rlwoodjr/Router-Files/DRO/DSC_0015.JPG

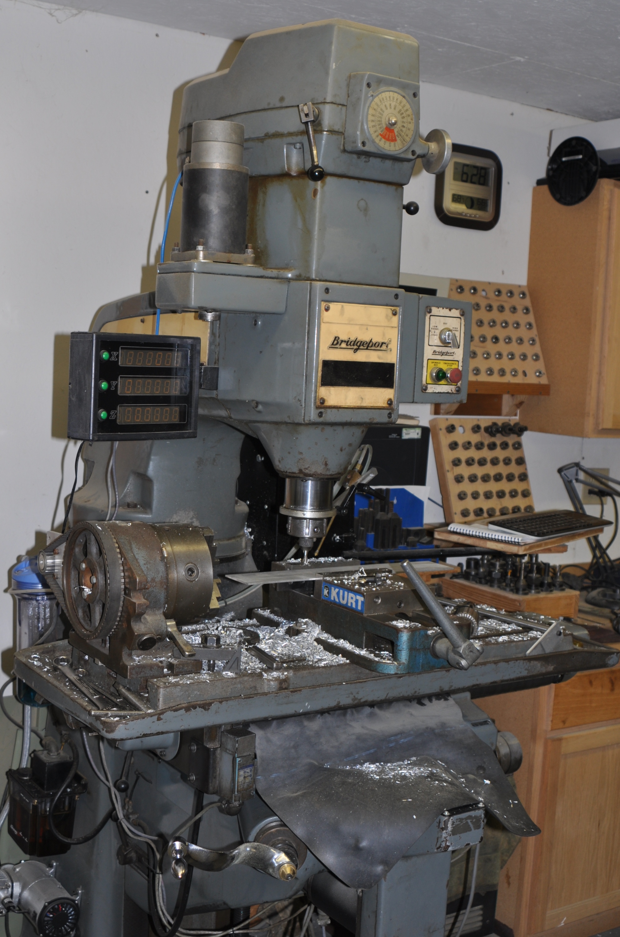
DRO/DSC_0015.JPG
