rlwoodjr/Router-Files/README.md

# Router-Files
Design files for CNC routers

SAFETY FIRST: Never leave a CNC router unattended!  

You will find all my design files free to use and modify for personal or commercial use.  You will need a good understanding to build a safe router. By downloading or using these files you accept full responsibility for your build. This content may be in error. You assume responsibility for any action you take using these designs. 

BobsCNC is trademarked and cannot be used.

If you have questions or missing data, please let me know. 

All parts I have in inventory will be on my eBay store
