rlwoodjr/Router-Files/DRO/DRO1.JPG

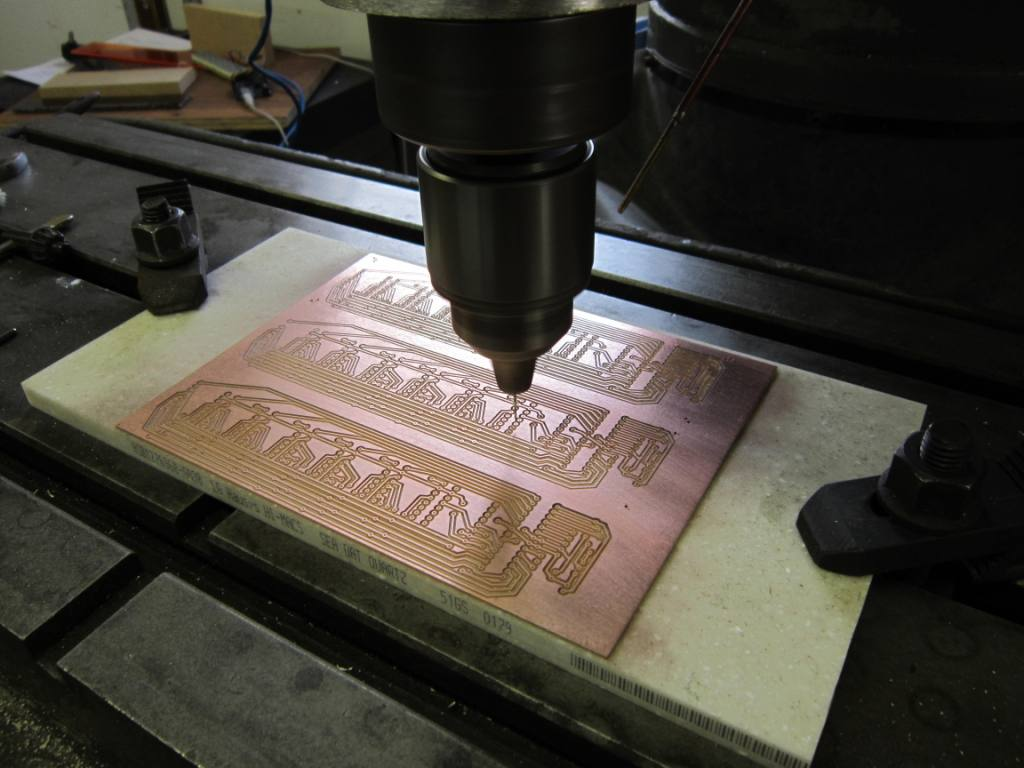
DRO/DRO1.JPG
