rlwoodjr/Router-Files/DRO/DRO2.JPG

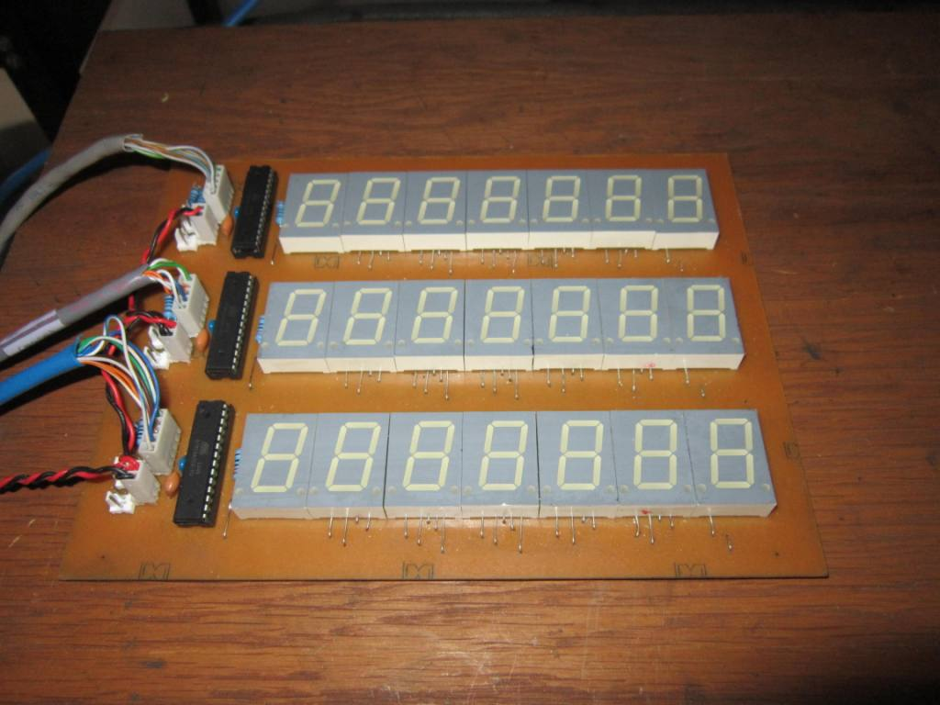
DRO/DRO2.JPG
