rlwoodjr/Router-Files/DRO/DRO3.JPG

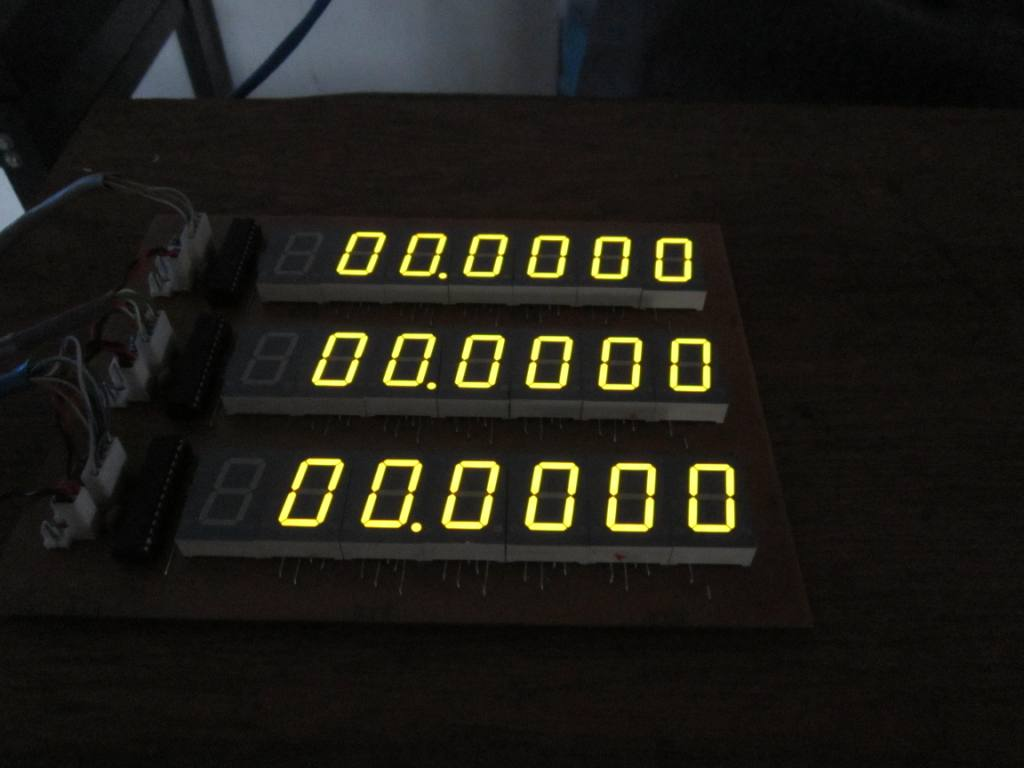
DRO/DRO3.JPG
