rlwoodjr/Router-Files/DRO/DSC_0011.JPG

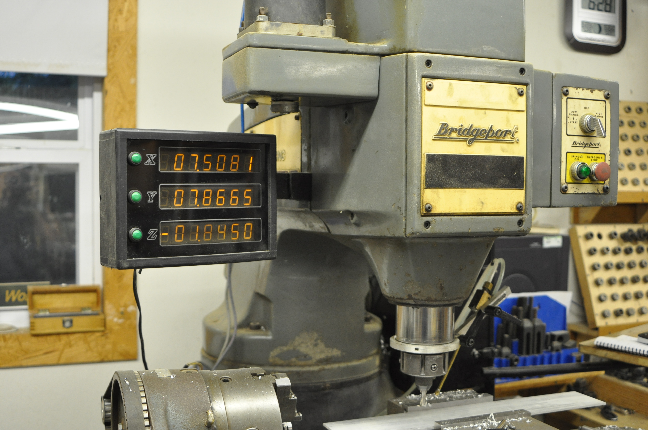
DRO/DSC_0011.JPG
