rlwoodjr/Router-Files/DRO/DSC_0014.JPG

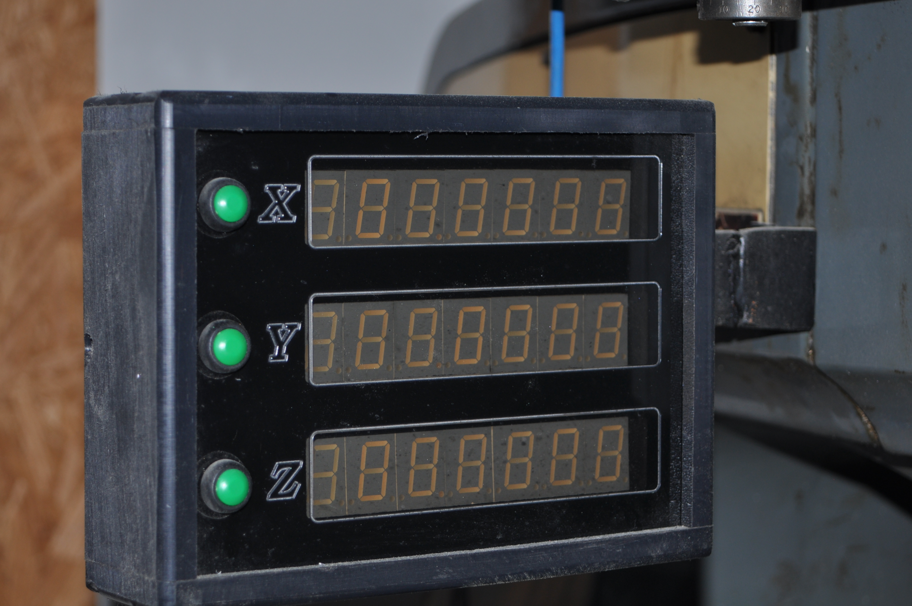
DRO/DSC_0014.JPG
