rlwoodjr/Router-Files/Evolution/Sourced Parts/Tr8 Metric ACME screw B.jpg

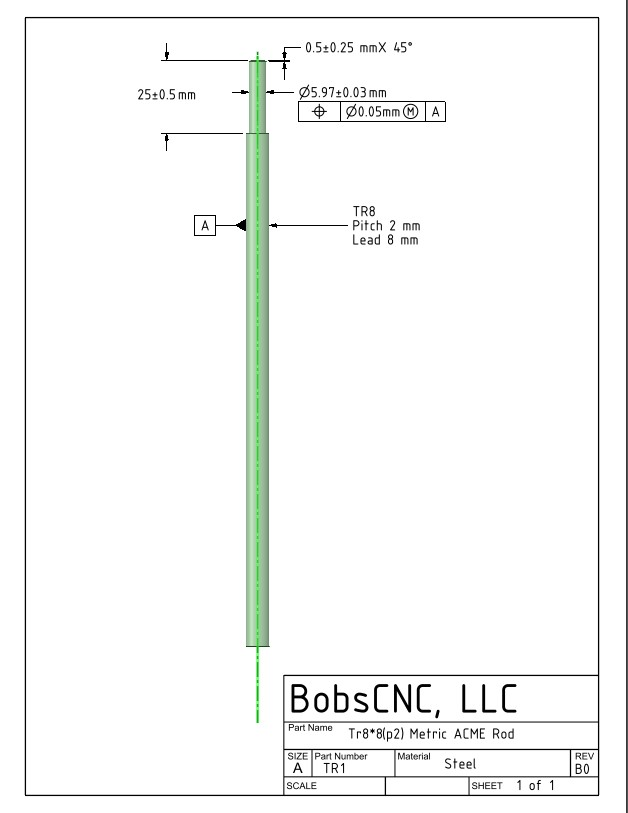
Evolution/Sourced Parts/Tr8 Metric ACME screw B.jpg
