rlwoodjr/Router-Files/Revolution/Sourced parts/TailStock rod.png

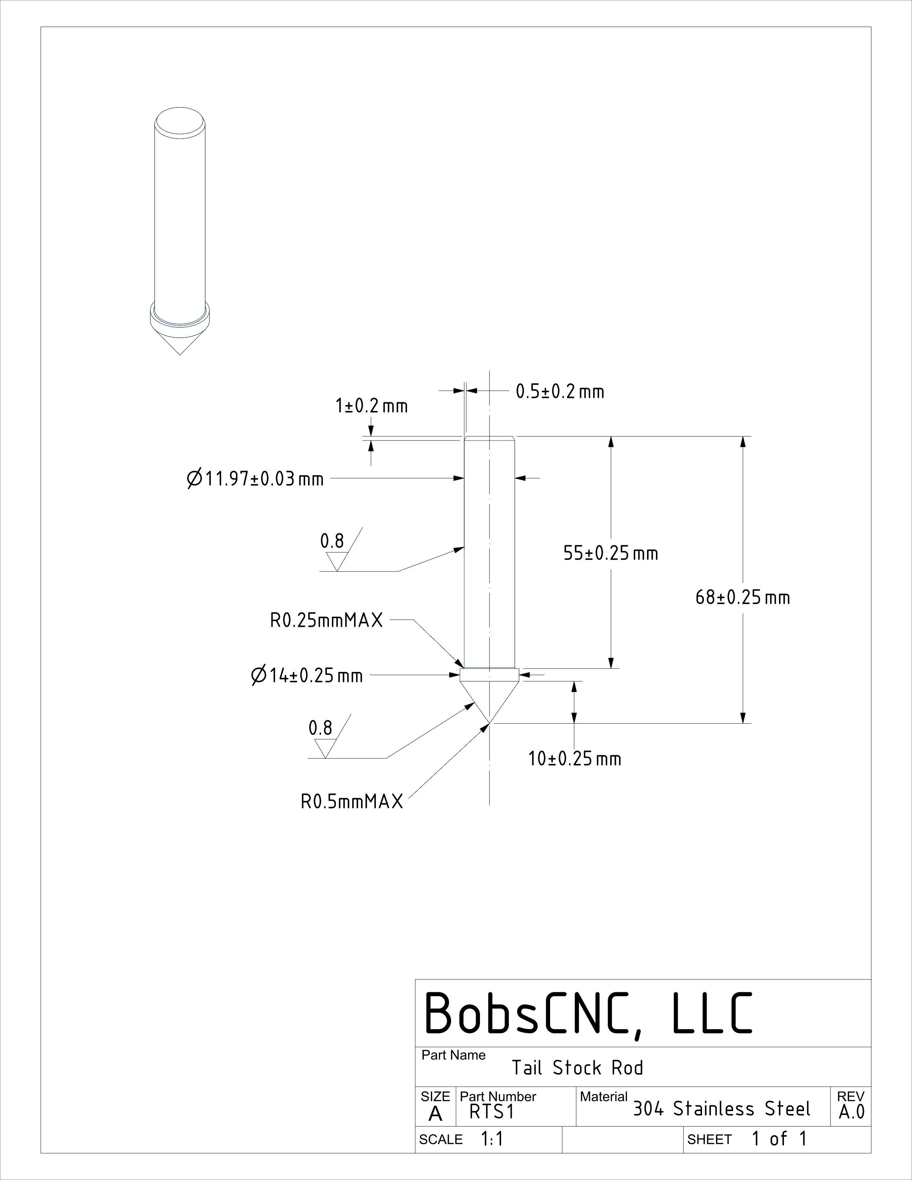
Revolution/Sourced parts/TailStock rod.png
