rlwoodjr/Router-Files/KL7/KL RF1101/RT1101F Z Assembly.dxf

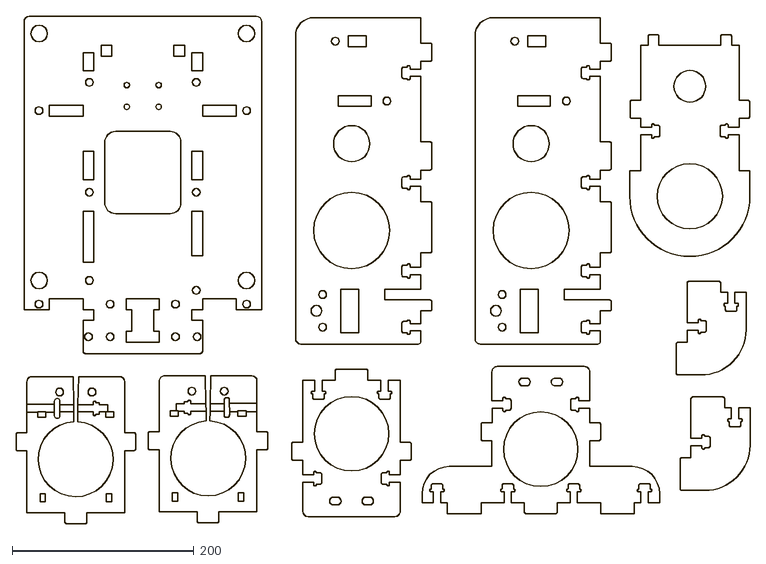
[picture p12: CAD file, 2025-02-18]
KL7/KL RF1101/RT1101F Z Assembly.dxf
808.4 x 558.9
