rlwoodjr/Router-Files/E Series/52mm layout Evolution.dxf

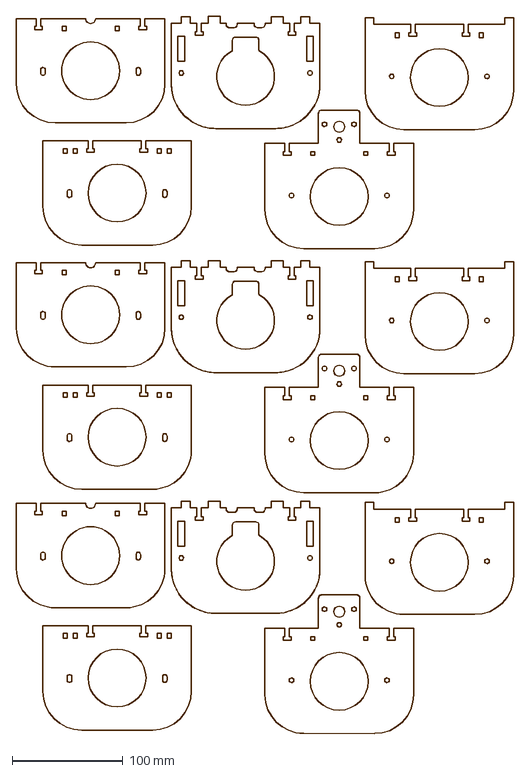
[picture p13: CAD file, 2025-02-18]
E Series/52mm layout Evolution.dxf
448.4 x 646.4 mm
