rlwoodjr/Router-Files/Evolution/E4D2.dxf

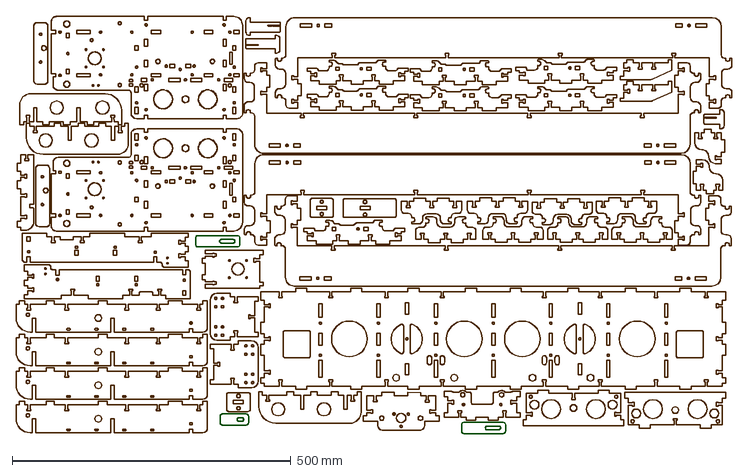
[picture p14: CAD file, 2025-02-18]
Evolution/E4D2.dxf
1282.8 x 747.5 mm
