rlwoodjr/Router-Files/Evolution/Evolution 4 to 5/Extension Layout.stp

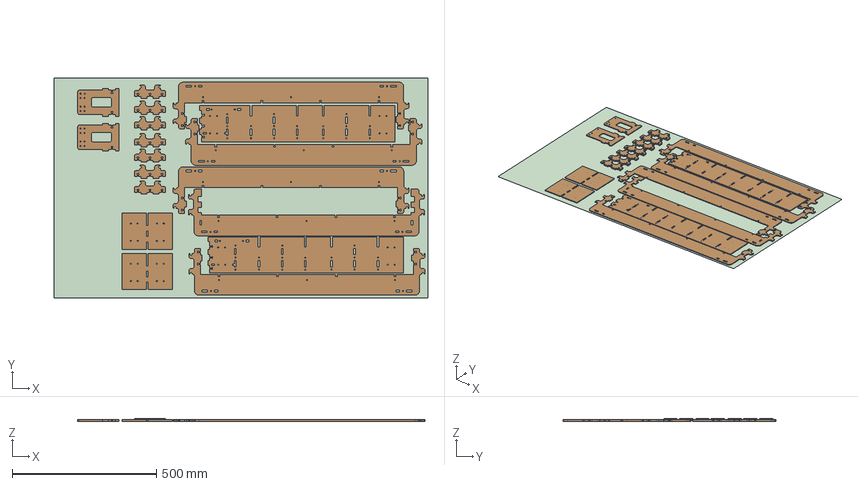
[picture p15: CAD file, 2025-02-19]
Evolution/Evolution 4 to 5/Extension Layout.stp
1295.4 x 762.0 x 9.00 mm
Extension Layout
RailSide2 x 2
ExtBrace x 2
BedBrace2
Rail Support x 7
X harness mount.2 x 2
BedBrace x 4
