rlwoodjr/Router-Files/Evolution/Sourced Parts/EccentricNut.stp

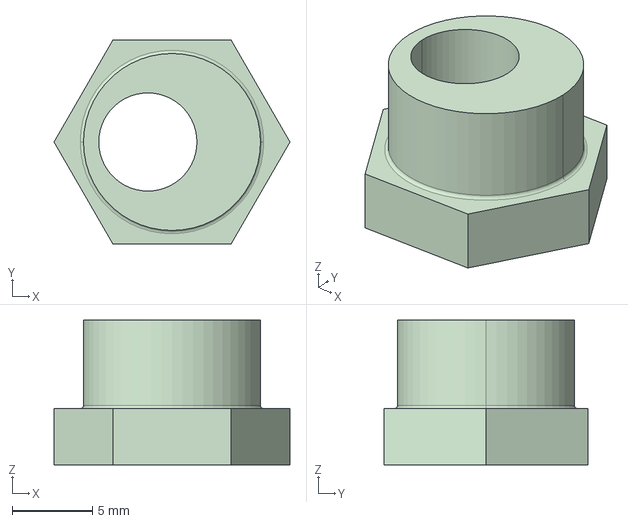
[picture p16: CAD file, 2025-02-18]
Evolution/Sourced Parts/EccentricNut.stp
14.7 x 12.7 x 9.00 mm
