rlwoodjr/Router-Files/KL7/80mm KL7/#Spindlemount 80mm.dxf

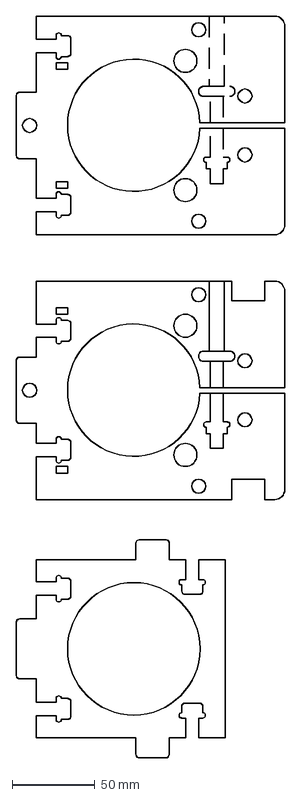
[picture p17: CAD file, 2025-02-15]
KL7/80mm KL7/#Spindlemount 80mm.dxf
162.2 x 448.0 mm
