rlwoodjr/Router-Files/KL7/Control box/PIBoxLayout.stp

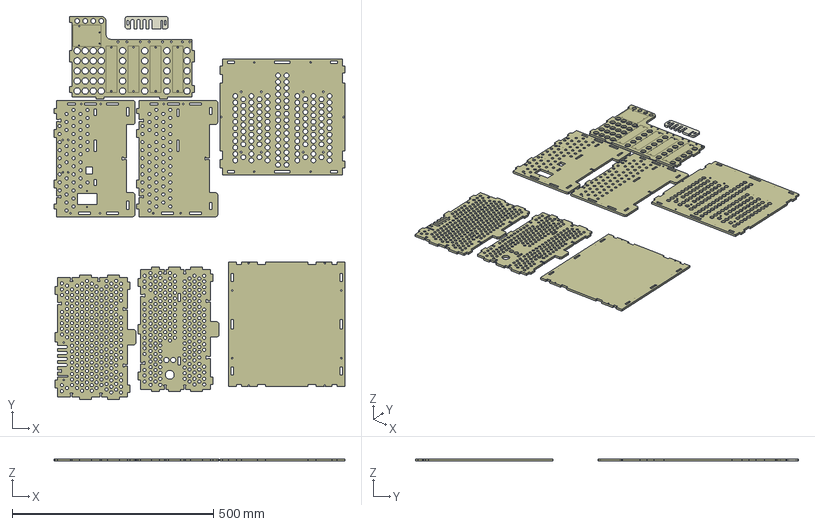
[picture p18: CAD file, 2025-02-15]
KL7/Control box/PIBoxLayout.stp
723.1 x 952.3 x 6.00 mm
Wood Back
Wood Back2
Wood Bottom
Wood shelf
Wood side
Wood side2
Wood top
WireLock
