rlwoodjr/Router-Files/KL7/KL733/KL733 Layout 2.dxf

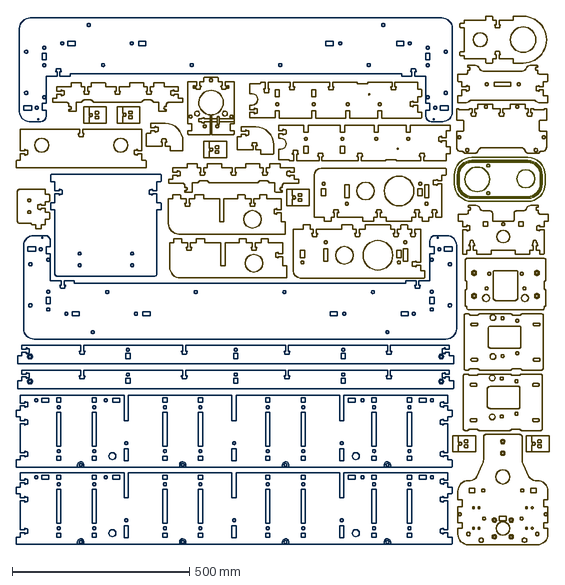
[picture p19: CAD file, 2025-02-15]
KL7/KL733/KL733 Layout 2.dxf
1504.3 x 1491.7 mm
