rlwoodjr/Router-Files/KL7/KL744/#kl744 EXT KIT table.dxf

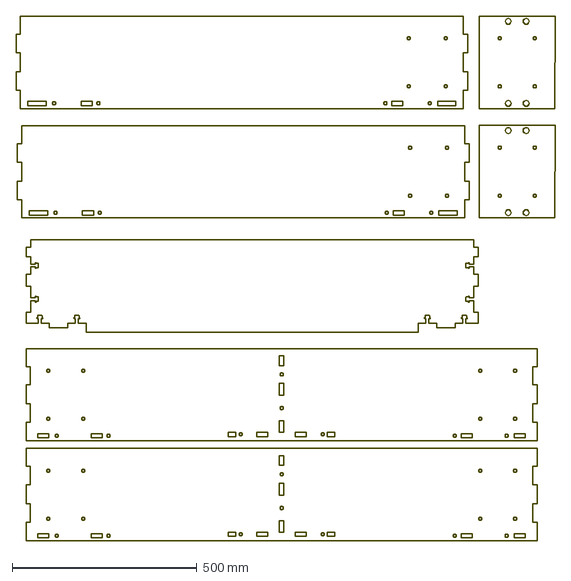
[picture p20: CAD file, 2025-02-15]
KL7/KL744/#kl744 EXT KIT table.dxf
1458.0 x 1419.6 mm
