rlwoodjr/Router-Files/KL8/KL8 Layout5.dxf

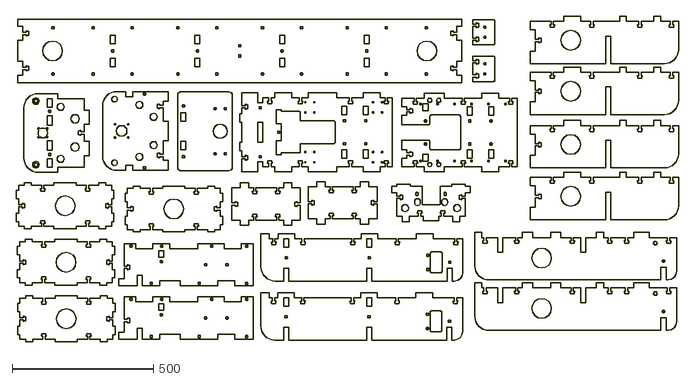
[picture p21: CAD file, 2025-02-15]
KL8/KL8 Layout5.dxf
2345.2 x 1152.7
