rlwoodjr/Router-Files/Other stuff/TramTool.stl

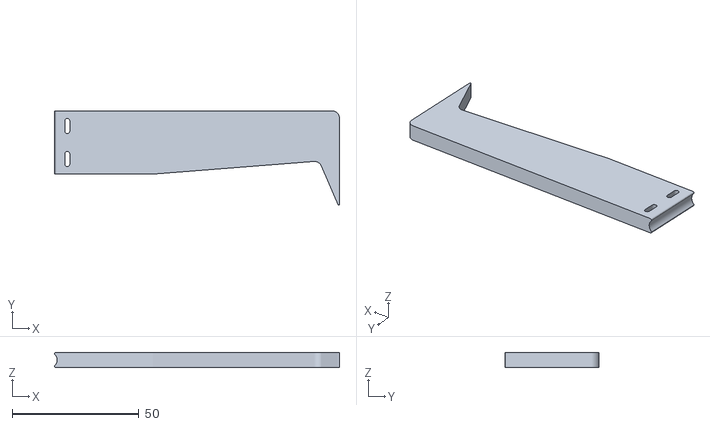
[picture p22: CAD file, 2025-02-18]
Other stuff/TramTool.stl
112.6 x 37.3 x 6.00
