rlwoodjr/Router-Files/Quantum/Q5 Ext.stp

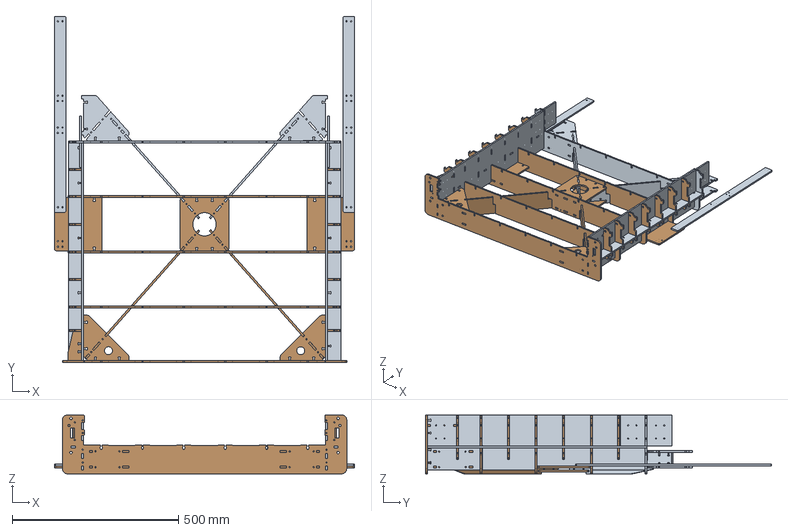
[picture p23: CAD file, 2025-02-18]
Quantum/Q5 Ext.stp
902.4 x 1041.9 x 177.1 mm
RailSide2 x 2
Rail Support x 8
BedBrace2
ExtBrace x 2
X harness mount.2 x 2
EndCap
BedBrace x 2
BedBrace22
X corner brace.2 x 4
Base Support x 2
Base Brace x 2
Base Support2 x 2
X corner brace.E x 4
XE Support x 2
belt brace
Harness extension x 2
