rlwoodjr/Router-Files/Revolution/Guage block.dxf

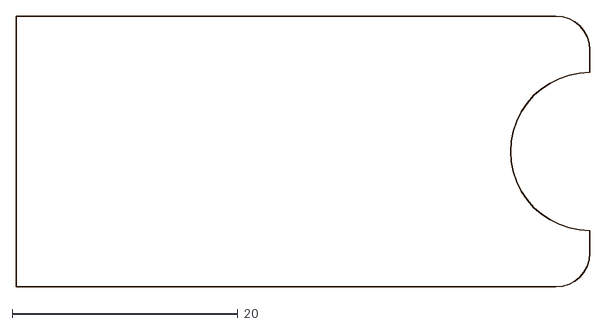
[picture p24: CAD file, 2025-05-22]
Revolution/Guage block.dxf
50.8 x 24.0
