rlwoodjr/Router-Files/Evolution/E4M1.dxf

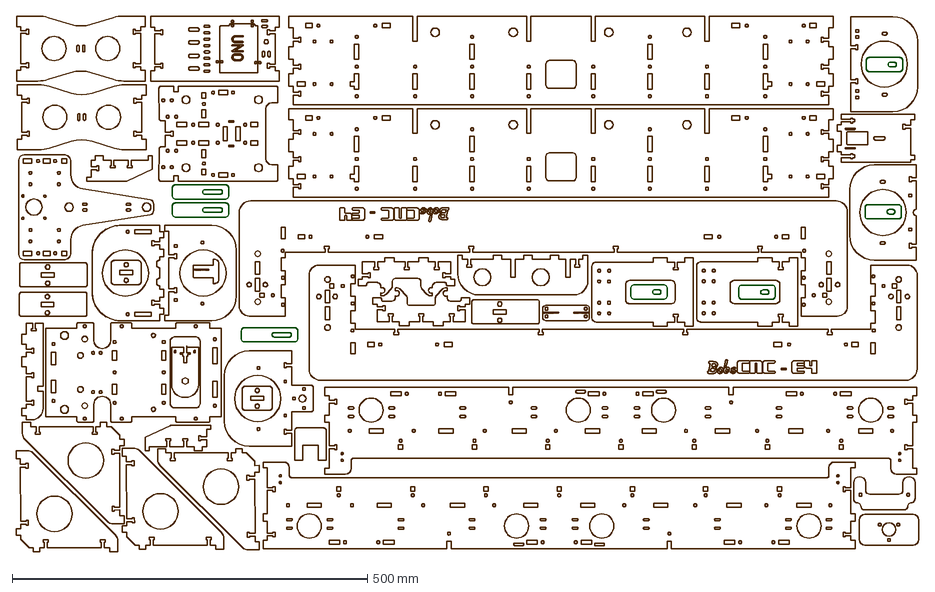
[picture p26: CAD file, 2025-02-18]
Evolution/E4M1.dxf
1269.7 x 754.0 mm
