rlwoodjr/Router-Files/KL7/KL733/KL733 Layout 1.dxf

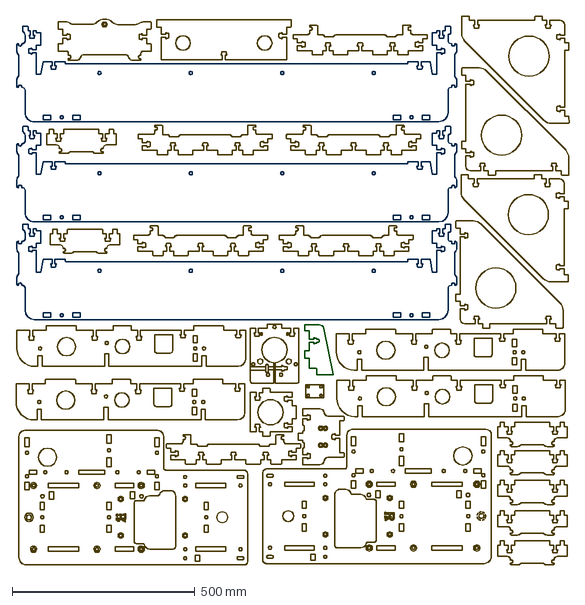
[picture p27: CAD file, 2025-02-15]
KL7/KL733/KL733 Layout 1.dxf
1511.4 x 1499.9 mm
