rlwoodjr/Router-Files/KL7/KL744/KL744 Layout2.dxf

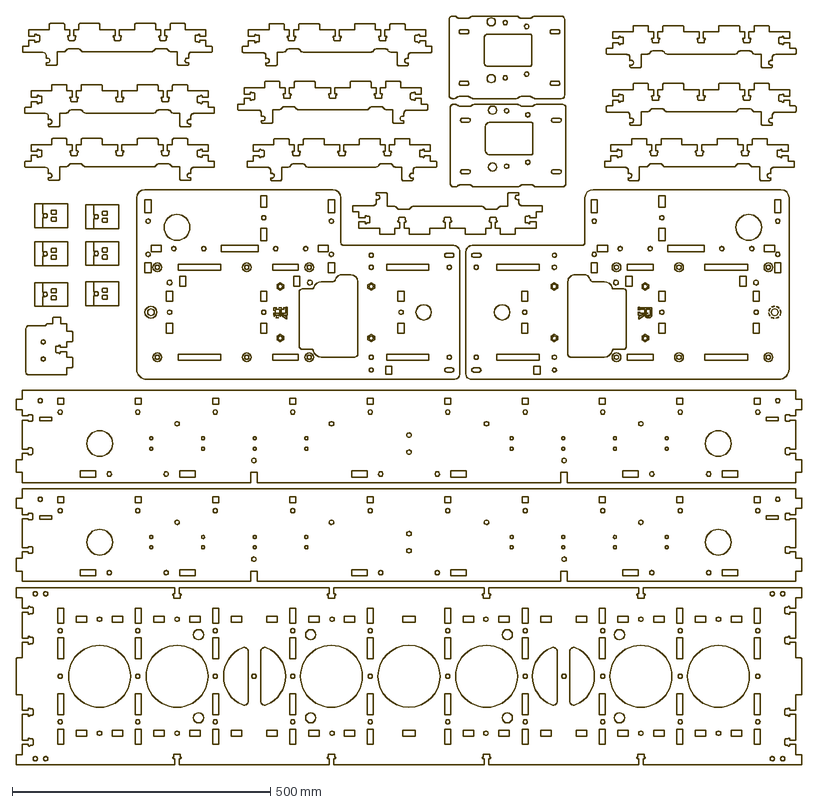
[picture p28: CAD file, 2025-02-15]
KL7/KL744/KL744 Layout2.dxf
1521.0 x 1449.0 mm
