rlwoodjr/Router-Files/KL8/KL8 Layout4.dxf

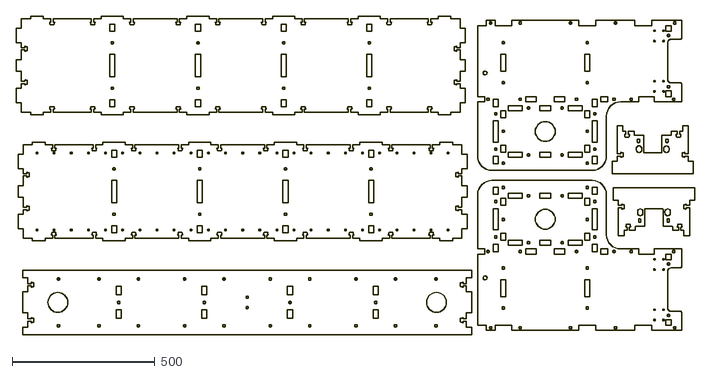
[picture p29: CAD file, 2025-02-15]
KL8/KL8 Layout4.dxf
2375.3 x 1114.9
