rlwoodjr/Router-Files/Quantum/Quantum3 Layout.dxf

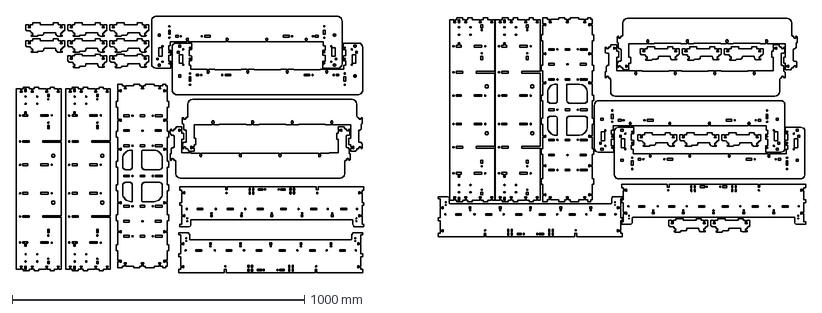
[picture p30: CAD file, 2025-02-18]
Quantum/Quantum3 Layout.dxf
2702.1 x 877.4 mm
