rlwoodjr/Router-Files/Revolution/LW Chuck layout.dxf

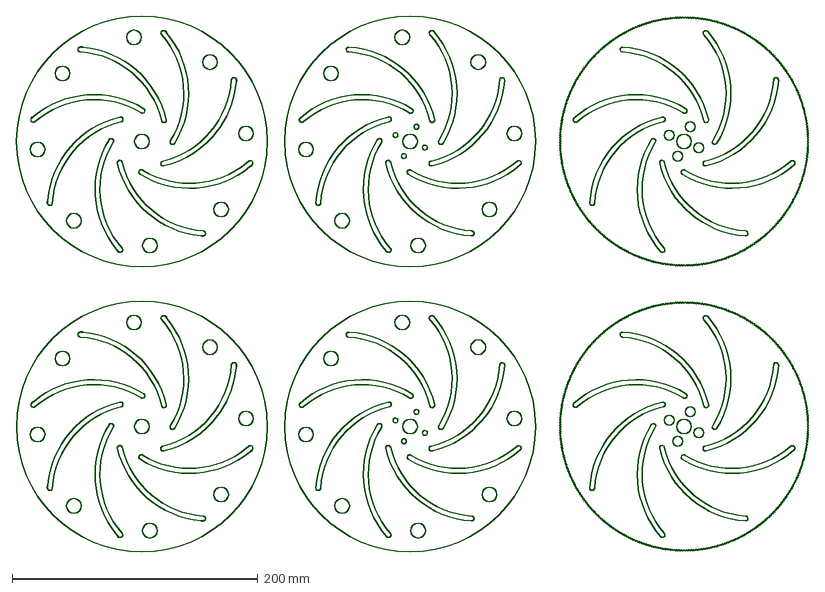
[picture p31: CAD file, 2025-02-15]
Revolution/LW Chuck layout.dxf
644.4 x 436.0 mm
