rlwoodjr/Router-Files/Evolution/Evo4V3Layout.dxf

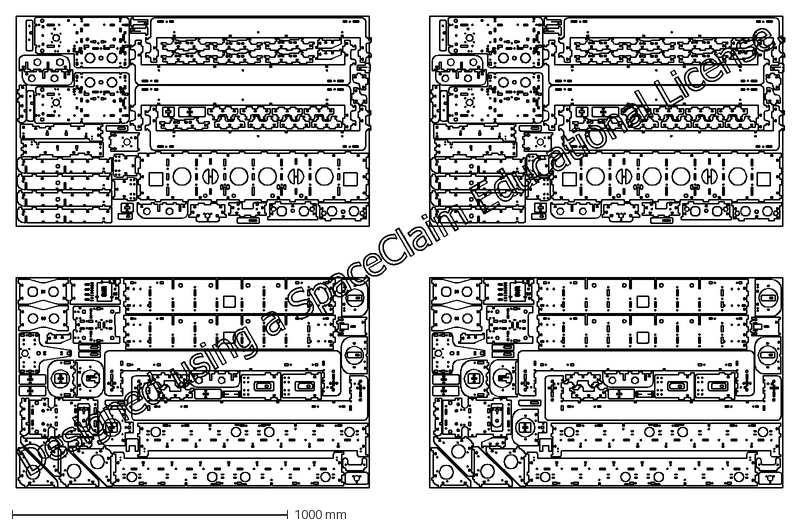
[picture p33: CAD file, 2025-02-18]
Evolution/Evo4V3Layout.dxf
2785.2 x 1710.9 mm
