rlwoodjr/Router-Files/KL7/KL733/Belt Pulley gage.dxf

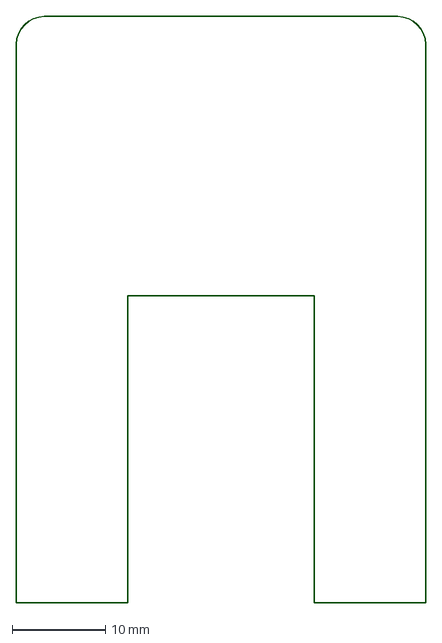
[picture p34: CAD file, 2025-02-15]
KL7/KL733/Belt Pulley gage.dxf
44.0 x 63.0 mm
