rlwoodjr/Router-Files/KL7/KL744/44TB.dxf

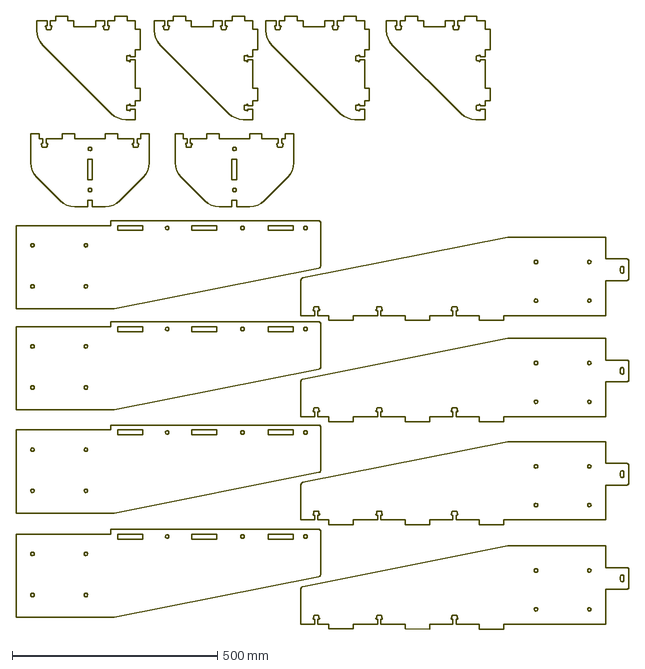
[picture p35: CAD file, 2025-02-15]
KL7/KL744/44TB.dxf
1491.8 x 1491.8 mm
