rlwoodjr/Router-Files/KL8/KL8 Layout2.dxf

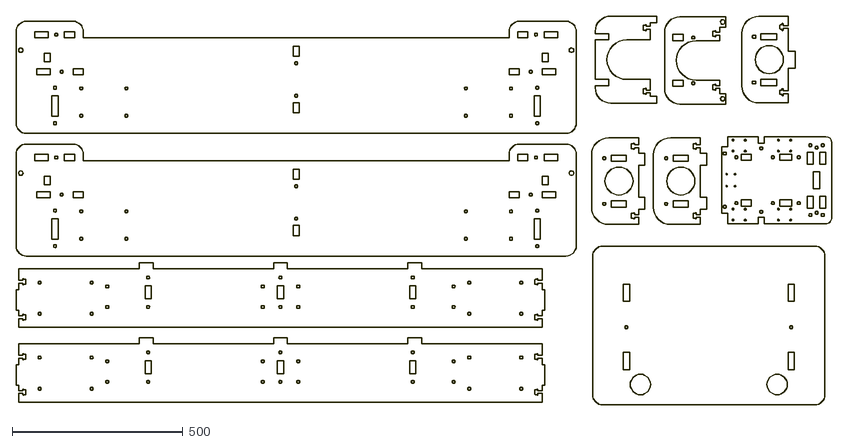
[picture p36: CAD file, 2025-02-15]
KL8/KL8 Layout2.dxf
2388.6 x 1138.8
