rlwoodjr/Router-Files/Quantum/Quantum 4 Layout.dxf

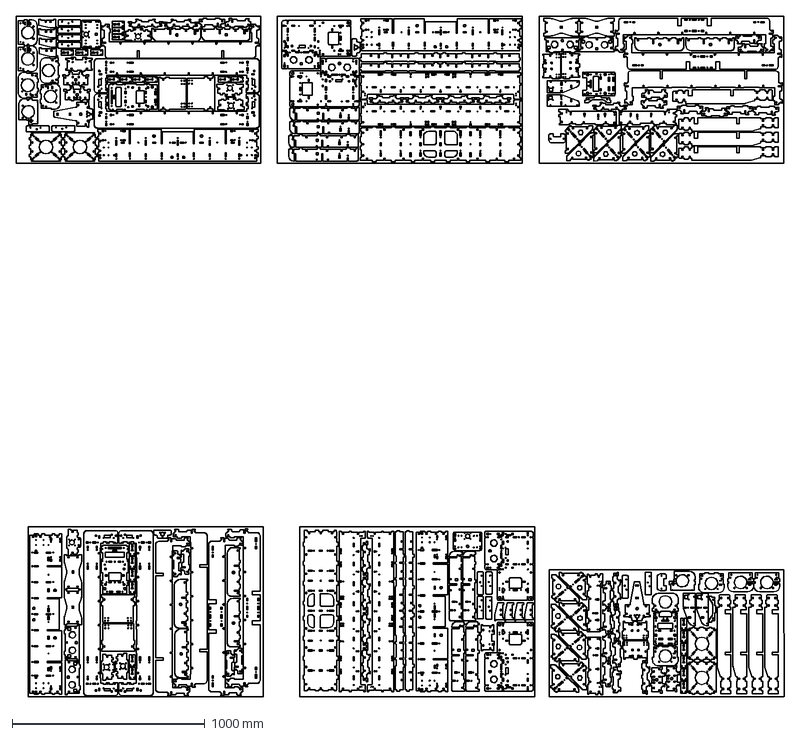
[picture p37: CAD file, 2025-02-18]
Quantum/Quantum 4 Layout.dxf
3985.1 x 3531.4 mm
