rlwoodjr/Router-Files/Revolution/RM Layout 1.dxf

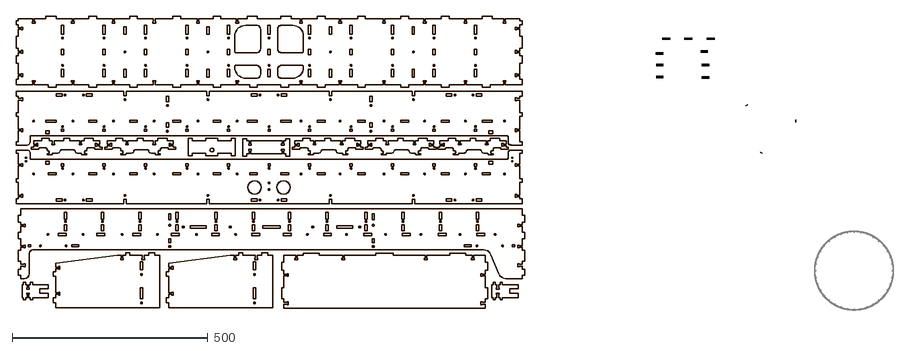
[picture p38: CAD file, 2025-02-15]
Revolution/RM Layout 1.dxf
2243.0 x 751.4
