rlwoodjr/Router-Files/E Series/E4V3L2.dxf

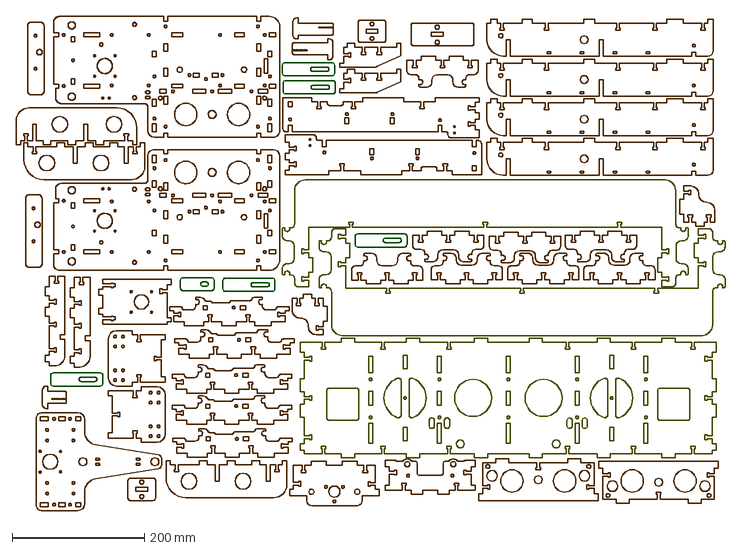
[picture p39: CAD file, 2025-02-18]
E Series/E4V3L2.dxf
1074.1 x 748.4 mm
