rlwoodjr/Router-Files/KL7/KL733/SideBrace.dxf

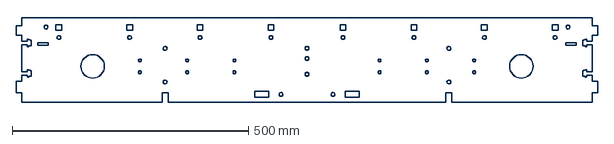
[picture p41: CAD file, 2025-02-15]
KL7/KL733/SideBrace.dxf
1231.0 x 178.9 mm
