rlwoodjr/Router-Files/KL7/KL744/kl744 EXT KIT.dxf

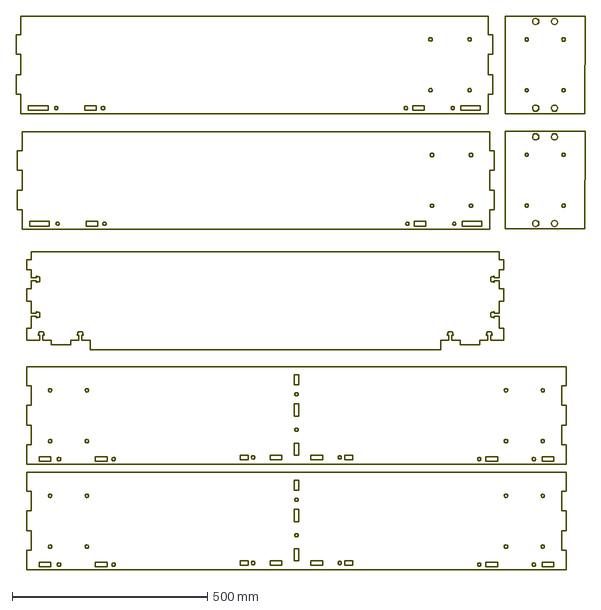
[picture p42: CAD file, 2025-02-15]
KL7/KL744/kl744 EXT KIT.dxf
1458.0 x 1419.6 mm
