rlwoodjr/Router-Files/KL8/KL8 Layout3.dxf

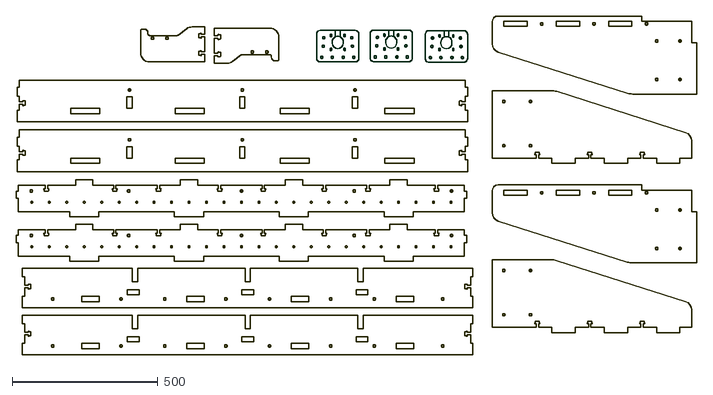
[picture p43: CAD file, 2025-02-15]
KL8/KL8 Layout3.dxf
2338.6 x 1164.6
