rlwoodjr/Router-Files/Quantum/Quantum5 Layout.dxf

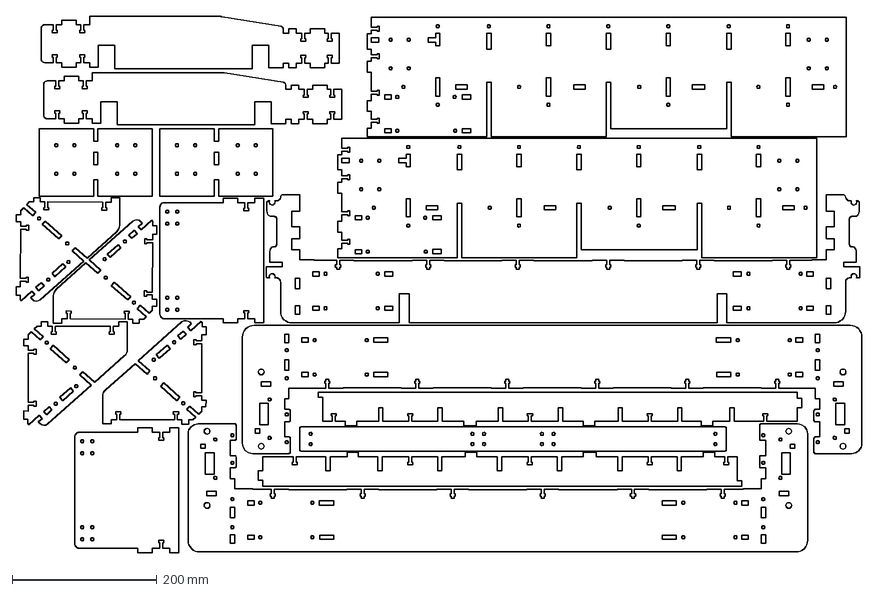
[picture p44: CAD file, 2025-02-18]
Quantum/Quantum5 Layout.dxf
1168.3 x 740.5 mm
