rlwoodjr/Router-Files/Revolution/RM Layout 4.dxf

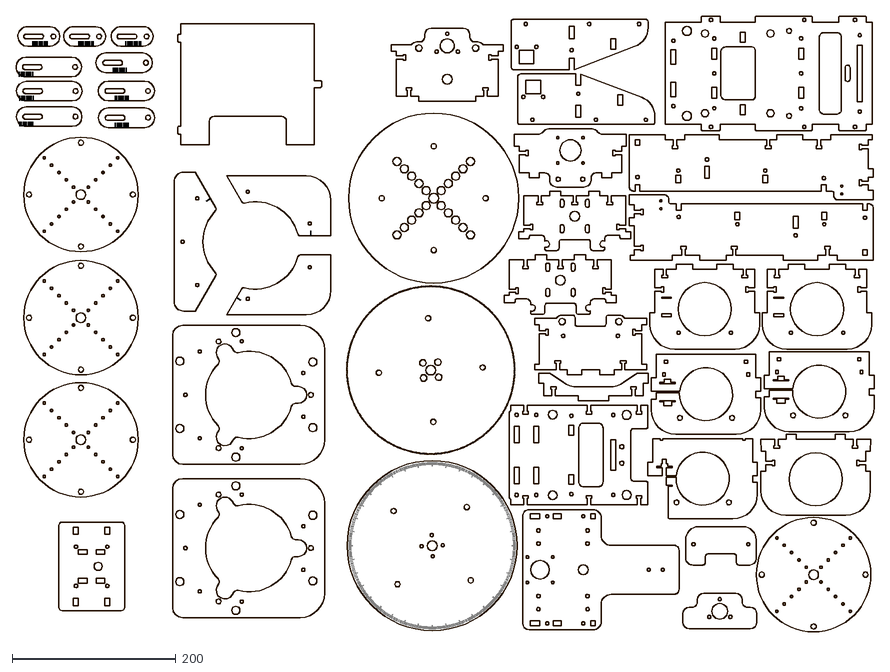
[picture p45: CAD file, 2025-02-15]
Revolution/RM Layout 4.dxf
1049.4 x 753.0
