rlwoodjr/Router-Files/E Series/Layout2.dxf

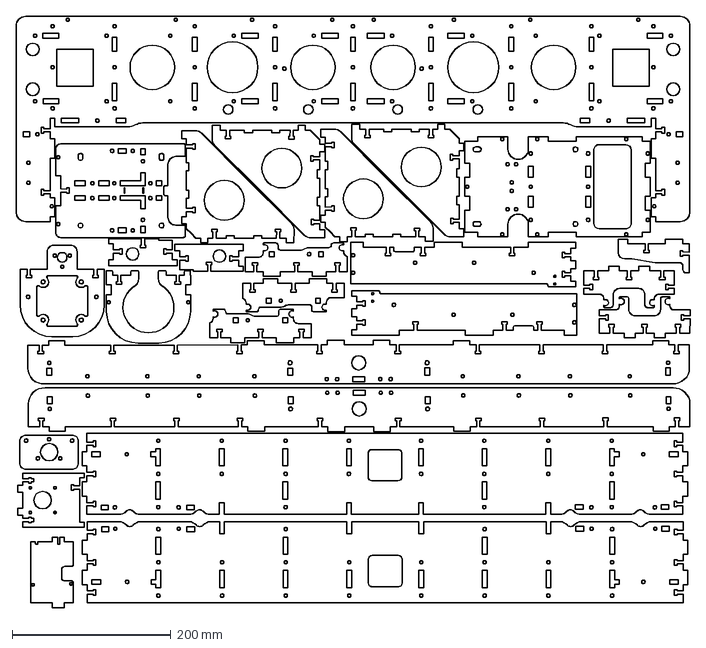
[picture p46: CAD file, 2025-02-18]
E Series/Layout2.dxf
848.0 x 743.6 mm
