rlwoodjr/Router-Files/Evolution/E4M2.dxf

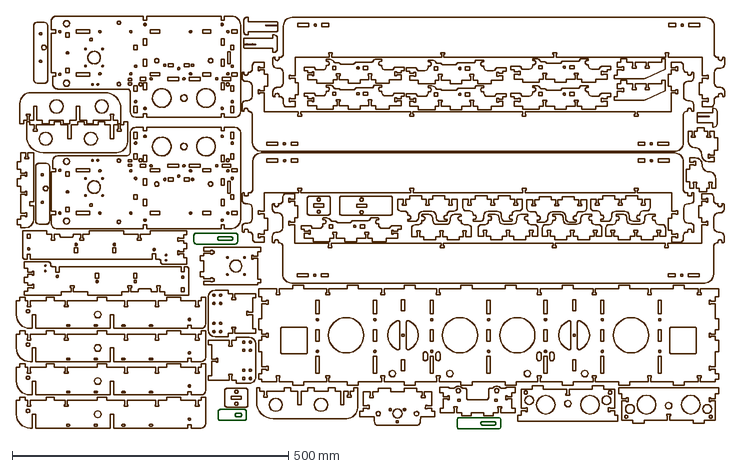
[picture p47: CAD file, 2025-02-18]
Evolution/E4M2.dxf
1282.8 x 747.5 mm
