rlwoodjr/Router-Files/KL7/KL733/Xhome switch mount.dxf

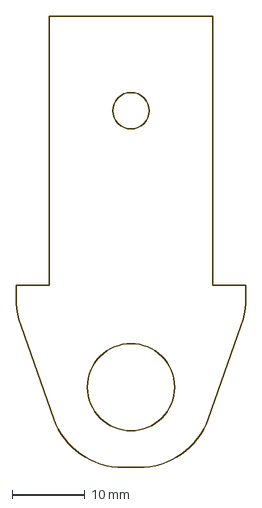
[picture p48: CAD file, 2025-02-15]
KL7/KL733/Xhome switch mount.dxf
31.6 x 62.1 mm
