rlwoodjr/Router-Files/KL7/KL744/KL744 Layout3.dxf

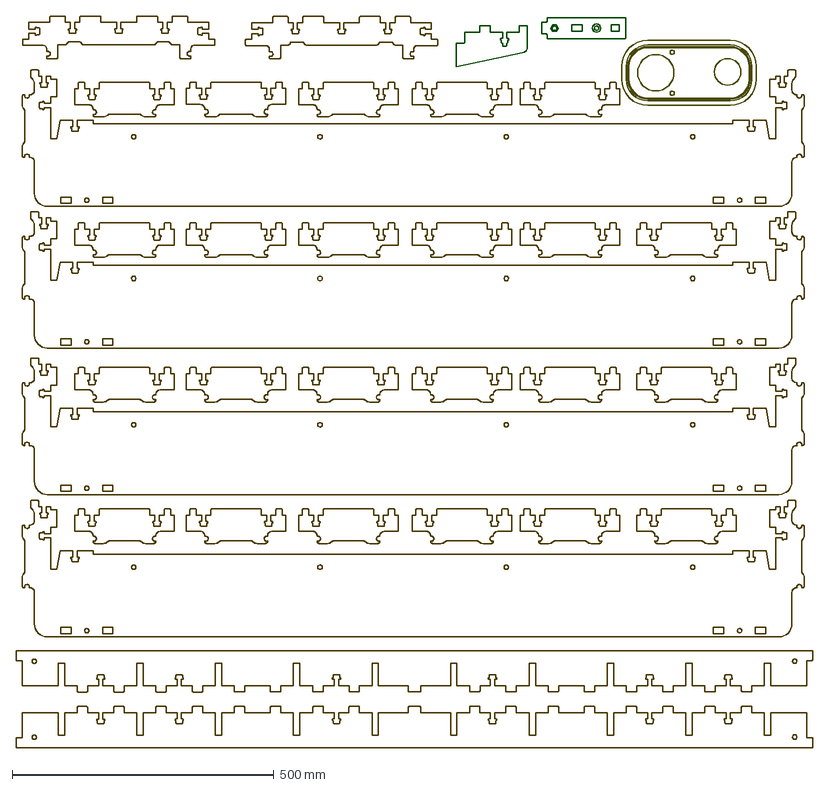
[picture p49: CAD file, 2025-02-15]
KL7/KL744/KL744 Layout3.dxf
1521.0 x 1396.2 mm
