rlwoodjr/Router-Files/KL8/KL8 Layout1.dxf

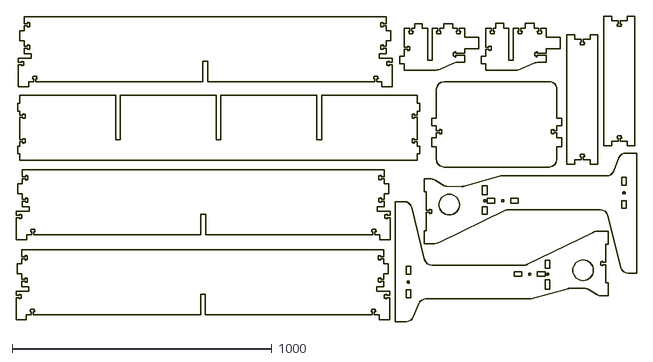
[picture p50: CAD file, 2025-02-15]
KL8/KL8 Layout1.dxf
2392.4 x 1177.3
