rlwoodjr/Router-Files/Revolution/RM Layout 2.dxf

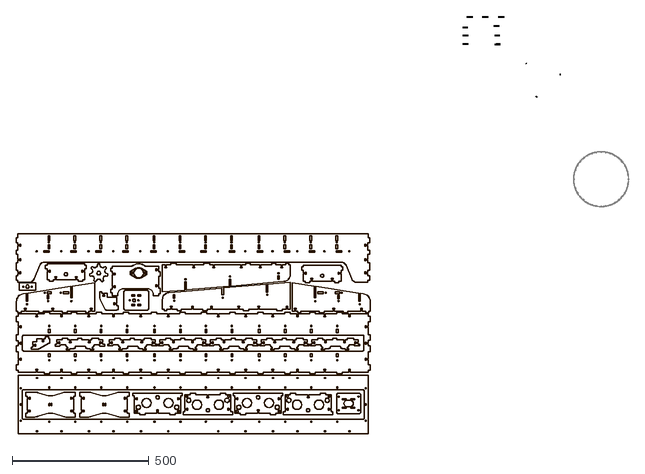
[picture p51: CAD file, 2025-02-15]
Revolution/RM Layout 2.dxf
2241.4 x 1526.0
