rlwoodjr/Router-Files/E Series/Layout.dxf

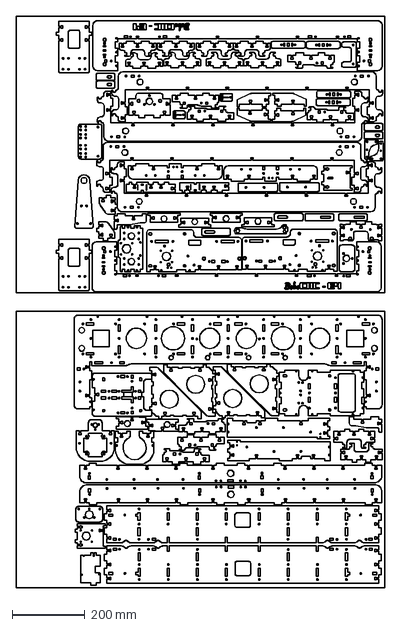
[picture p52: CAD file, 2025-02-18]
E Series/Layout.dxf
1016.0 x 1574.8 mm
