rlwoodjr/Router-Files/KL7/KL733/KL733 Layout 3.dxf

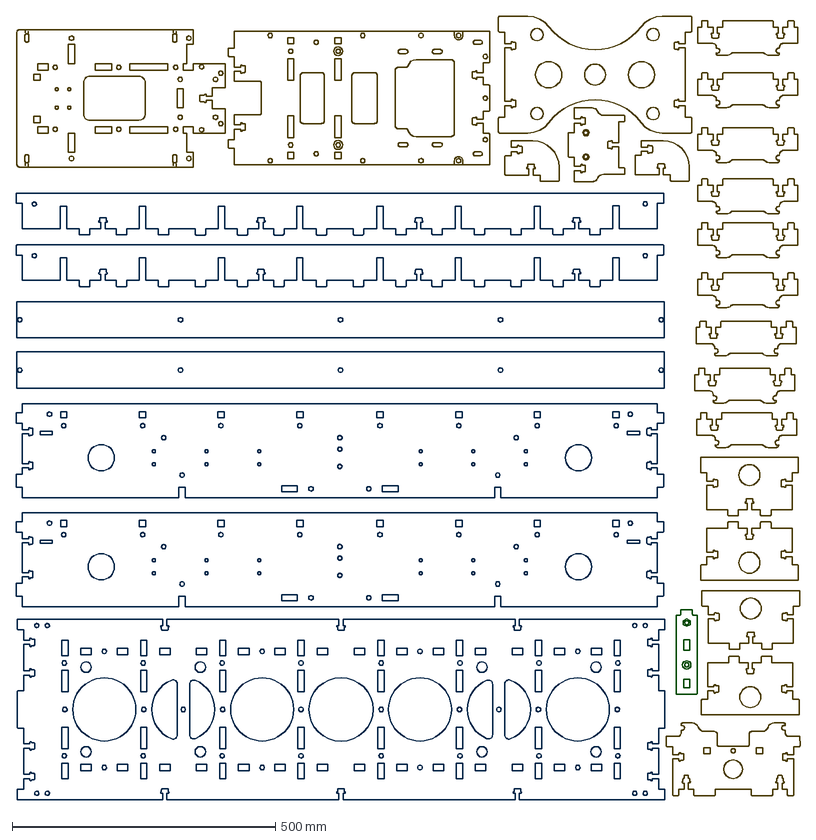
[picture p53: CAD file, 2025-02-15]
KL7/KL733/KL733 Layout 3.dxf
1490.0 x 1488.9 mm
