rlwoodjr/Router-Files/KL7/KL744/vacuum.dxf

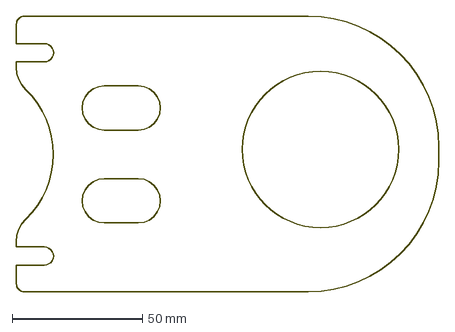
[picture p54: CAD file, 2025-02-15]
KL7/KL744/vacuum.dxf
162.0 x 105.7 mm
