rlwoodjr/Router-Files/Revolution/RM Layout 3.dxf

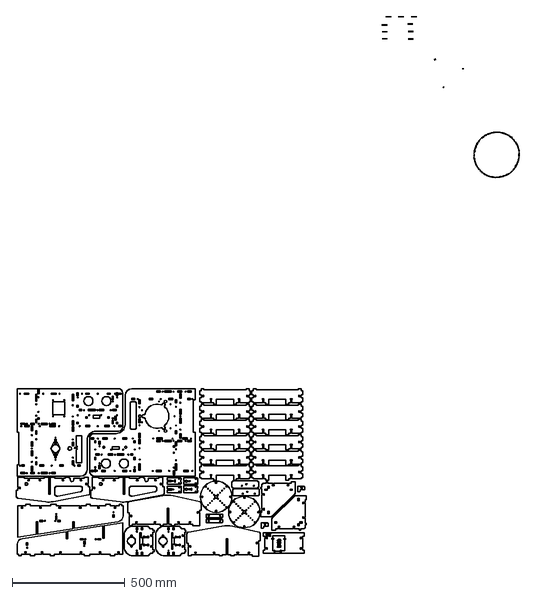
[picture p55: CAD file, 2025-02-15]
Revolution/RM Layout 3.dxf
2235.4 x 2399.5 mm
