rlwoodjr/Router-Files/E Series/E4sp1.dxf

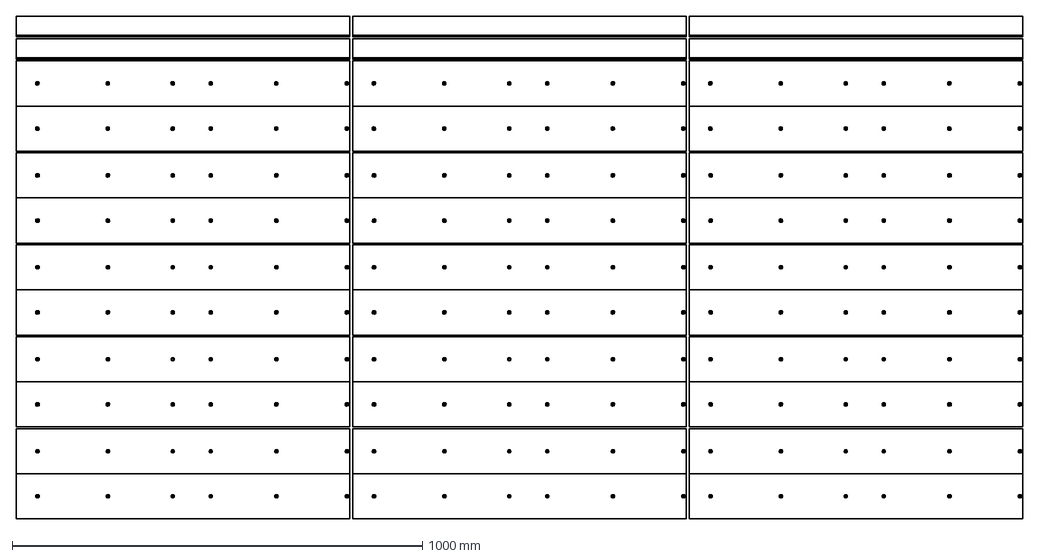
[picture p56: CAD file, 2025-02-18]
E Series/E4sp1.dxf
2453.2 x 1225.0 mm
