rlwoodjr/Router-Files/KL7/KL733/KL7 test.dxf

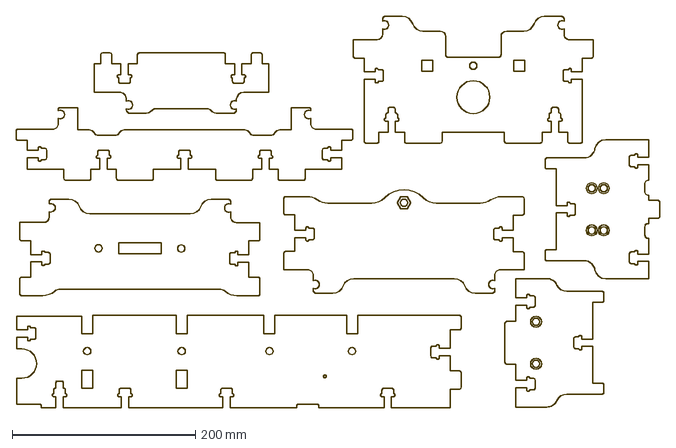
[picture p57: CAD file, 2025-02-15]
KL7/KL733/KL7 test.dxf
701.9 x 426.7 mm
