rlwoodjr/Router-Files/KL7/KL744/KL744 Layout1.dxf

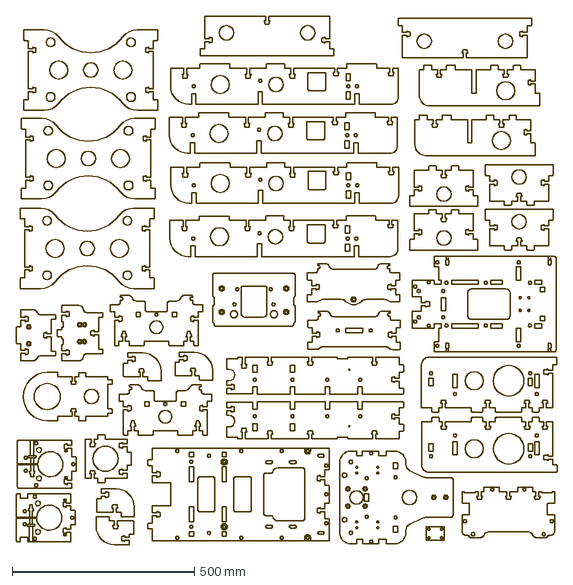
[picture p58: CAD file, 2025-02-15]
KL7/KL744/KL744 Layout1.dxf
1484.7 x 1449.6 mm
