rlwoodjr/Router-Files/E Series/E4sp2.dxf

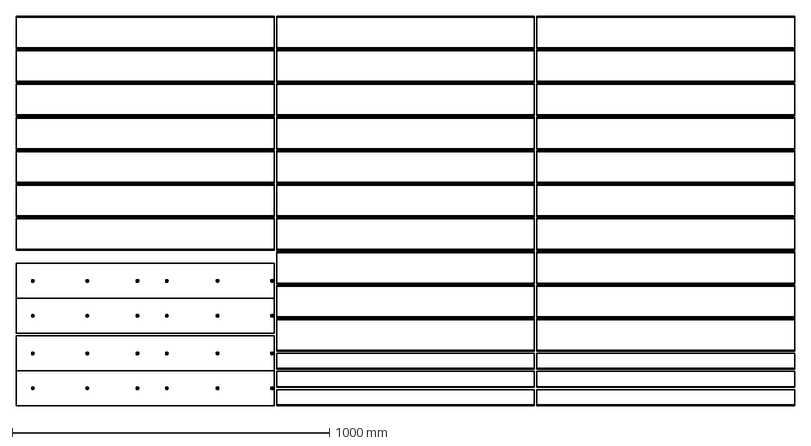
[picture p59: CAD file, 2025-02-18]
E Series/E4sp2.dxf
2452.9 x 1227.2 mm
