rlwoodjr/Router-Files/KL7/KL744/44TA.dxf

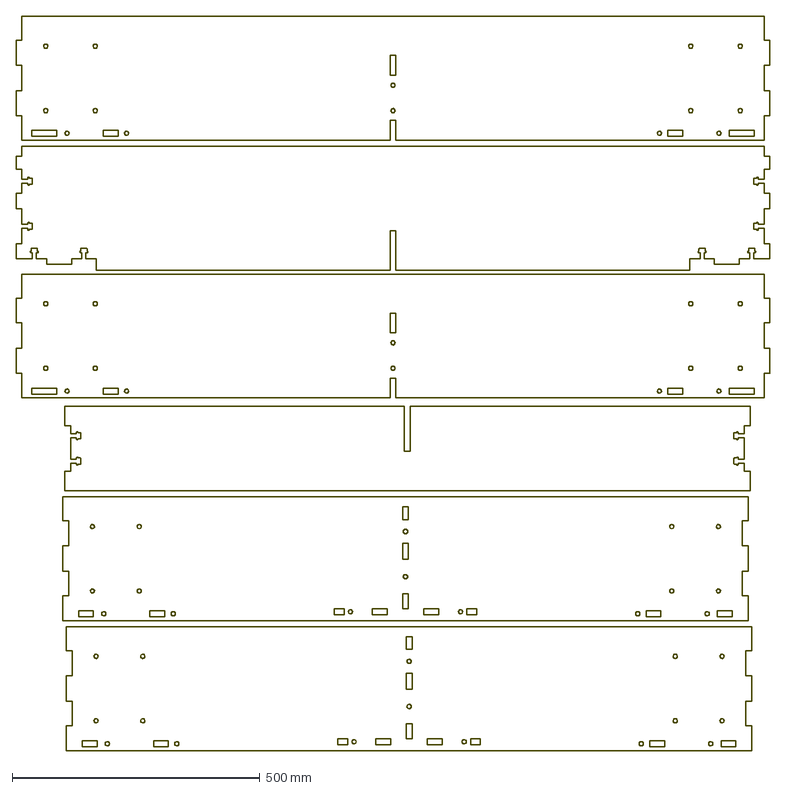
[picture p60: CAD file, 2025-02-15]
KL7/KL744/44TA.dxf
1521.0 x 1481.2 mm
