rlwoodjr/Router-Files/E Series/Layout1.dxf

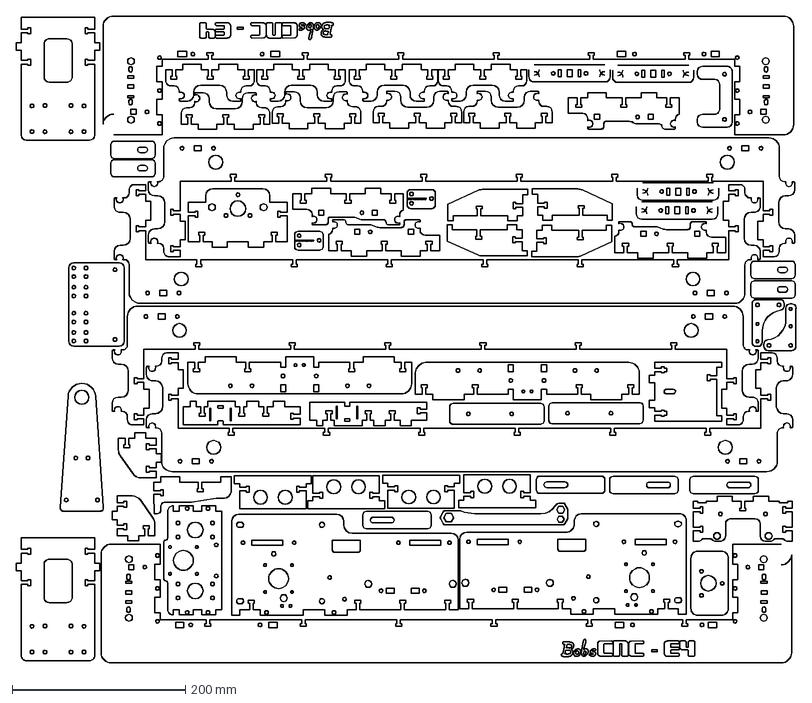
[picture p61: CAD file, 2025-02-18]
E Series/Layout1.dxf
899.8 x 746.3 mm
