rlwoodjr/Router-Files/KL7/KL744/#KL744E2.dxf

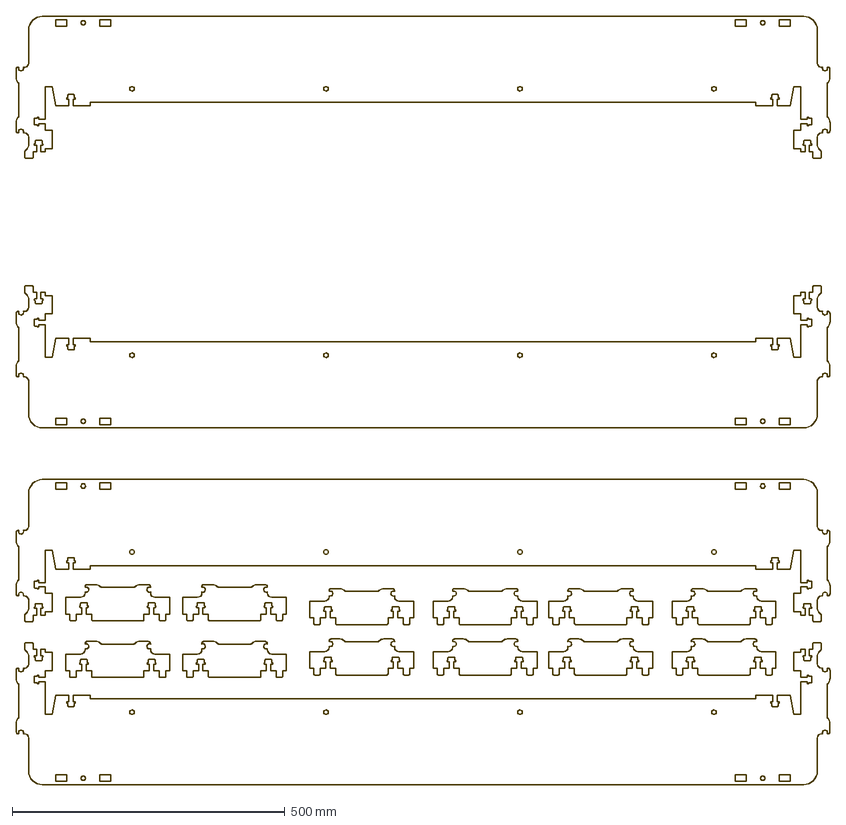
[picture p62: CAD file, 2025-02-15]
KL7/KL744/#KL744E2.dxf
1492.4 x 1408.8 mm
