rlwoodjr/Router-Files/E Series/E3M1.dxf

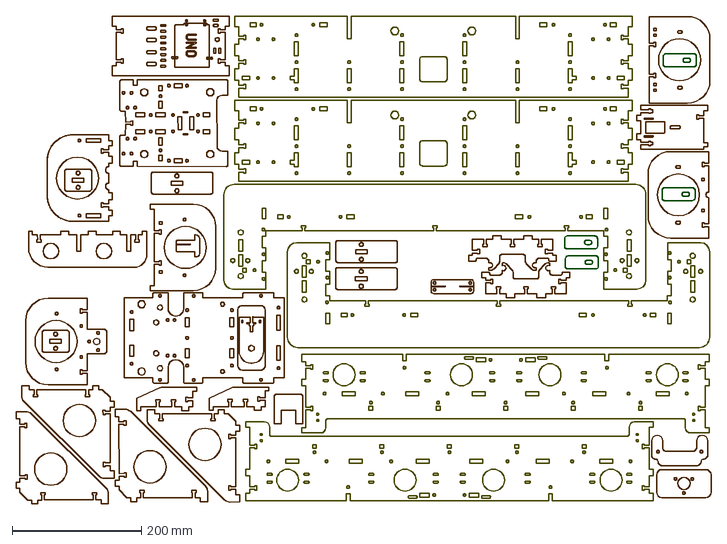
[picture p63: CAD file, 2025-02-18]
E Series/E3M1.dxf
1074.3 x 753.8 mm
