rlwoodjr/Router-Files/KL7/KL744/Xhome switch mount.dxf

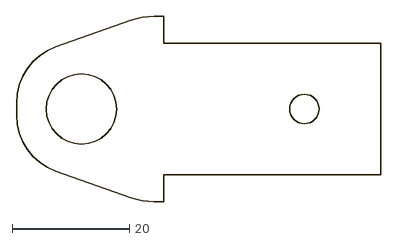
[picture p64: CAD file, 2025-02-15]
KL7/KL744/Xhome switch mount.dxf
62.1 x 31.6
