rlwoodjr/Router-Files/E Series/E3D2.dxf

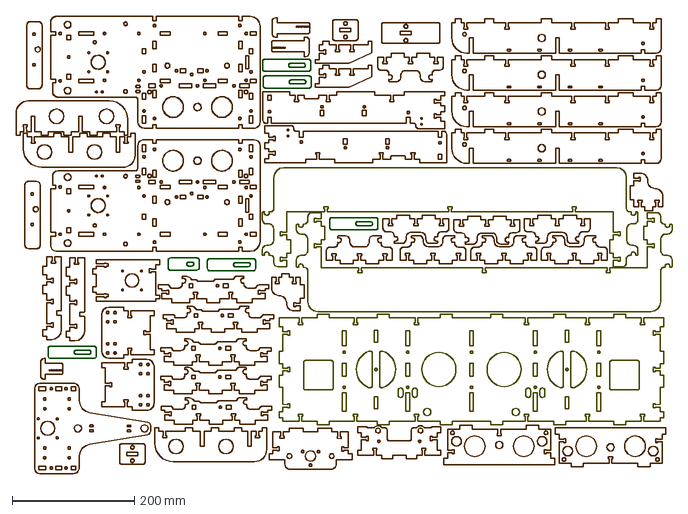
[picture p65: CAD file, 2025-02-18]
E Series/E3D2.dxf
1074.1 x 748.4 mm
