rlwoodjr/Router-Files/KL7/KL744/#KL744E1.dxf

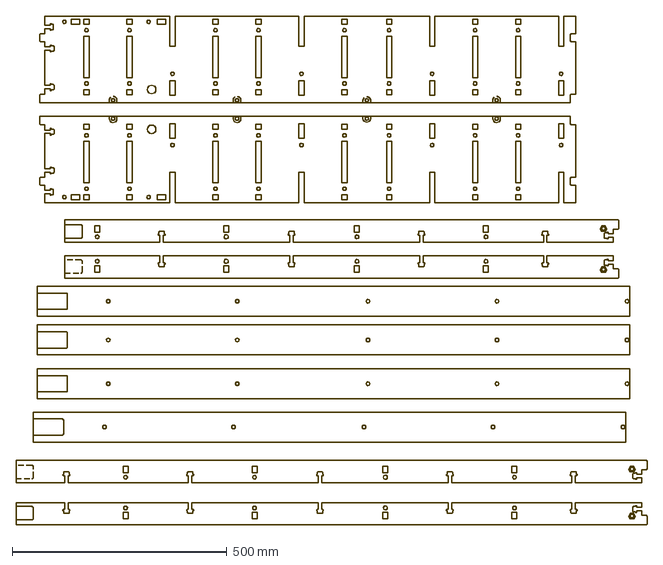
[picture p66: CAD file, 2025-02-15]
KL7/KL744/#KL744E1.dxf
1467.6 x 1183.8 mm
