rlwoodjr/Router-Files/E Series/E3D1.dxf

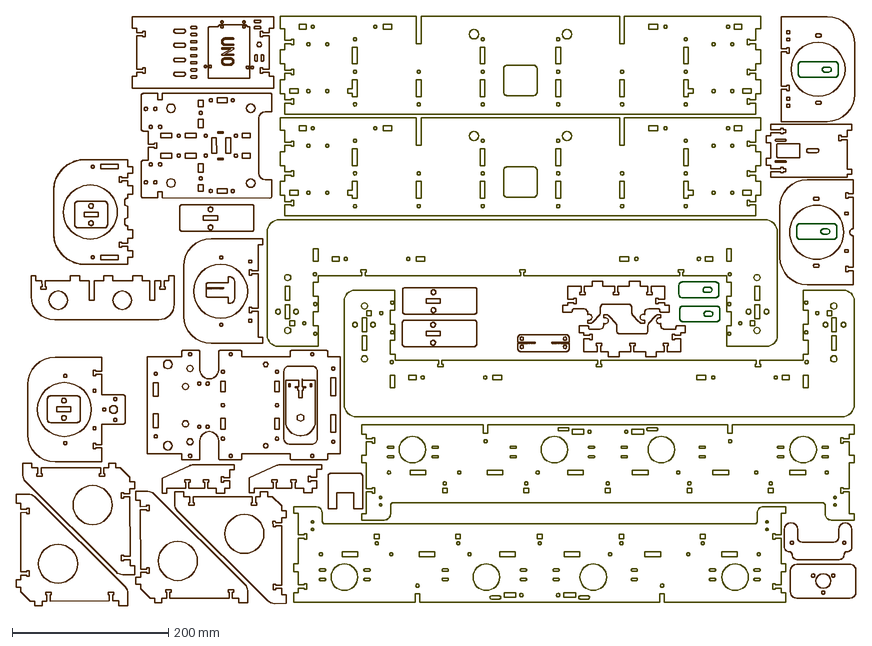
[picture p67: CAD file, 2025-02-18]
E Series/E3D1.dxf
1074.3 x 753.8 mm
