rlwoodjr/Router-Files/KL7/KL744/DeWalt Spindle Mount.dxf

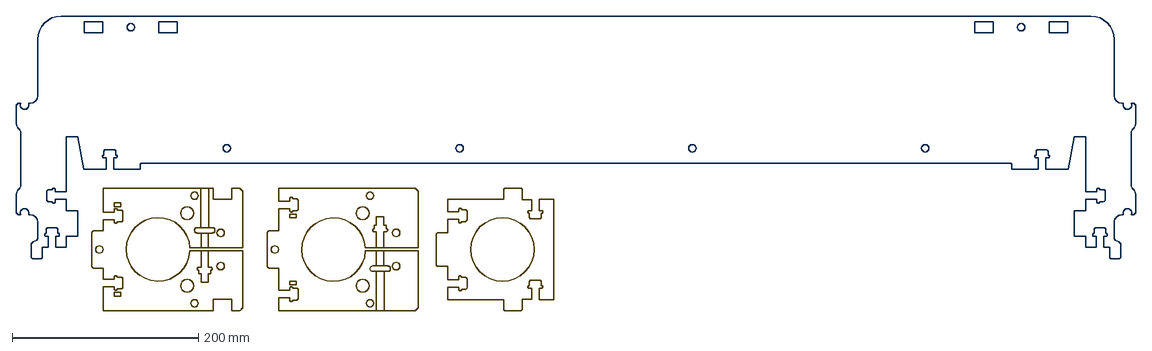
[picture p68: CAD file, 2025-02-15]
KL7/KL744/DeWalt Spindle Mount.dxf
1202.4 x 316.7 mm
