rlwoodjr/Router-Files/KL7/KL744/M Spindle Mount.dxf

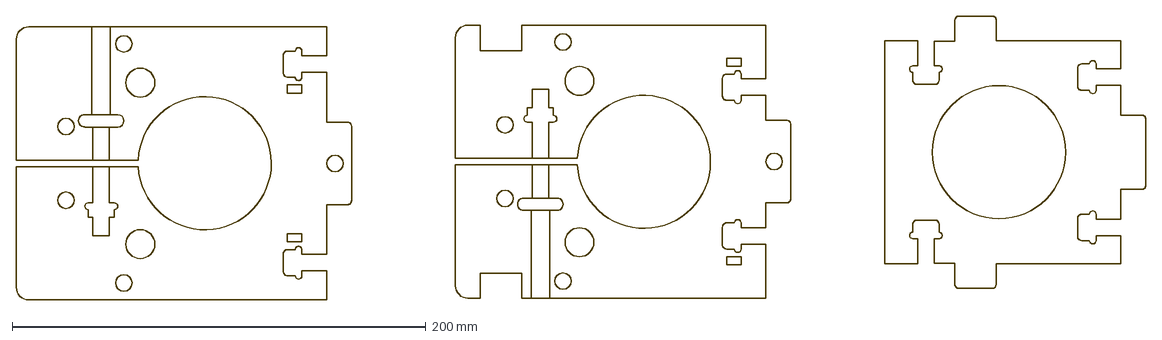
[picture p69: CAD file, 2025-02-15]
KL7/KL744/M Spindle Mount.dxf
546.2 x 137.2 mm
