rlwoodjr/Router-Files/(list of files, cad)

Other CAD files:
Evolution/Evolution 4 to 5/Extension Layout.dxf
KL7/80mm KL7/Spindlemount 80mm.dxf
KL7/Control box/PIBoxLayout.dxf
KL7/KL744/kl744 EXT KIT table.dxf
