rlwoodjr/Router-Files/KL7/Manuals/KL7 Series Table Assembly 1.4.pdf

# KL s e ri e s

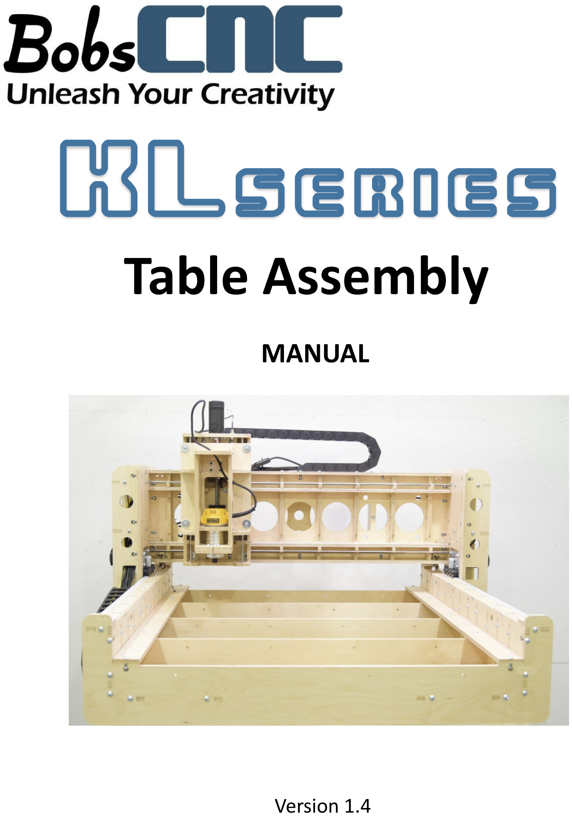
[picture p70: page 1]

# Table Assembly

### Version 1.4

# MANUAL

Table of Contents
Shop Safety: Precautions and Warnings····················································· 3
Frame Assembly | 6-10

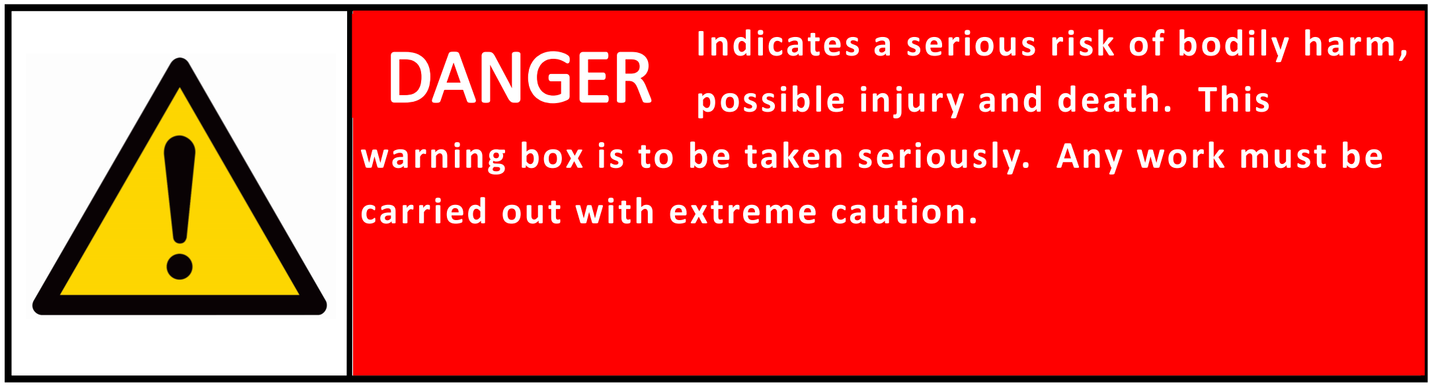
[picture p71: figure]
possible injury and death. This; carried out with extreme caution.
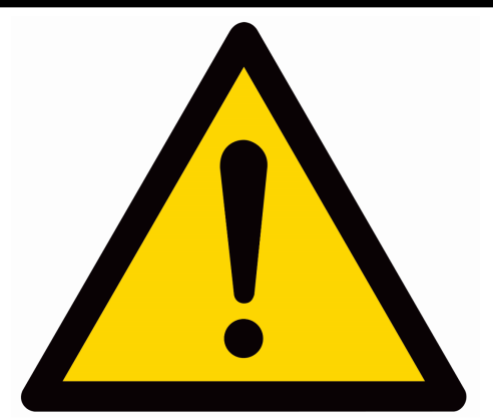
[picture p72: figure]

Indicates the possible damage to the machine, its components, or the work piece that can result from the failure to follow this warning.

# WARNING

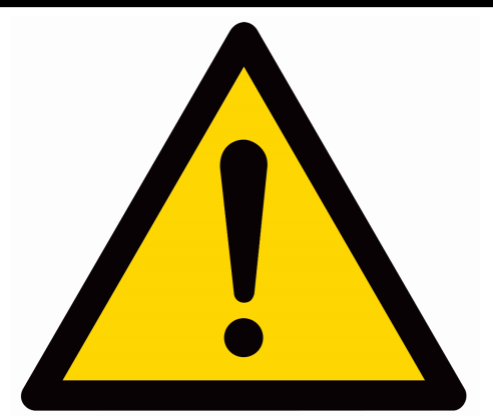
[picture p73: figure]

Indicates a possible risk of injury that can result from failure to follow this warning.

# CAUTION

Indicates a serious risk of bodily harm,

warning box is to be taken seriously. Any work must be

## Please review each assembly manual before beginning to

assemble the KL7 series CNC Router.

Look Safety Information and Hints.

Hints will provide needed information, shortcuts, and insights that will make assembly and machine operation easier and safer.

Hint

# Table Wood Components

Part # | Description | Qty | Photo

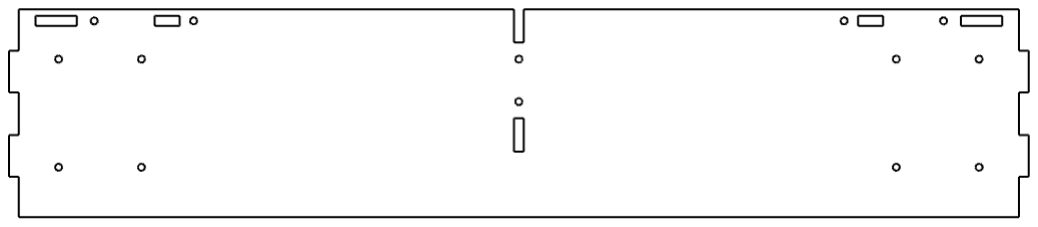
[picture p74: figure]

T1 | Side Panel | 2

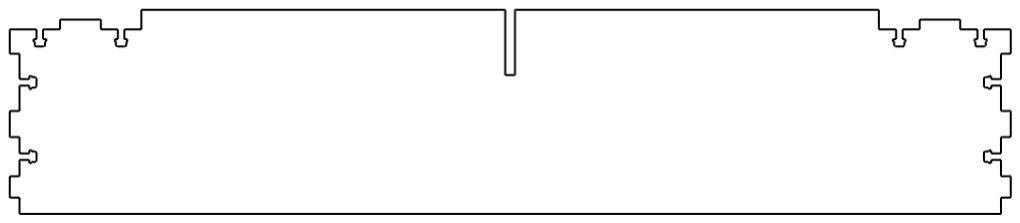
[picture p75: figure]

T2 | Lower Cross Support | 1
T3 | Upper Cross Support | 1

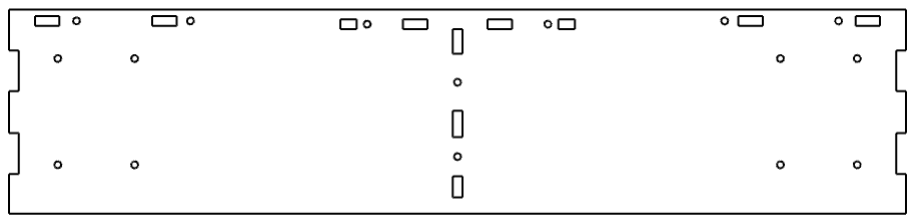
[picture p76: figure]

T4 | End Panel | 2

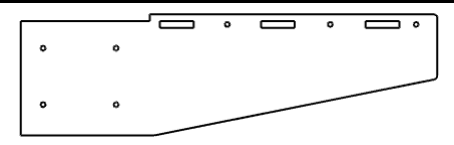
[picture p77: figure]

T5 | Side Leg Panel | 4

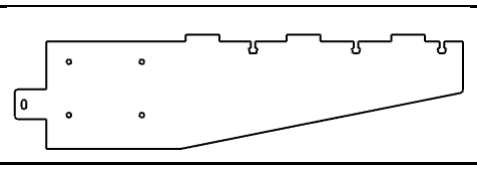
[picture p78: figure]

T6 | End Leg Panel | 4
T7 | Mid Brace | 2
T8 | Corner Brace | 4
H3 | 5/16 x 1 1/4 Machine Screws | 80
H5 | 5/16 Nut | 48
H6 | 5/16 Lock Nut | 32

# Step 1

# Leg Assembly

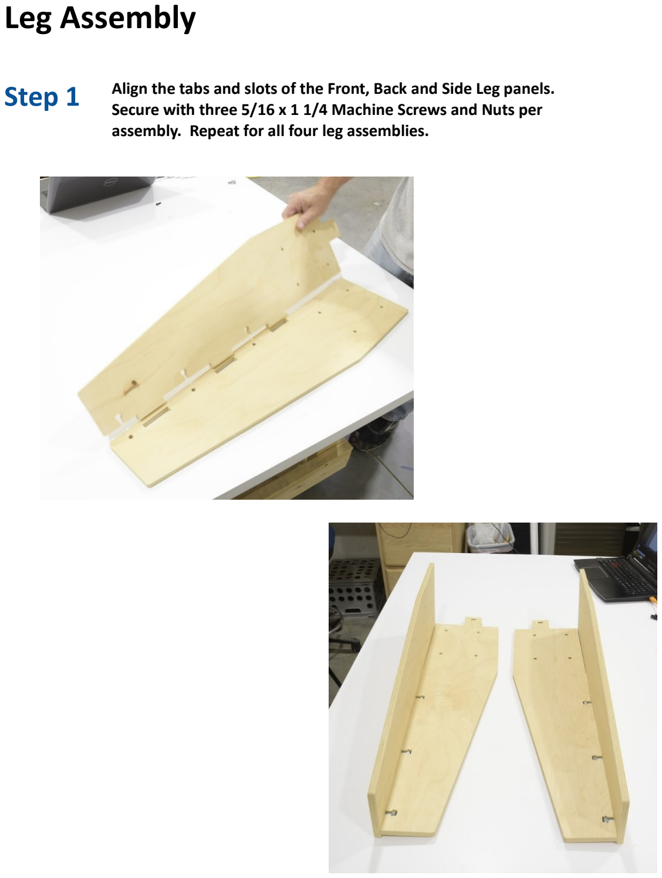
[picture p79: page 5]

Align the tabs and slots of the Front, Back and Side Leg panels. Secure with three 5/16 x 1 1/4 Machine Screws and Nuts per assembly. Repeat for all four leg assemblies.

# Frame Assembly

Step 1 Align the slots in the Upper and Lower Cross Supports as shown.

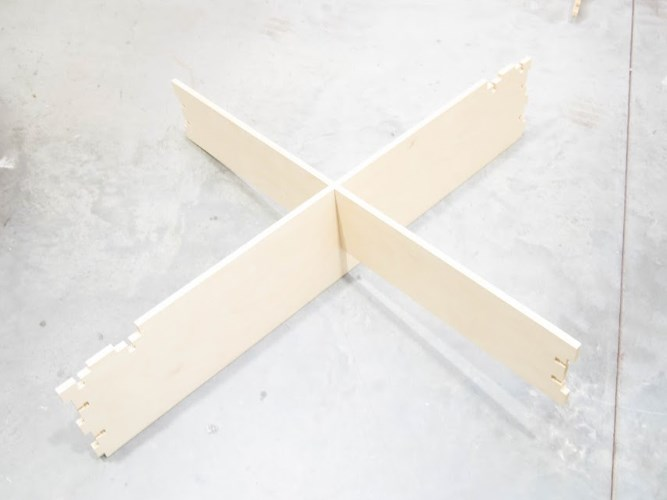
[picture p80: figure]
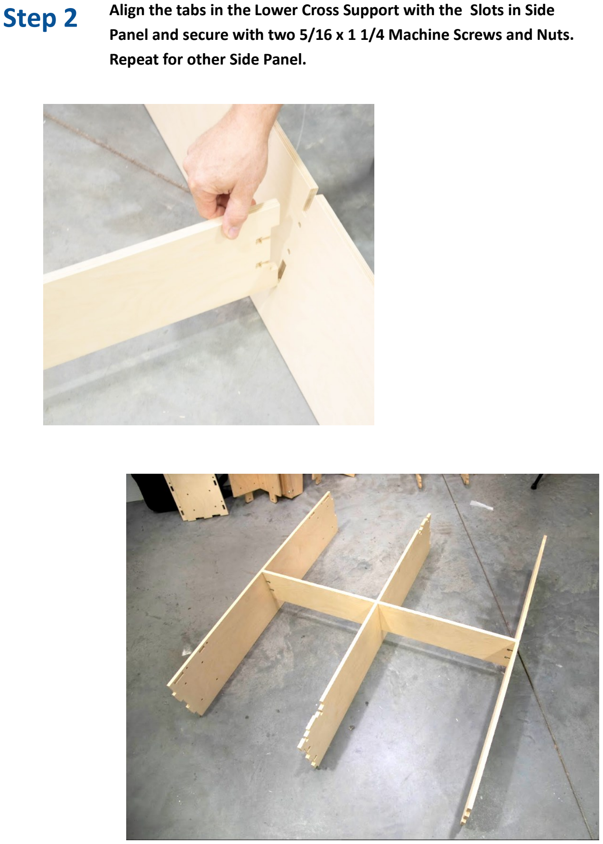
[picture p81: page 7]

Step 2 Align the tabs in the Lower Cross Support with the Slots in Side Panel and secure with two 5/16 x 1 1/4 Machine Screws and Nuts. Repeat for other Side Panel.

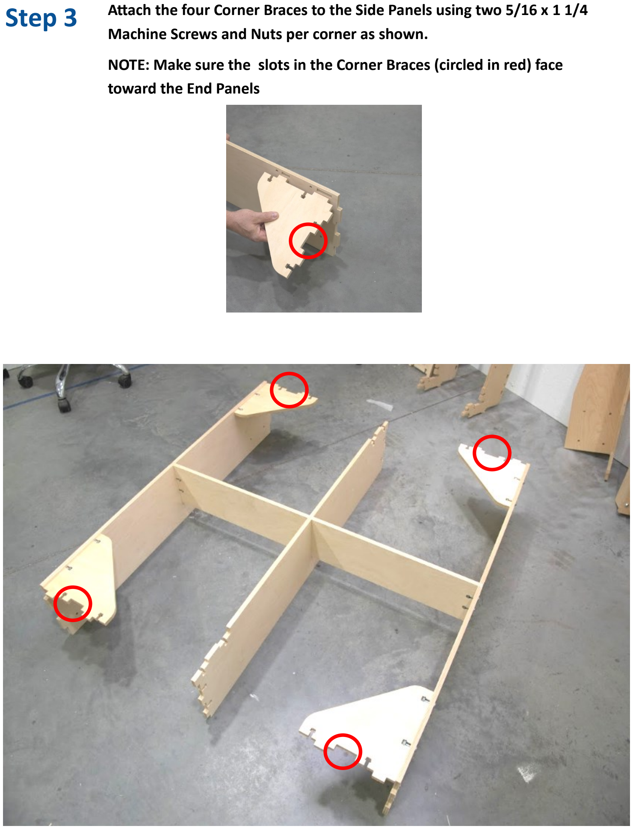
[picture p82: page 8]

Step 3 Attach the four Corner Braces to the Side Panels using two 5/16 x 1 1/4 Machine Screws and Nuts per corner as shown.

NOTE: Make sure the slots in the Corner Braces (circled in red) face toward the End Panels

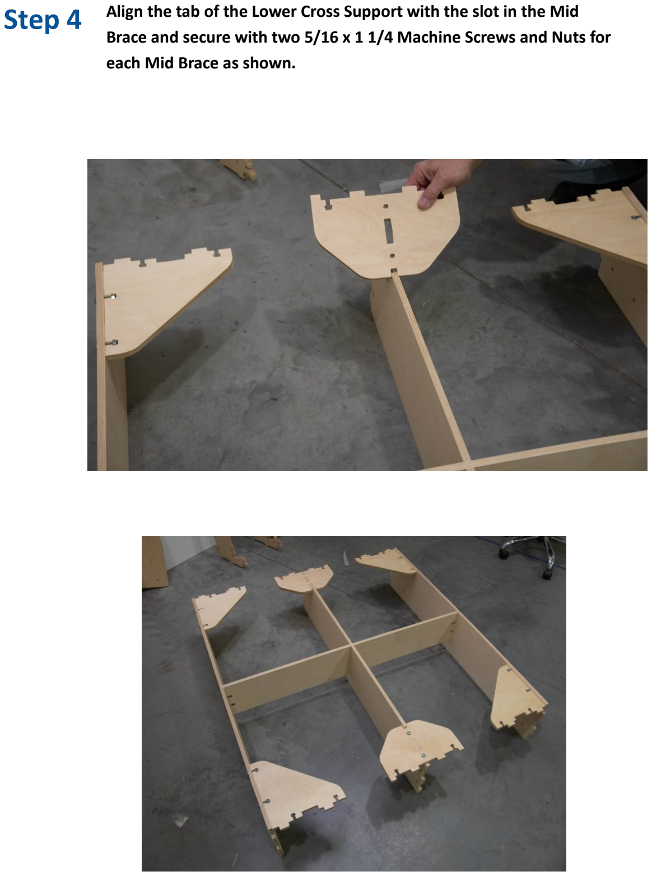
[picture p83: page 9]

Step 4 Align the tab of the Lower Cross Support with the slot in the Mid Brace and secure with two 5/16 x 1 1/4 Machine Screws and Nuts for each Mid Brace as shown.

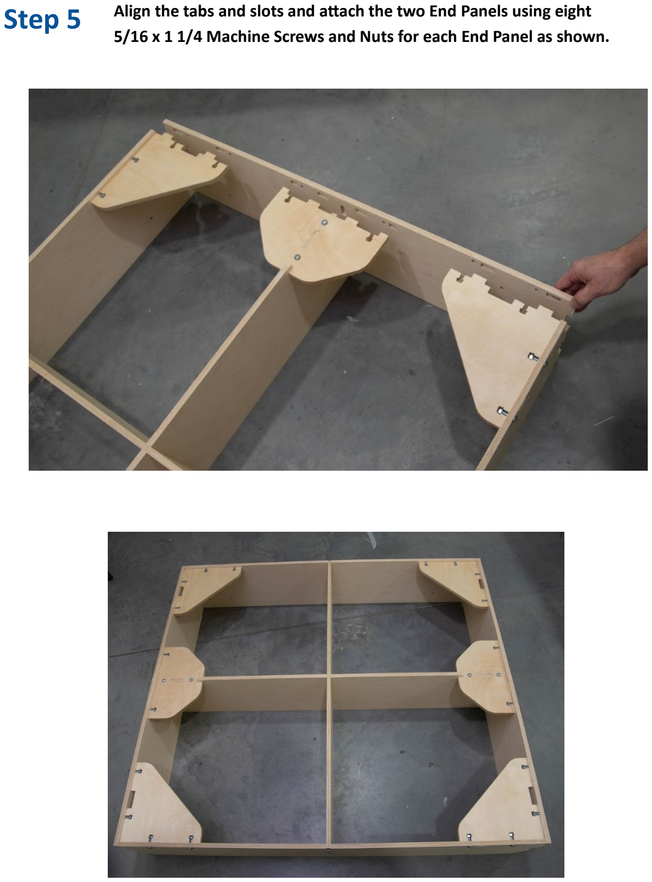
[picture p84: page 10]

Step 5 Align the tabs and slots and attach the two End Panels using eight 5/16 x 1 1/4 Machine Screws and Nuts for each End Panel as shown.

# Attaching the Legs

Step 1 NOTE: The Mounting Tab on the End Leg Panel fits through the slot in the Corner Brace as shown.

Slide the Mounting tab though the slot in the Corner Brace and attach the Leg Assembly to the End and Side Panel with eight 5/16 x 1 1/4 Machine Screws and Lock Nuts for each leg assembly.

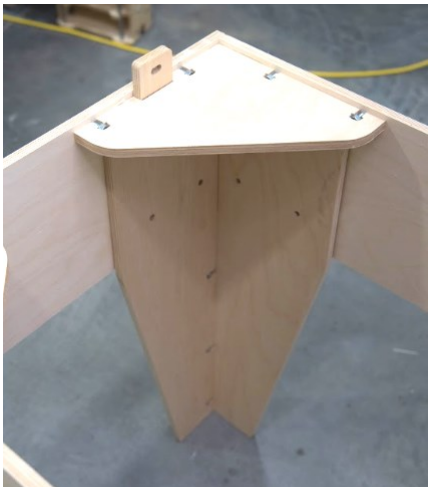
[picture p85: figure]

NOTE: The Mounting Tab on the End Leg Panels will fasten to the front and rear End Panels of the KL7 Series Router with four 5/16 x 1 1/4 Machine Screws and Nuts .

## Finished KL series Table

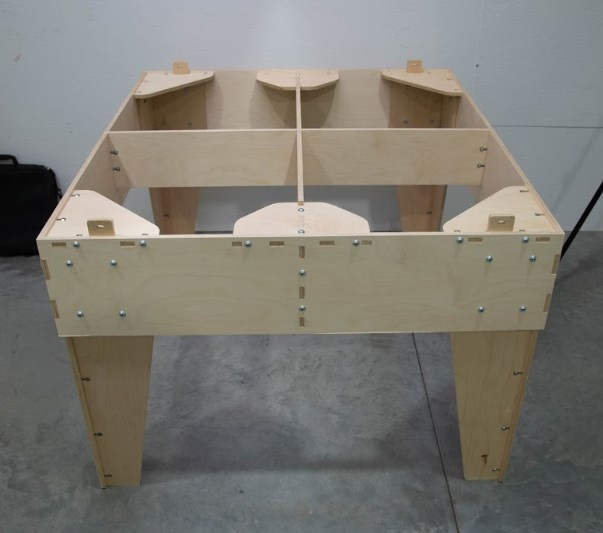
[picture p86: figure]
