rlwoodjr/Router-Files/KL7/Manuals/Manual 2 YZ 744 2.3.pdf

KL744

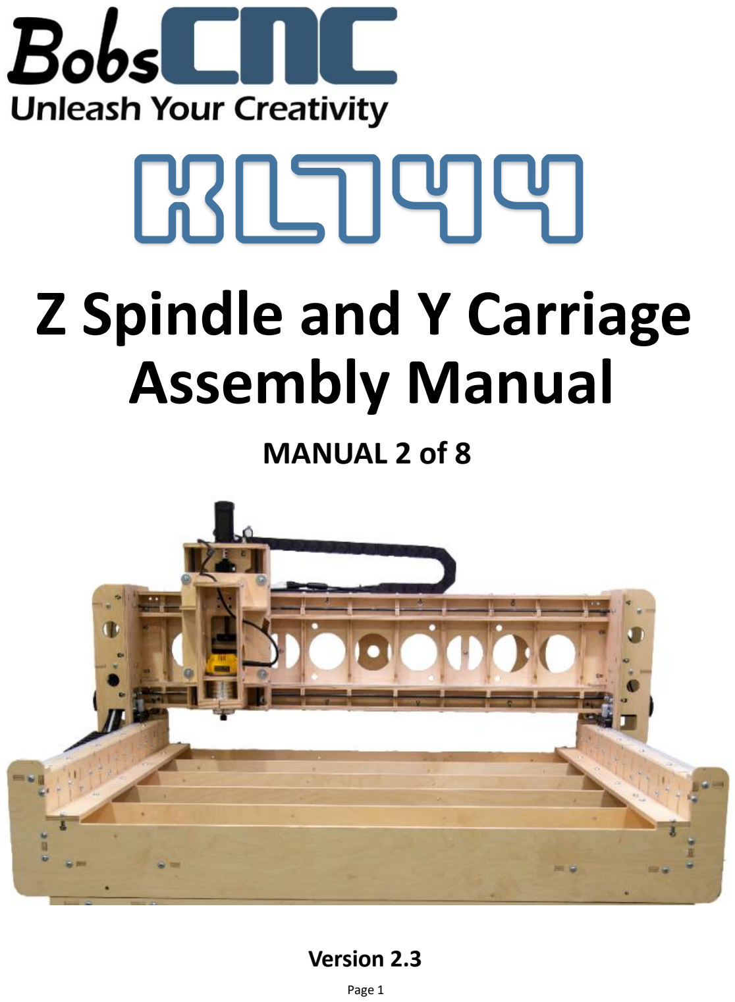
[picture p140: page 1]

# Z Spindle and Y Carriage Assembly Manual

### Version 2.3

# MANUAL 2 of 8

Table of Contents
Shop Safety: Precautions and Warnings························································3 Z Spindle Wood & Hardware Parts Guide ······················································4-5
Getting Started: Good Ideas | 6

Z Spindle Mount Assembly Instructions
Illustrated Steps··········································································7-13 Installing the Bearings
Illustrated Steps | 14-16
Y Carriage Assembly Wood & Hardware Parts Guide | 17-19

Y Carriage Assembly Instructions
Illustrated Steps | 20-25
Installing the Bearings
Illustrated Steps | 26-27
Y Carriage Assembly Instructions (cont’d) | 28-35
Ball Screw Assembly and Installation
Illustrated Steps | 36-39

possible injury and death. This; carried out with extreme caution.

Indicates the possible damage to the machine, it’s components, or the work piece that can result from the failure to follow this warning.

# WARNING

Indicates a serious risk of bodily harm,

warning box is to be taken seriously. Any work must be


## Please review each assembly manual before beginning to

assemble the KL7 series CNC Router.

Look Safety Information and Hints.

Hints will provide needed information, shortcuts, and insights that will make assembly and machine operation easier and safer.

Hint

Indicates a possible risk of injury that can result from failure to follow this instruction.

# CAUTION

## Z Spindle Mount Assembly Instructions

Z Spindle Mount Wood Components

Part # | Description | Qty | Photo


Z1 | Frame Back Plate | 1


Z2 | Frame Side Support | 2
Z3 | Ball Screw Spacer | 1
Z4 | Spindle Top Mount | 1
Z5 | Frame Top Support | 1
Z6 | Bottom Spindle Mount Upper | 1
Z7 | Bottom Spindle Mount Lower | 1
Z8 | Frame Support | 4

## Z Spindle Mount Assembly Instructions

Z Spindle Mount Hardware Components

Part # | Description | Qty | Photo
H24 | SG25U bearings | 4
H8 | 5/16 Fender Washers | 8
H3 | 5/16 x 1 1/4 Machine Screw | 70
H2 | 5/16 x 1 3/4 Machine Screw | 4
H1 | 5/16 x 1 3/4 Hex Head Bolt | 8
H23 | 8-32 Set Screw | 6
H5 | 5/16 Nuts | 68
H6 | 5/16 Lock Nuts | 14

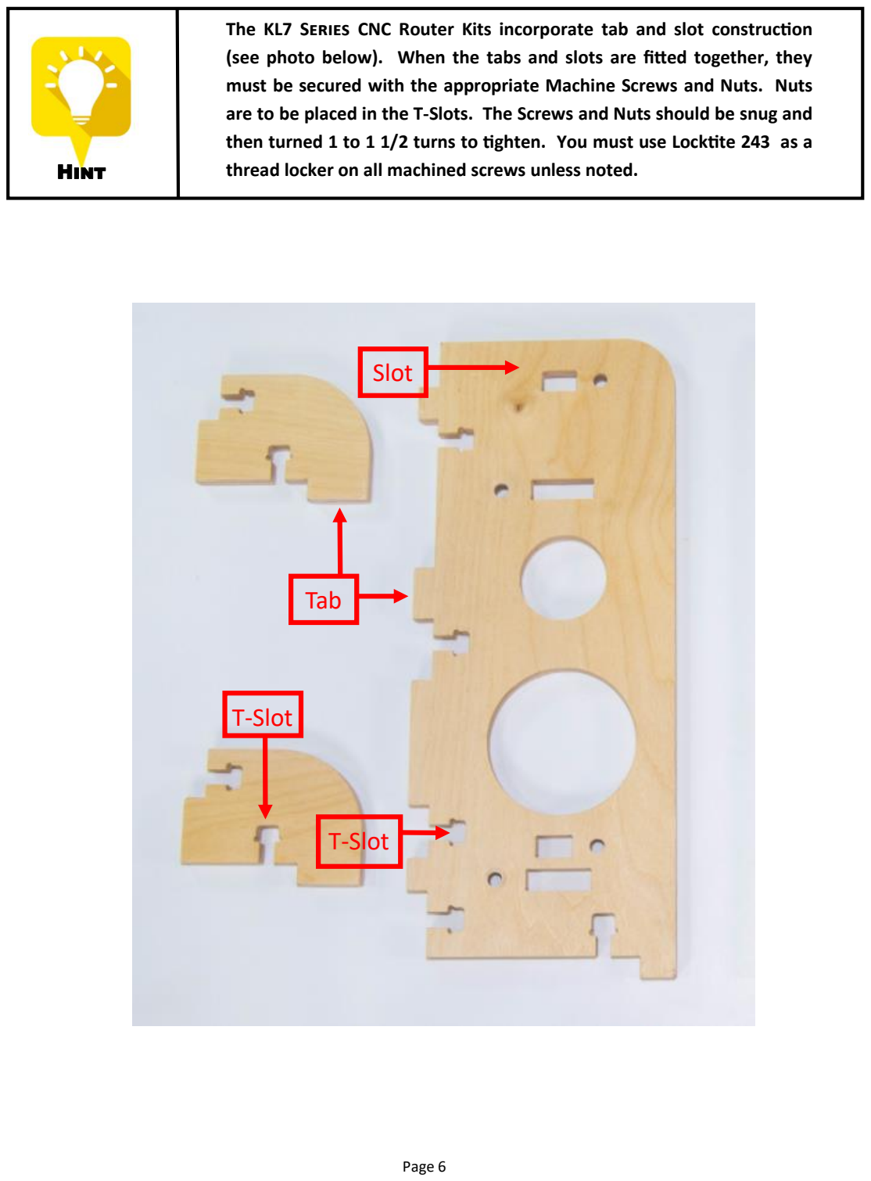
[picture p141: page 6]

The KL7 Series CNC Router Kits incorporate tab and slot construction (see photo below). When the tabs and slots are fitted together, they must be secured with the appropriate Machine Screws and Nuts. Nuts are to be placed in the T-Slots. The Screws and Nuts should be snug and then turned 1 to 1 1/2 turns to tighten. You must use Locktite 243 as a
Hint | thread locker on all machined screws unless noted.

T-Slot

Slot

Tab

T-Slot

# Z Spindle Mount Assembly

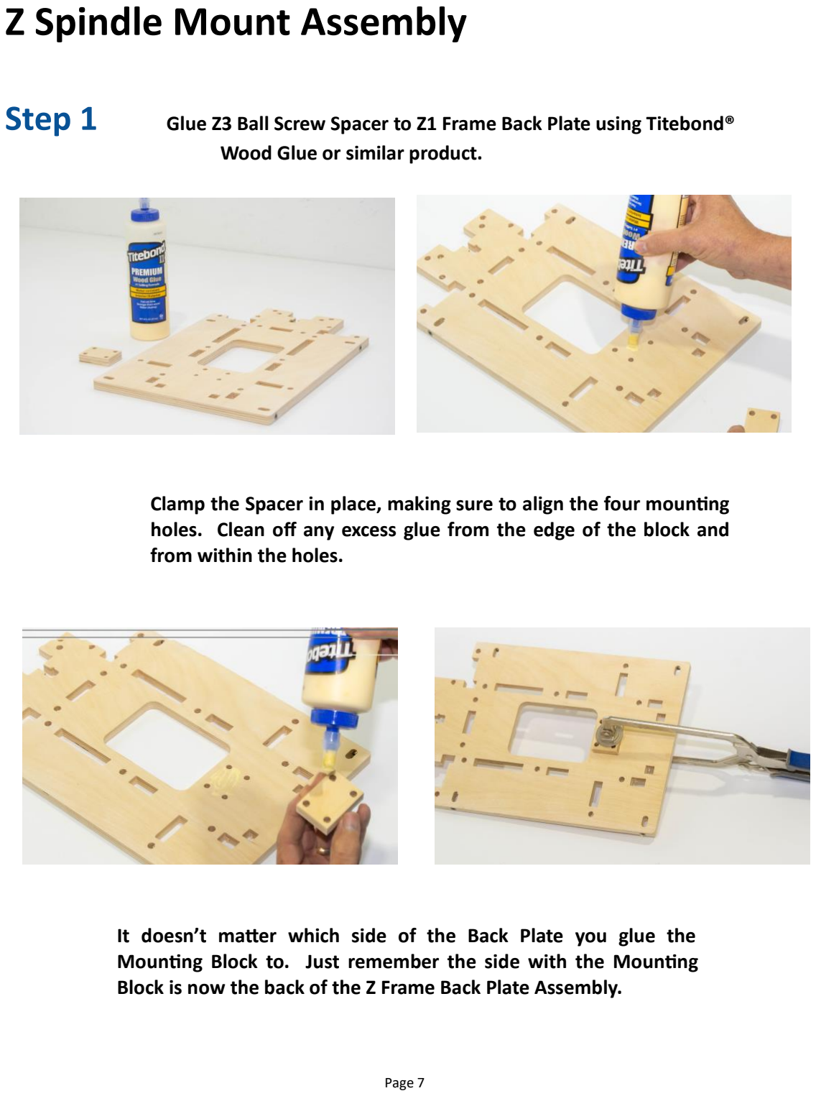
[picture p142: page 7]

Step 1 Glue Z3 Ball Screw Spacer to Z1 Frame Back Plate using Titebond®

Wood Glue or similar product.

It doesn’t matter which side of the Back Plate you glue the Mounting Block to. Just remember the side with the Mounting Block is now the back of the Z Frame Back Plate Assembly.

Clamp the Spacer in place, making sure to align the four mounting holes. Clean off any excess glue from the edge of the block and from within the holes.

Step 2 Insert the tabs of the Z8 Frame Supports into the slots in the Z2 Frame

Side Supports and secure with four 5/16 x 1 1/4 Machine Screws and Nuts.


NOTE: The parts are mirrored.

The KL7 Series CNC assembly process requires Locktite 232 as a thread locker on all Machine Screws unless noted.

We recommend threading the Machine Screw in one thread, then applying the Locktite, then tightening the screws. The Screws and Nuts should be snug and then turned 1 to 1 1/2 turns to tighten.

Hint


Step 3 Attach the Z5 Frame Top Support and Z4 Spindle Top Mount to the Frame

Side Support Assemblies and secure with four 5/16 x 1 1/4 Machine Screws and Nuts.

Step 4 Sandwich a 5/16 x 1 3/4 Machine Screw and Nut between the Z7 Bottom

Spindle Clamp and the Z6 Top Spindle Clamp top as shown.


When inserting the Machine Screw and Nut, make sure the Phillips Screw Head is visible and accessible to loosen and tighten the Spindle Mount around the body of the Router.

Hint

Secure the Top and Bottom Clamps together with two 5/16 x 1 1/4 Machine Screws and Lock Nuts as shown below.

Phillips Screw Head on this side

Lock nuts

# Step 5


Step 6 Attach the Assembly to the to the Frame Back Plate Assembly and

secure with fourteen 5/16 x 1 1/4 Machine Screws and Nuts.

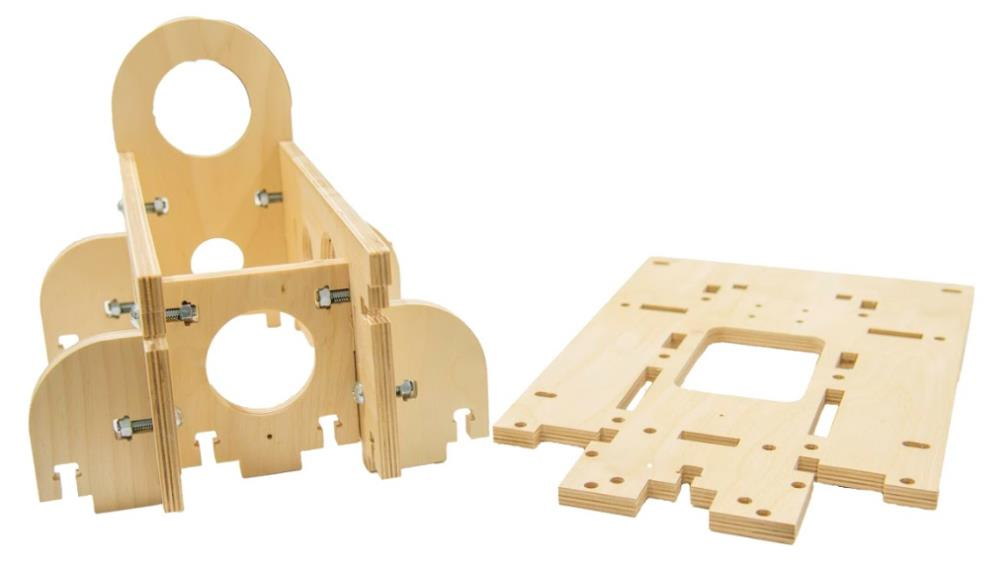
[picture p143: figure]

NOTE: The Ball Screw Mounting Block is on the reverse side of the Back Plate above.

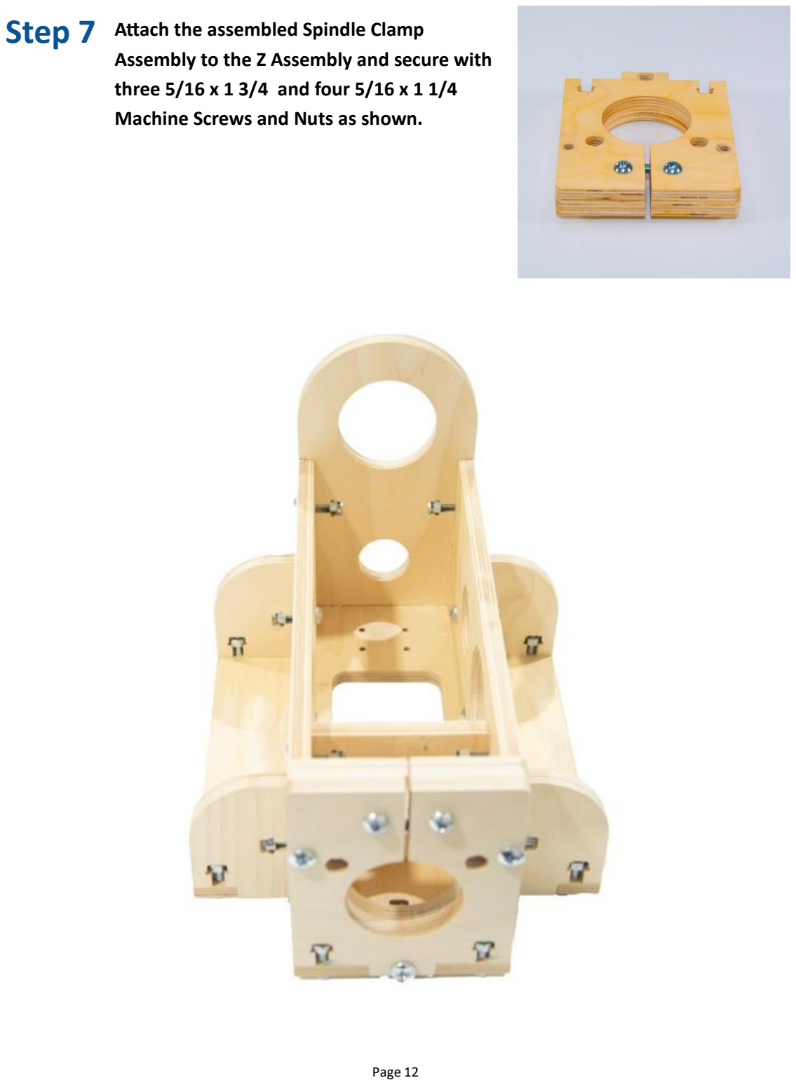
[picture p144: page 12]

Step 7 Attach the assembled Spindle Clamp Assembly to the Z Assembly and secure with three 5/16 x 1 3/4 and four 5/16 x 1 1/4 Machine Screws and Nuts as shown.

Step 8 Insert four 8-32 set screws into the four factory installed inserts with a 5/64 Allen Wrench on the edge of the plywood in line with the slotted holes as shown.


# Step 1


Hub


Make sure the hub of the bearing faces the washer. IMPORTANT: the hex head must be oriented so that the nut is visible when looking at the back of the carriage (see photo below).

# CAUTION:

## Bearing sequence:

Hex-head / Bearing/ Fender Washer / Plywood / Fender Washer / Locknut.

Hint

Install four SG25U Bearings with four 5/16 x 1 3/4 Hex Head Bolts, eight Fender Washers, and four 5/16 Lock Nuts to the Y Carriage Frame Assembly.

# Installing the Bearings


Step 2 Install bearings as shown below.

All 4 of the Bearings are mounted in the elongated holes and need to be snug but able to slide in the slots. These will be tightened in a later step and are also used to Tram the Spindle.

Hint


Front view

Back view

## Y Carriage Assembly Instructions

Y Carriage Wood Components

Part # | Description | Qty | Photo


Y1 | Carriage Top Mount | 1
Y2 | Belt Drive Mount | 1
Y3 | Carriage Side | 2
Y4 | Upper Rail Support | 2
Y5 | Carriage Bottom | 1
Y6 | Y Carriage Mid Rail Support | 1
Y7 | Lower Ball Screw Mount | 1
Y8 | Upper Ball Screw Mount | 1

Y Carriage Wood Components

Part # | Description | Qty | Photo


Y9 | Frame Back Plate | 1
Y10 | Rail Support | 1
Part # | Description | Qty | Photo
H24 | SG25U Bearing | 4
H8 | 5/16 Fender Washer | 12
H1 | 5/16 X 1 3/4 Hex Head Bolt | 4
H3 | 5/16 x 1 1/4 Machine Screws | 41
H23 | 8-32 Set Screws | 2
H6 | 5/16 Lock Nuts | 8
H5 | 5/16 Nuts | 37
H22 | 10-24 Insert | 12
RZ | 3/8” X 19” Z Rail | 2

Y Carriage Hardware

Ball Screw Hardware

Part # | Description | Qt y | Photo
B1 | Upper Ball Screw Locking Nut | 1
B2 | Upper Ball Screw Mount | 1


B3 | Ball Screw with Nut | 1
B4 | Ball Screw Nut Housing | 1
B5 | Lower Ball Screw Mount | 1
H13 | M4 x 16 Socket Head Machine Screws | 6
B6 | Retainer Clip | 1
H11 | 10 – 24 x 1 ½ Socket Head Screws | 6
B7 | Z Spider Coupler | 1

Step 1 NOTE: The back side of the Y9 Frame Back Plate has pocket holes and is an important reference for orientation.

Pocket Holes
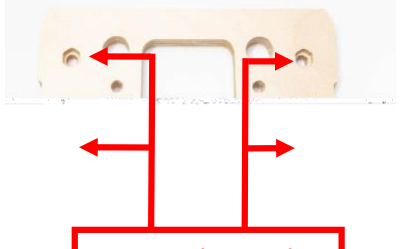
[picture p145: figure]

Set four 5/16” lock nuts in the hex pocket holes as
shown. If needed, use a
mallet to tap them in place.

Orient the Y2 Belt Drive
Mount with the hex pocket
holes facing up as shown.

# Y Carriage Assembly

Hex Pocket Holes


# Step 2

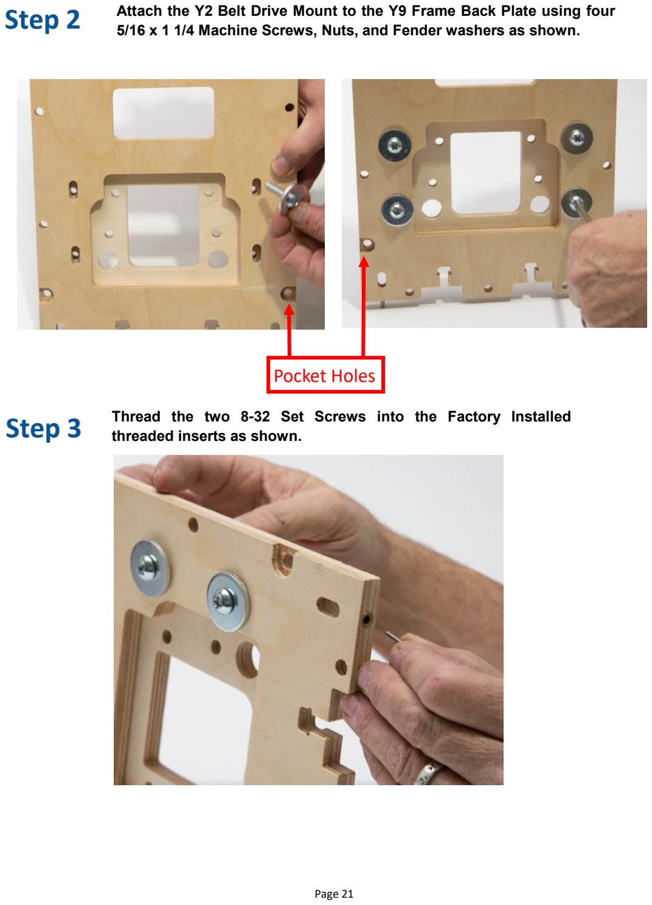
[picture p146: page 21]

Attach the Y2 Belt Drive Mount to the Y9 Frame Back Plate using four 5/16 x 1 1/4 Machine Screws, Nuts, and Fender washers as shown.

Thread the two 8-32 Set Screws into the Factory Installed threaded inserts as shown.

Pocket Holes

# Step 3

# Step 4

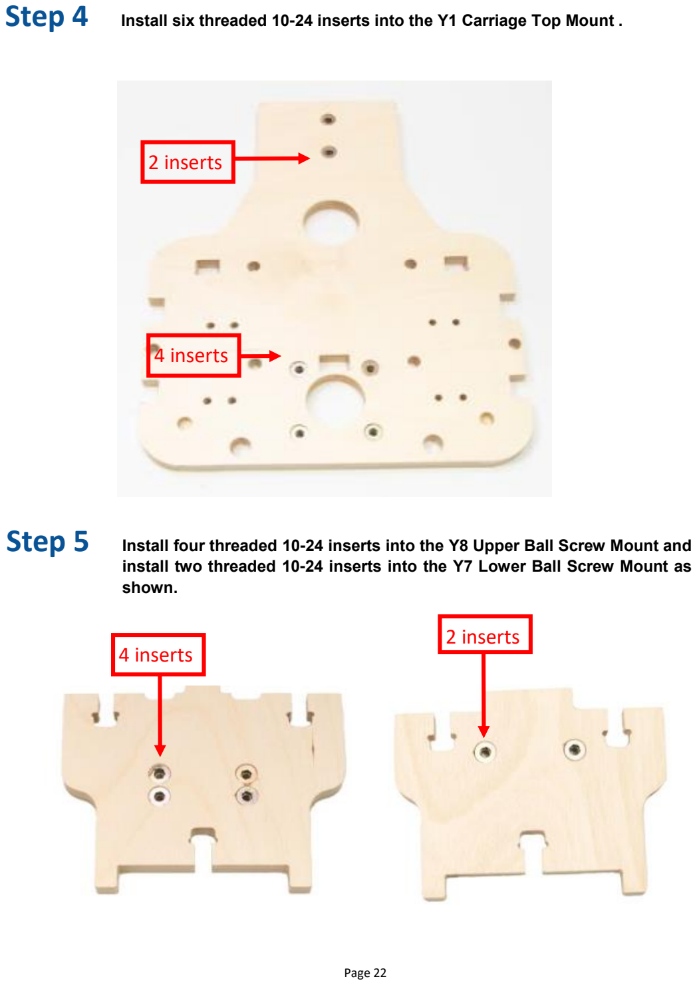
[picture p147: page 22]

Install six threaded 10-24 inserts into the Y1 Carriage Top Mount .

2 inserts

4 inserts

Install four threaded 10-24 inserts into the Y8 Upper Ball Screw Mount and install two threaded 10-24 inserts into the Y7 Lower Ball Screw Mount as shown.

# Step 5

4 inserts

2 inserts

Attach the Y7 Lower Ball Screw Mount to the Y4 Upper Rail Support. Ensure the Inserts are facing as shown. Secure with one 5/16 x 1 1/4 Machine Screw and Nut.

Inserts on this side

Attach the Y6 Mid Rail Carriage Support to the Upper Support Assembly and secure with two 5/16 x 1 1/4 Machine Screw and Nuts.

# Step 6

# Step 7

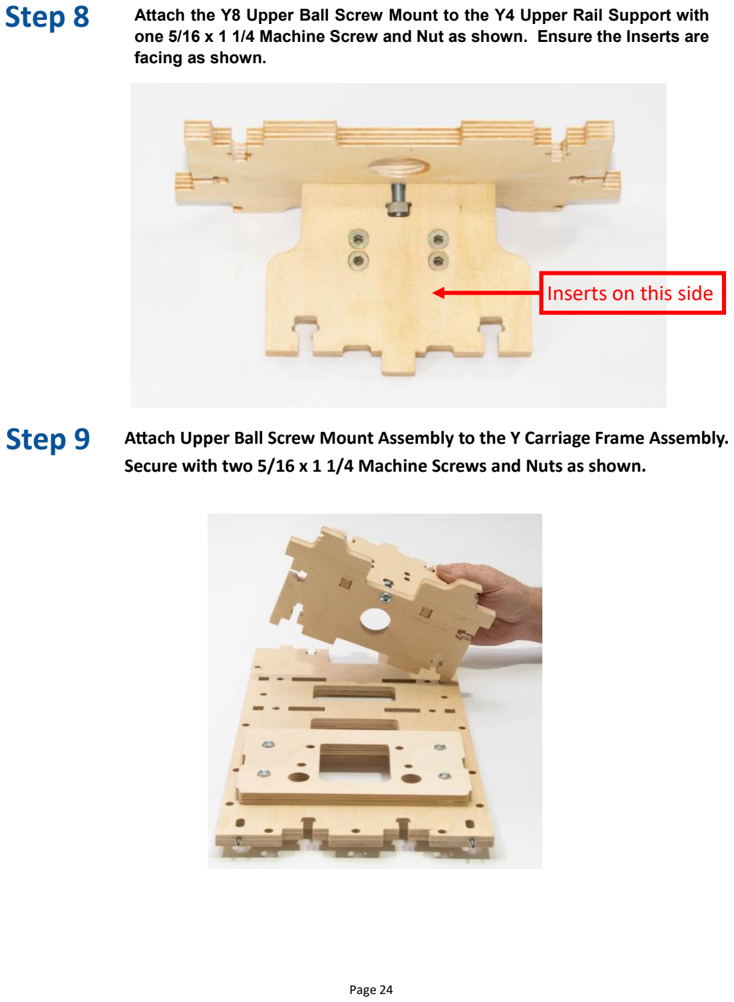
[picture p148: page 24]

Step 8 Attach the Y8 Upper Ball Screw Mount to the Y4 Upper Rail Support with

one 5/16 x 1 1/4 Machine Screw and Nut as shown. Ensure the Inserts are facing as shown.

Step 9 Attach Upper Ball Screw Mount Assembly to the Y Carriage Frame Assembly. Secure with two 5/16 x 1 1/4 Machine Screws and Nuts as shown.

Inserts on this side

Step 10 Attach the Lower Ball Screw Mount Assembly to the Y Carriage Frame Assembly. Secure with two 5/16 x 1 1/4 Machine Screws and Nuts as shown.


# Step 1

Make sure the hub of the bearing faces the washer. IMPORTANT: the hex head must be oriented so that the nut is visible when looking at the back of the carriage (see photo below).

# CAUTION:

## Bearing sequence:

Hex-head / Bearing/ Fender Washer / Plywood / Fender Washer / Locknut.

Hint

Install four SG25U Bearings with four 5/16 x 1 3/4 Hex Head Bolts, eight Fender Washers, and four 5/16 Lock Nuts to the Y Carriage Frame Assembly.

# Installing the Bearings

Hub

Tighten the Nuts for the two Bearings mounted in the round holes.

The Bearings mounted in the elongated holes need to be snug but able to slide in the slots. These Bearings will be tightened in a later step when mounting the Assembly.
Hint


Step 1 Position one of the Y3 Carriage Sides to Back Frame Assembly. Secure with seven 5/16 x 1 1/4 Machine Screws & Nuts.

# Y Carriage Assembly—continued


Step 2 Install the Y10 Rail Support as show. The hex pocket cut on the centerline of Y10 should be facing up (not visible in the picture).

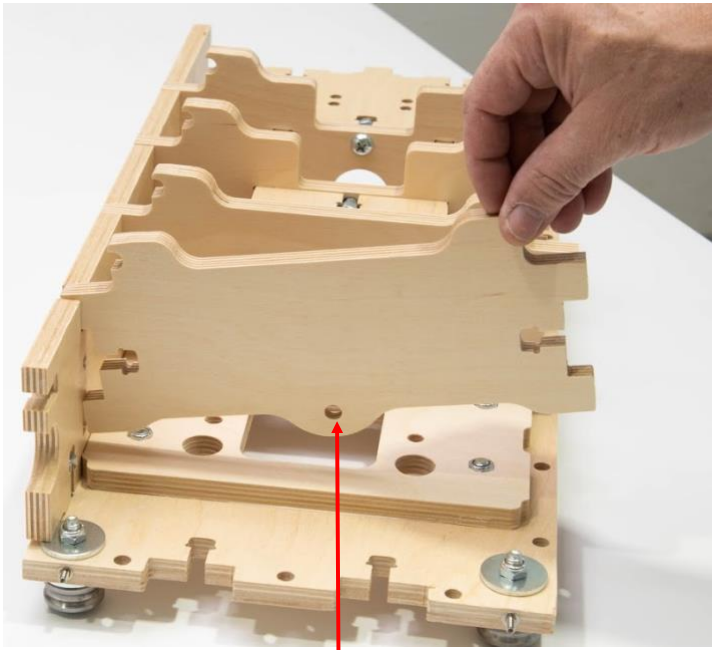
[picture p149: figure]

Hex pocket facing other side

Step 3 Position the second Y3 Carriage Side to the Y Carriage Frame Assembly. Secure with nine 5/16 x 1 1/4 Machine Screws and Nuts.

Slide the notches of the Carriage Sides around the tabs of the Rail supports. Carefully squeeze the Side Support flush against the Back Frame, and secure with Machine Screws and Nuts.

Hint


Bottom view

Left Side | Right Side

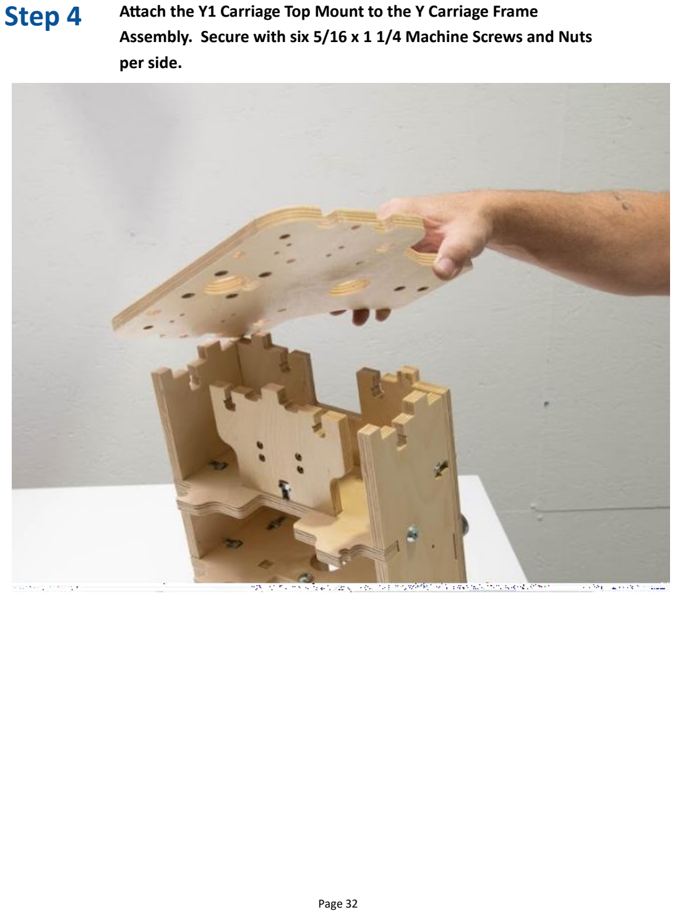
[picture p150: page 32]

Step 4 Attach the Y1 Carriage Top Mount to the Y Carriage Frame Assembly. Secure with six 5/16 x 1 1/4 Machine Screws and Nuts per side.


Step 5 Carefully insert each of the two 3/8 inch Z Rails into the Rail Supports.

Step 6 Install Y5 Carriage Bottom, making sure the rails fit securely, in the rail pockets

and fasten with seven 5/16 x 1 1/4 Machine Screws and Nuts.


Front View

Back View

Step 1 Insert the Ball Nut Housing onto the Ball Nut as shown.


Step 2 Secure the Ball Screw Housing onto the Ball Nut with six M4 x 16 Socket Head Machine Screws.

# Ball Screw Assembly and Installation


# Step 3

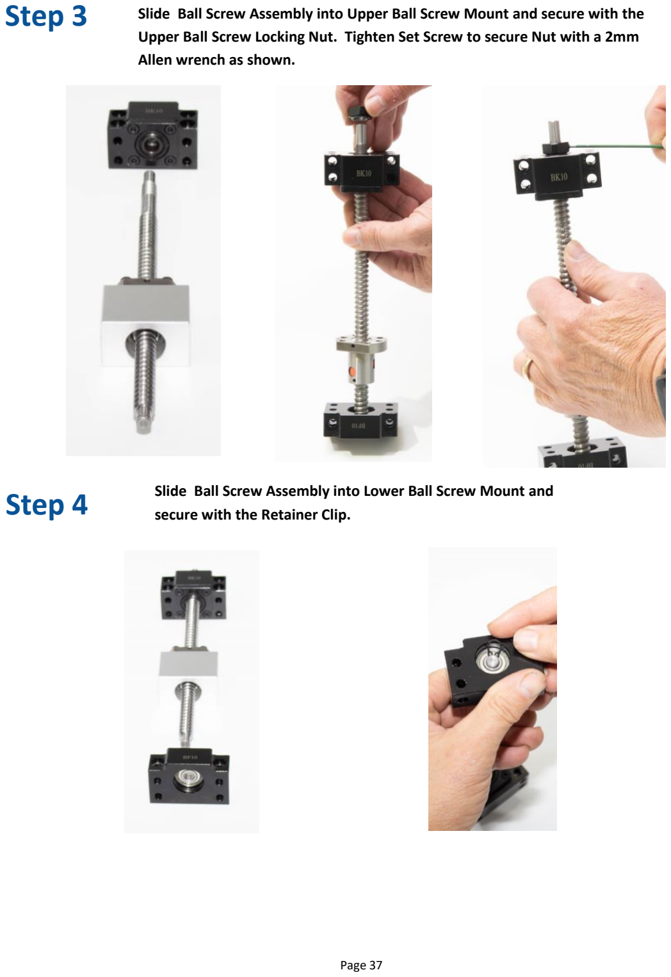
[picture p151: page 37]

# Step 4

Slide Ball Screw Assembly into Upper Ball Screw Mount and secure with the Upper Ball Screw Locking Nut. Tighten Set Screw to secure Nut with a 2mm Allen wrench as shown.

Slide Ball Screw Assembly into Lower Ball Screw Mount and secure with the Retainer Clip.

Step 5 Slide the Z Spider Coupler onto the Upper Ball Screw and secure

by tightening the Coupler Set Screw.

## Step 6


Be sure that the mounting holes on the front of the Ball Screw Nut Assembly are visible before securing the assembly in place.

Set the Z Screw Assembly into the Y Carriage Assembly as shown in the photo below and secure in place with six 10-24 x 1 1/2 Socket Head Screws.

Y Carriage Assembly with Ball Screw Assembly
