rlwoodjr/Router-Files/KL7/Manuals/Manual 4 733 X Frame Assembly2.1.pdf

KL733

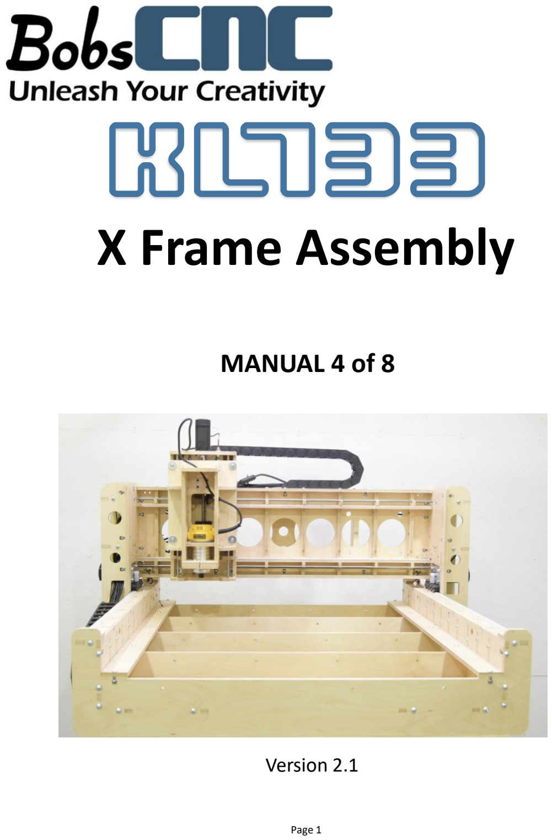
[picture p202: page 1]

# X Frame Assembly

# MANUAL 4 of 8

### Version 2.1

Table of Contents
Safety First | 3
X Frame Assembly Parts Guide | 4-5
X Frame Assembly Instructions······································································6-20

possible injury and death. This; carried out with extreme caution.

Indicates the possible damage to the machine, it’s components, or the work piece that can result from the failure to follow this warning.

# WARNING

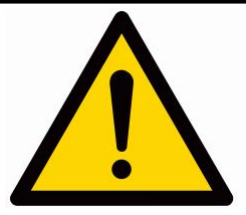
[picture p203: figure]

Indicates a possible risk of injury that can result from failure to follow this warning.

# CAUTION

Indicates a serious risk of bodily harm,

warning box is to be taken seriously. Any work must be

## Please review each assembly manual before beginning to

assemble the KL7 series CNC Router.

Look Safety Information and Hints.

Hints will provide needed information, shortcuts, and insights that will make assembly and machine operation easier and safer.

Hint

X Frame Wood Components

Part # | Description | Qty | Photo
X1 | Frame Side | 2
X2 | Mid Rail Supports | 3
X3 | Rail Support | 16
X4 | Drag Chain Mount | 1
X5 | End Panels | 2
X6 | Side Brace | 2
X7 | Belt Rest | 2
X8 | Corner Brace | 4

Part # | Description | Qty | Photo
H3 | 5/16 x 1 1/4 Machine Screw | 96
H5 | 5/16 Nut | 96
H22 | 10-24 Insert | 2
RX | 3/8” x 48” X Rail | 4

X Hardware Components

# Step 1

# X Frame Assembly

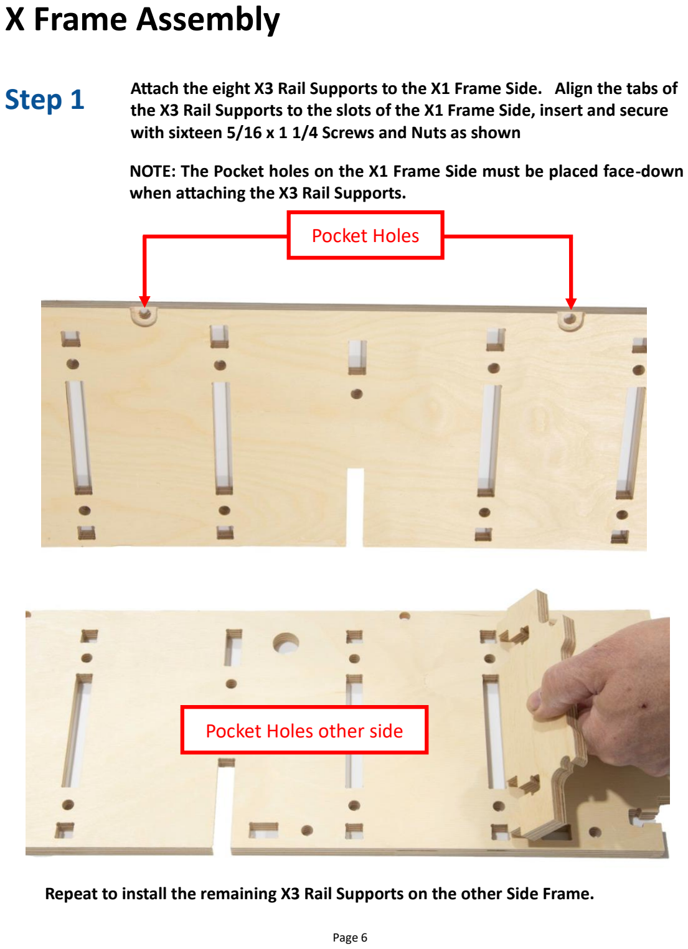
[picture p204: page 6]

NOTE: The Pocket holes on the X1 Frame Side must be placed face-down when attaching the X3 Rail Supports.

Attach the eight X3 Rail Supports to the X1 Frame Side. Align the tabs of the X3 Rail Supports to the slots of the X1 Frame Side, insert and secure with sixteen 5/16 x 1 1/4 Screws and Nuts as shown

Pocket Holes

Repeat to install the remaining X3 Rail Supports on the other Side Frame.

Pocket Holes other side

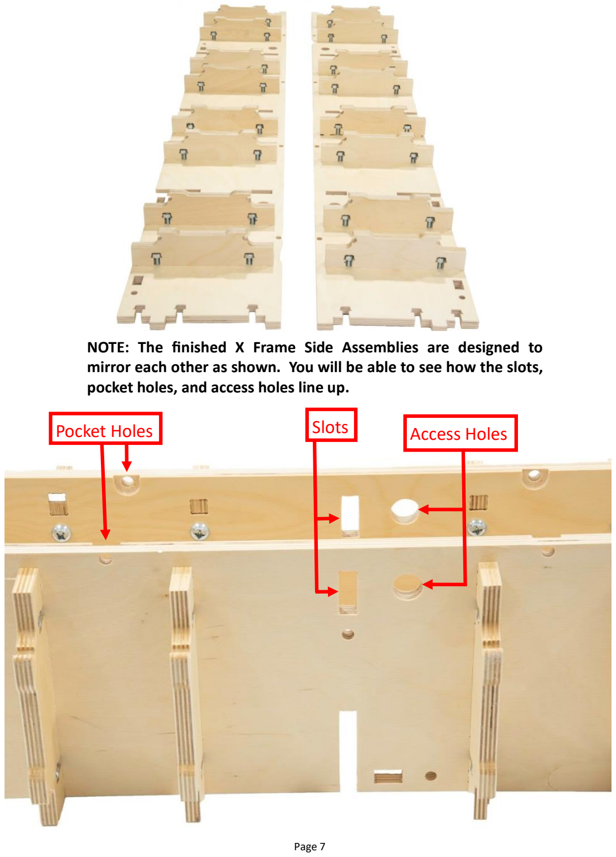
[picture p205: page 7]

NOTE: The finished X Frame Side Assemblies are designed to mirror each other as shown. You will be able to see how the slots, pocket holes, and access holes line up.

Pocket Holes | Slots | Access Holes

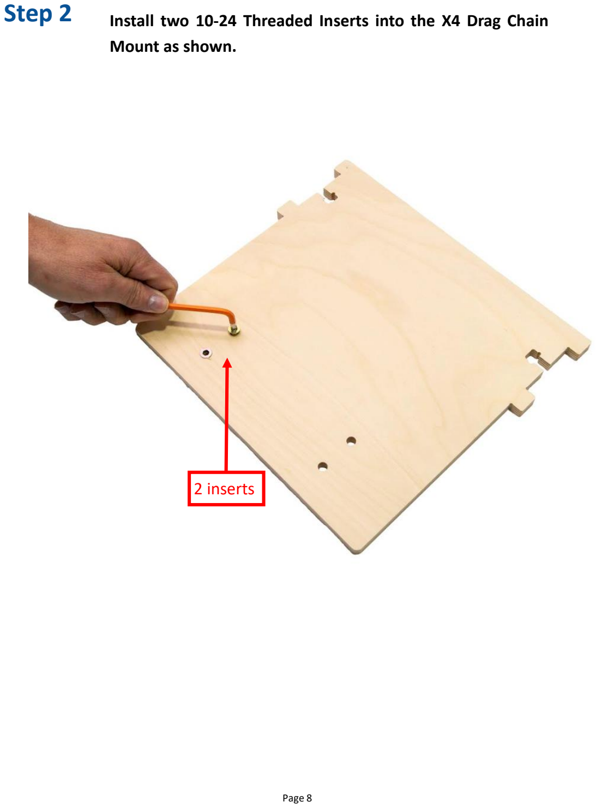
[picture p206: page 8]

Step 2 Install two 10-24 Threaded Inserts into the X4 Drag Chain

Mount as shown.

2 inserts

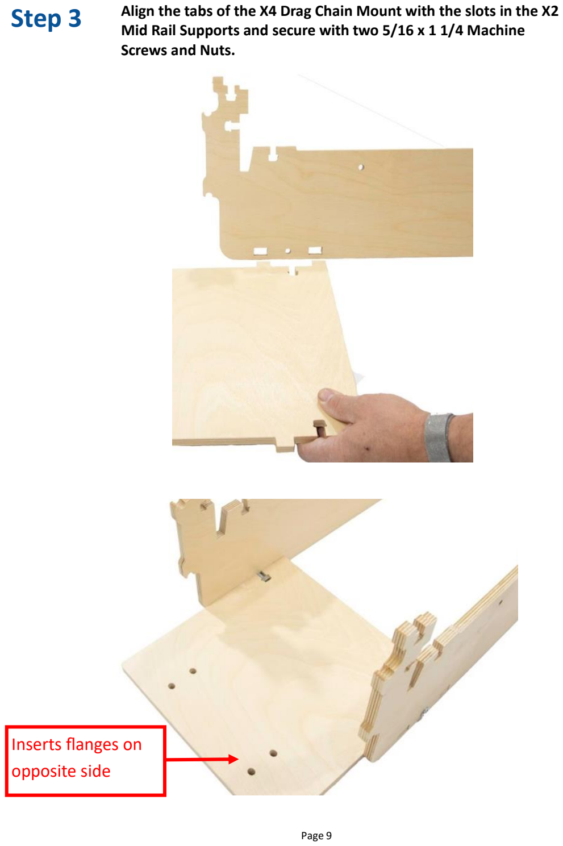
[picture p207: page 9]

Step 3 Align the tabs of the X4 Drag Chain Mount with the slots in the X2 Mid Rail Supports and secure with two 5/16 x 1 1/4 Machine Screws and Nuts.

Inserts flanges on
opposite side

Step 4 With the X2 Mid Rail assembly on a large flat work surface set the third X2 Mid Rail beside it as shown.

NOTE: In the photo below the assembly is setting on the KL733 Optional Table.

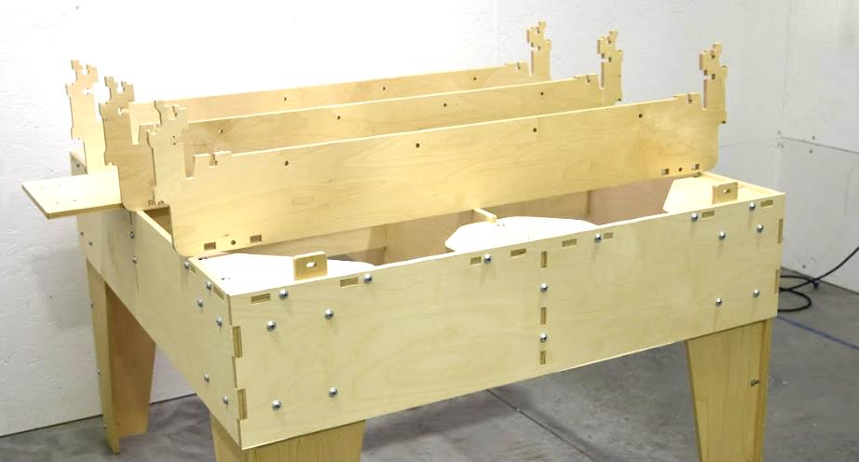
[picture p208: figure]

Align slots of the X Frame Side Assembly with the X2 Mid Rail Supports as shown. Carefully slide the slots down until the bottom of the slot rests on the base of X Frame Side Assembly. The tabs on the X2 Mid Rail Supports will fit in slots of the X Frame Side Assembly. Secure with three 5/16 x 1 1/4 Machine Screws and Nuts.

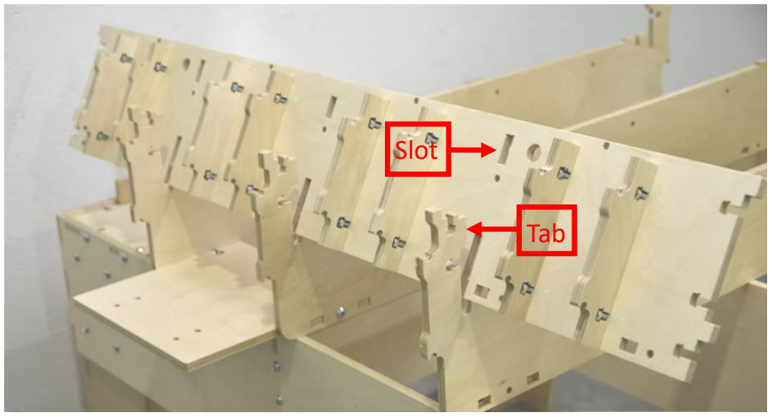
[picture p209: figure]
Slot; Tab

Repeat to install the remaining X Frame Side Assembly on the opposite side.

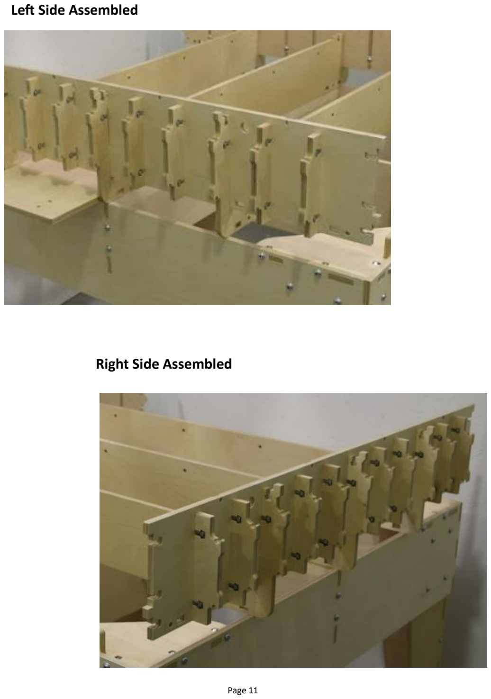
[picture p210: page 11]

Left Side Assembled

Right Side Assembled

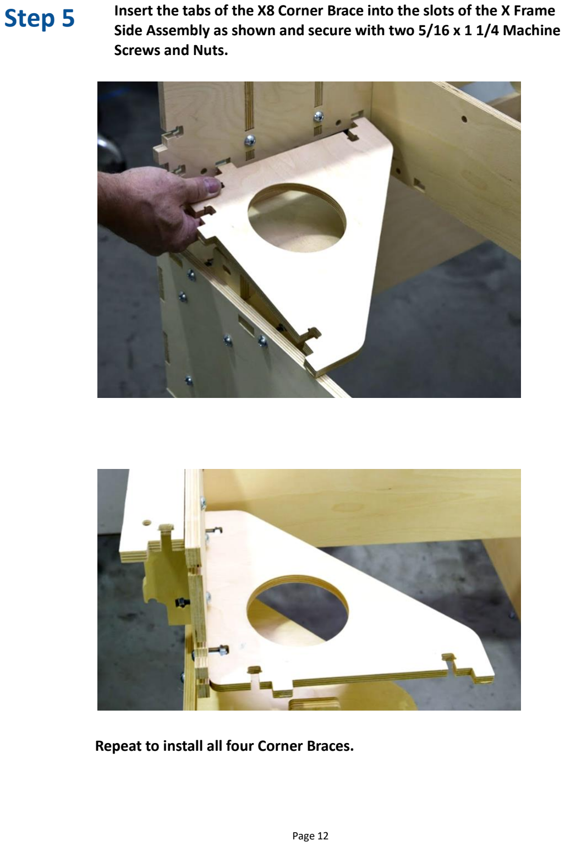
[picture p211: page 12]

Step 5 Insert the tabs of the X8 Corner Brace into the slots of the X Frame Side Assembly as shown and secure with two 5/16 x 1 1/4 Machine Screws and Nuts.

Repeat to install all four Corner Braces.

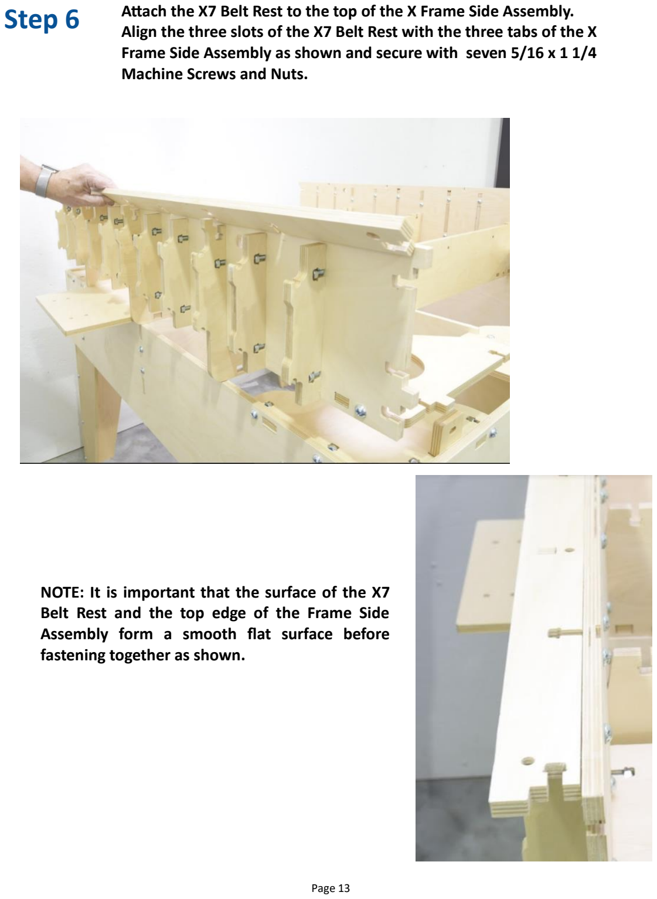
[picture p212: page 13]

Step 6 Attach the X7 Belt Rest to the top of the X Frame Side Assembly. Align the three slots of the X7 Belt Rest with the three tabs of the X Frame Side Assembly as shown and secure with seven 5/16 x 1 1/4 Machine Screws and Nuts.

NOTE: It is important that the surface of the X7 Belt Rest and the top edge of the Frame Side Assembly form a smooth flat surface before fastening together as shown.

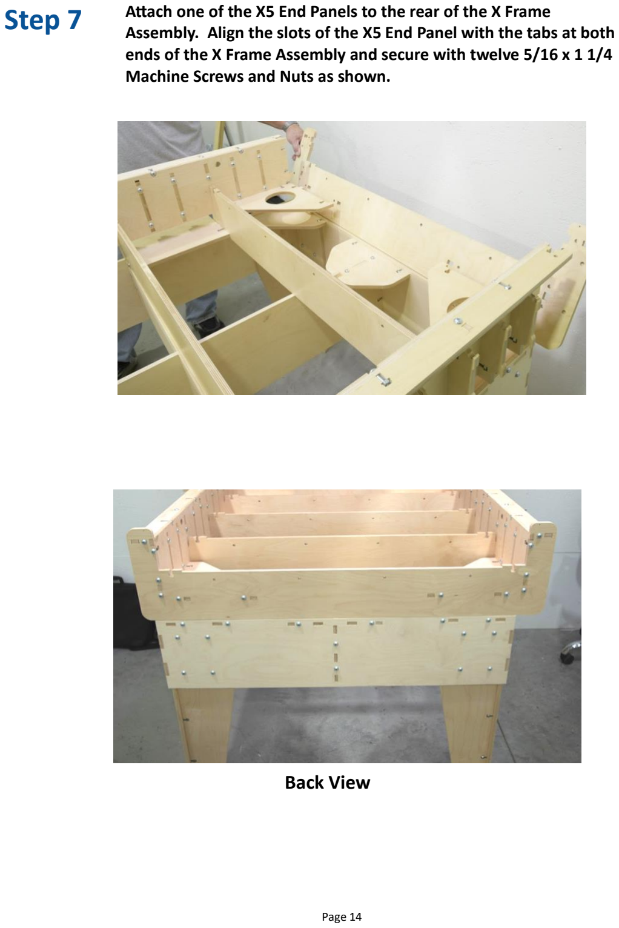
[picture p213: page 14]

Step 7 Attach one of the X5 End Panels to the rear of the X Frame Assembly. Align the slots of the X5 End Panel with the tabs at both ends of the X Frame Assembly and secure with twelve 5/16 x 1 1/4 Machine Screws and Nuts as shown.

Back View

Step 8 Carefully slide an X Rail through the X3 Rail Supports until it is fits into the pocket hold in the X5 End Panel as shown.

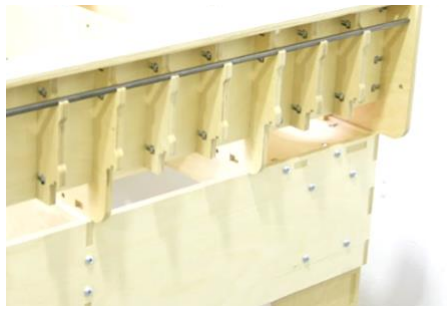
[picture p214: figure]
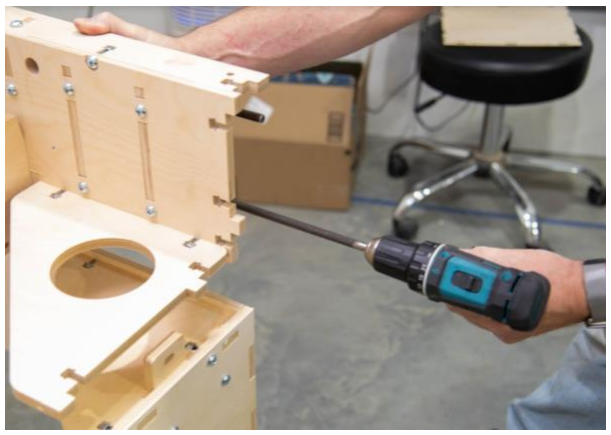
[picture p215: figure]

NOTE: To make installing the rods easier you can slowly rotate the rail through the Rail Supports by using a 3/8 variable speed drill as shown.

NOTE: Do not snap the rod into place.

Apply Teflon dry lube to the rail prior to installation.

Hint

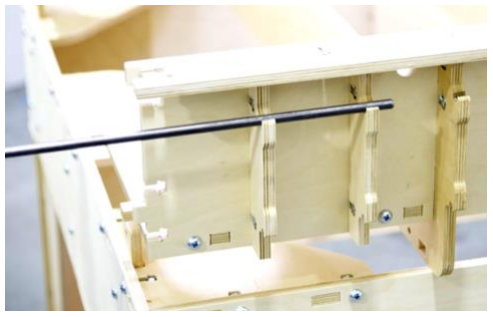
[picture p216: figure]
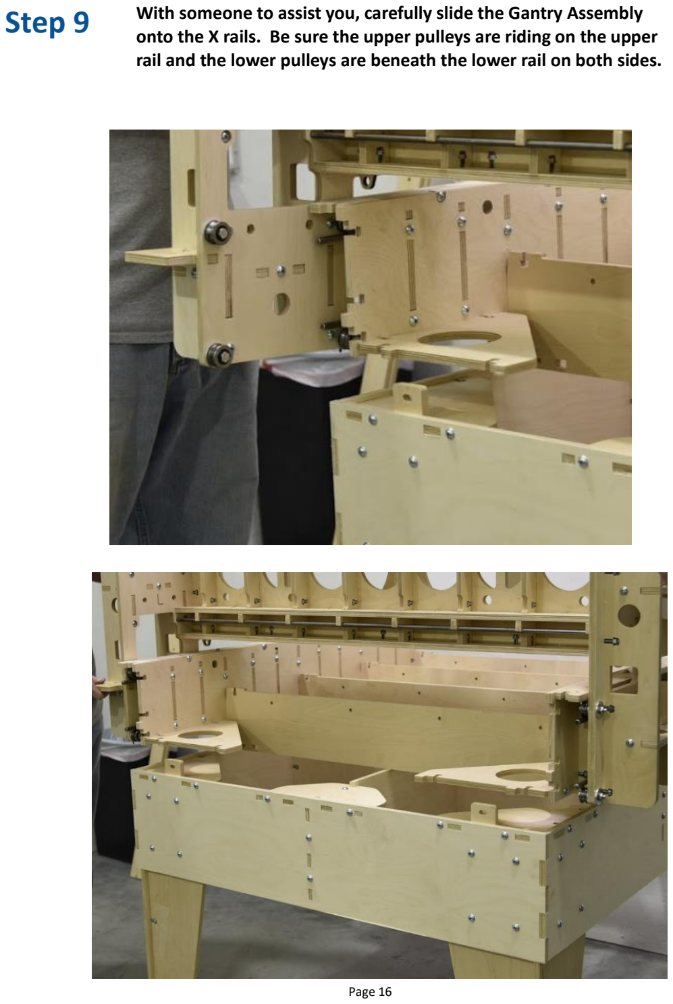
[picture p217: page 16]

Step 9 With someone to assist you, carefully slide the Gantry Assembly onto the X rails. Be sure the upper pulleys are riding on the upper rail and the lower pulleys are beneath the lower rail on both sides.

Step 10 Attach the remaining X5 End Panel to the front of the X Frame Assembly. Align the slots of the X5 End Panel with the tabs at both ends of the X Frame Assembly and secure with twelve 5/16 x 1 1/4 Machine Screws and Nuts as shown.

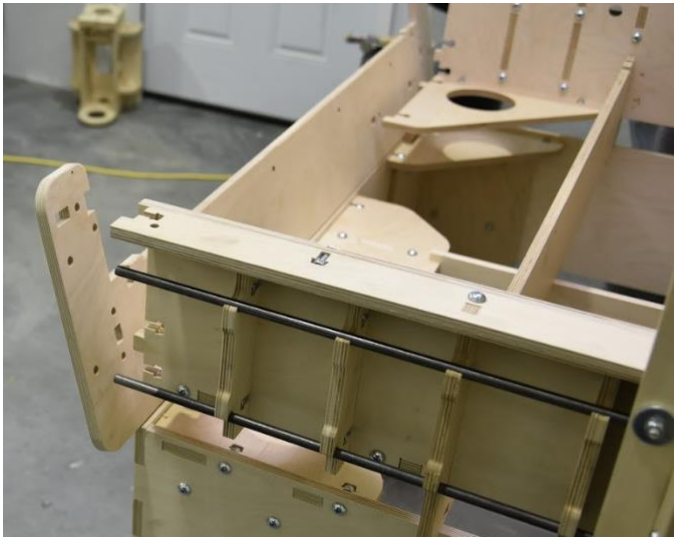
[picture p218: figure]

Step 11 On the Gantry Sides, using a 5/64 Allen Wrench, adjust the 8-32 Set Screws to snug the lower pulley against the lower rail. Repeat for all four lower Set Screws. The pulley should be full engaged with the rail and only roll when the Gantry moves.

NOTE: Remember to apply Locktite 243 to the threads of the Set Screws.

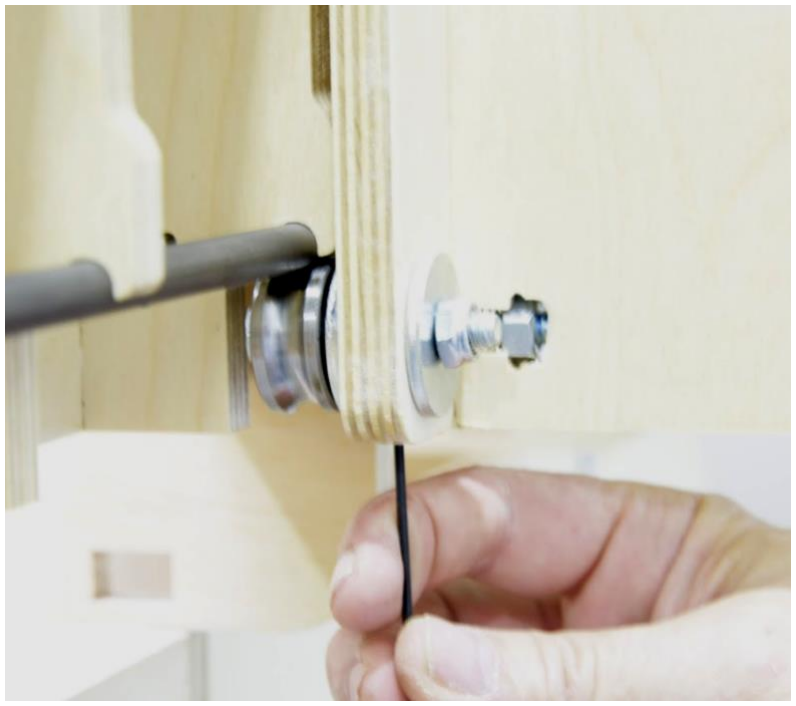
[picture p219: figure]
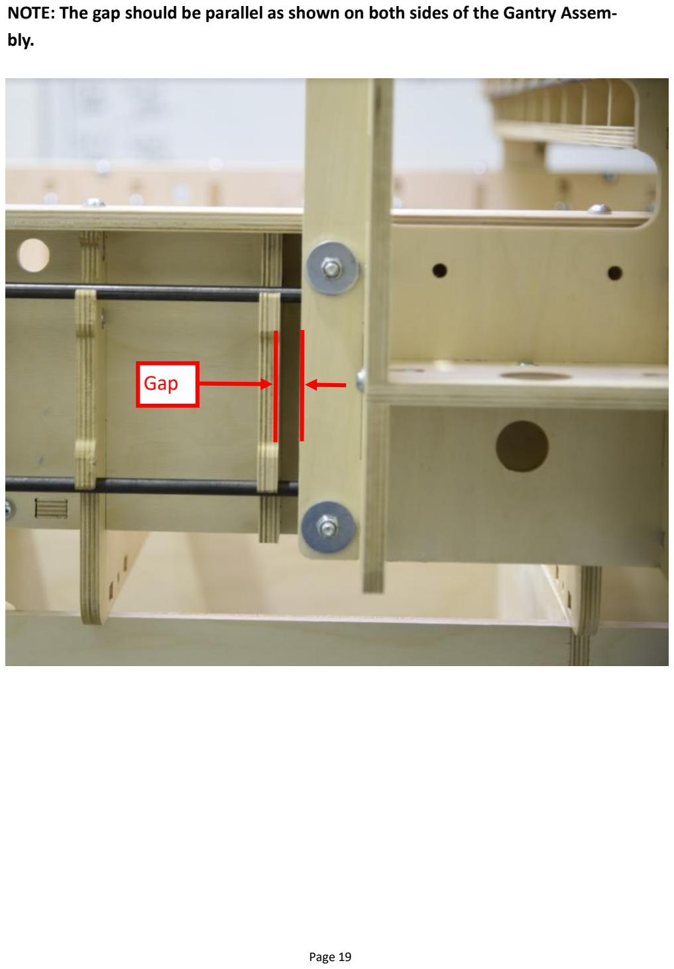
[picture p220: page 19]

NOTE: The gap should be parallel as shown on both sides of the Gantry Assembly.

Gap

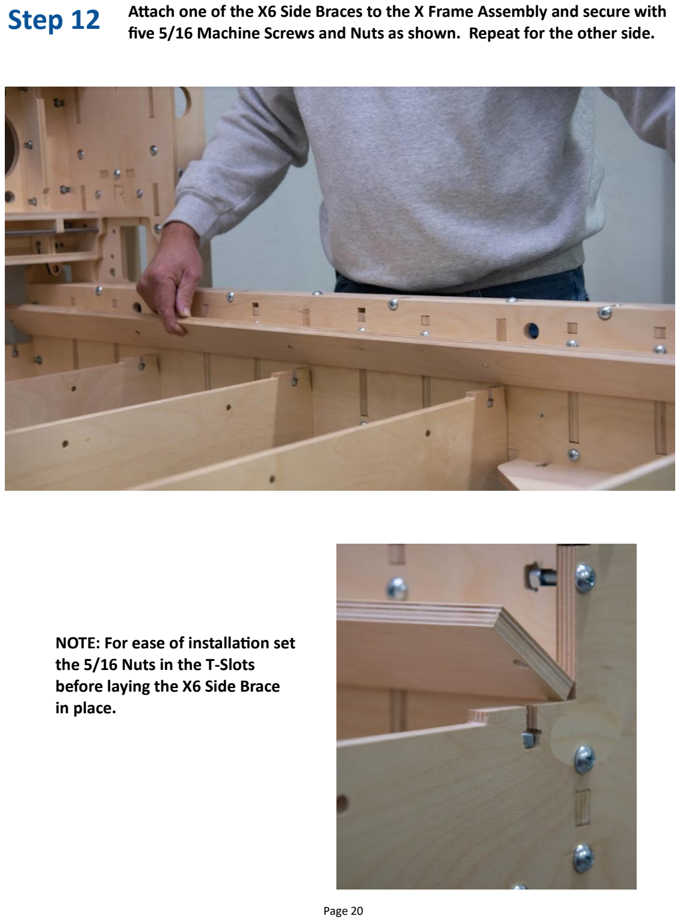
[picture p221: page 20]

Step 12 Attach one of the X6 Side Braces to the X Frame Assembly and secure with five 5/16 Machine Screws and Nuts as shown. Repeat for the other side.

NOTE: For ease of installation set the 5/16 Nuts in the T-Slots before laying the X6 Side Brace in place.
