rlwoodjr/Router-Files/KL7/Manuals/Manual 5 744 Mechanical Assembly Rev. 2.6.pdf

KL744

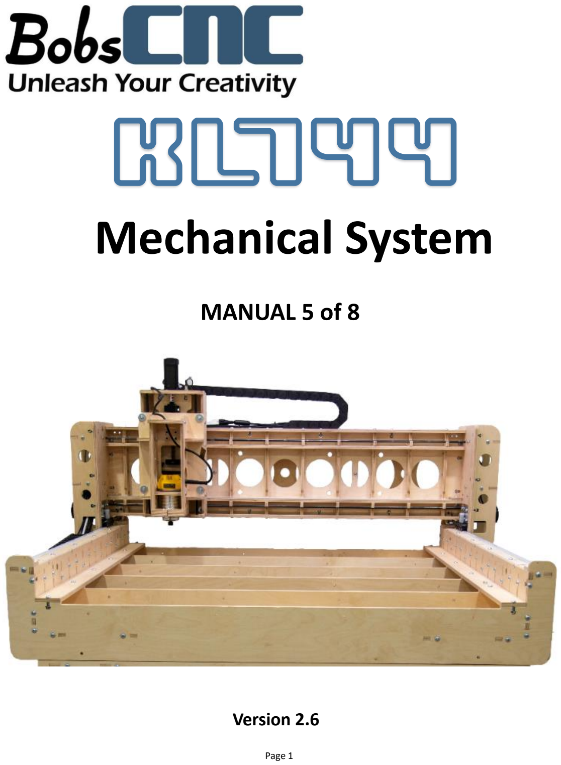
[picture p319: page 1]

Version 2.6

# Mechanical System

## MANUAL 5 of 8

### Table of Contents

Mechanical Systems Hardware ······································································3-4

Safety Information and Hints·········································································5

Installing the Static Bell Everman Belts··························································6-9

Installing the X1 & X2 Servo Motors | 10-11

Installing the Y Servo Motor to the Y Carriage···············································12-15

Installing the Z Servo Motor to the Ball Screw Assembly ··························· 16-17

Installing the X1 & X2 Dynamic Bell Everman Belts ·······································18-21

Installing the Y Carriage on the Gantry ··························································22-23

Installing the Y Bell Everman Dynamic Belt ···················································24-26

Preparing the Drag Chain ···············································································27-29

Attaching the Cable Drag Chains····································································30-32

Cable Routing of the Servo Motor Wires/Cables···········································33-43

Installing the Z Home Switch | 45-46
Installing the X Home Switches... | 49-51
Tightening the Bell Everman Dynamic Belts | 53-57
Attaching the Z Assembly | 58-59
Routing the Extension Cord and Attaching the Spindle | 60-62
Wire Management | 63-64
Assembling and Mounting the Vacuum Brush Shoe | 65-67

# Mechanical System Hardware Components

Part # | Description | Qty | Photo
H24 | Tape (roll) | 1
H8 | T5 Timing Belt Roll (10M) | 1
| 10-24 x 3/4 Hex Head Screws | 4
| M5 Washer | 12
| M5x30 Socket Head Bolt | 4
H3 | 5/16 x 1 1/4 Machine Screw | 6
H5 | 5/16 Lock Nuts | 6
H6 | Large Zip Ties | 50
| 20’ Extension Cord | 1

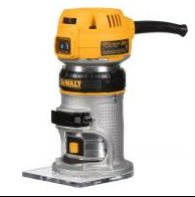
[picture p320: figure]

| DeWalt 611 Router | 1
| Drag Chain | 2
H4 | 5/16 x 1 Hex Head Bolt | 1

Part # | Description | Qty | Photo
H24 | Adjustment Tool | 1
| Vacuum Shoe | 1
| Vacuum Shoe Retainer

possible injury and death. This; carried out with extreme caution.

Indicates the possible damage to the machine, it’s components, or the work piece that can result from the failure to follow this Instruction.

# WARNING


Indicates a possible risk of injury that can result from failure to follow this warning.

# CAUTION

Indicates a serious risk of bodily harm,

warning box is to be taken seriously. Any work must be

### Please review each assembly manual before beginning to

assemble the KL7 series CNC Router.

Safety Information and Hints.

Hints will provide needed information, shortcuts, and insights that will make assembly and machine operation easier and safer.

Hint

## Step 1

The Bell Everman Drive system requires two belts on each axis, one Static the other Dynamic. The Static Belt is attached to the Belt Support. The Dynamic Belt is routed through the Bell Everman Drive. The teeth of the Dynamic Belt are meshed into the teeth of the Static Belt beneath the Idler Pulleys and driven by the Dynamic Belt as its teeth are
Hint | engaged by the Timing Pulley.

Clean the Belt Support surfaces using denatured alcohol and a clean paper towel or lint-free cloth as shown.
NOTE: The 3M double sided tape supplied with your kit was specifically designed to adhere to a polyurethane surface. Before proceeding, make sure you applied two coats of polyurethane to all the wood components.

# Installing the Static Bell Everman Belts

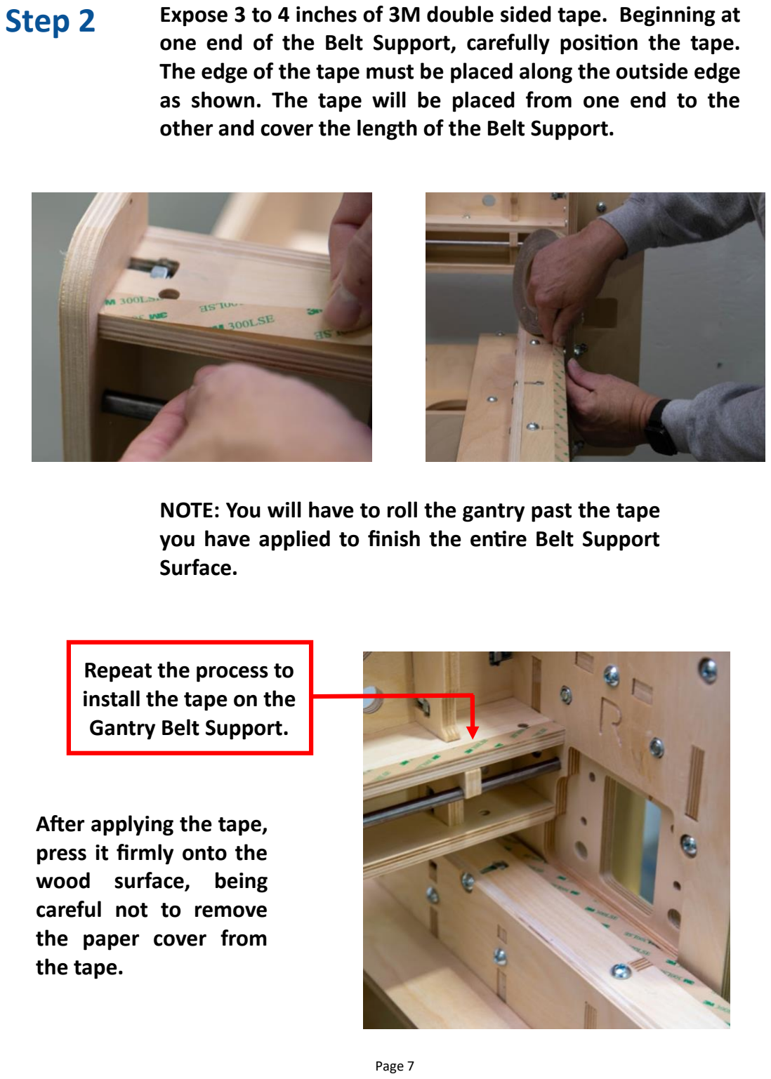
[picture p321: page 7]

Step 2 Expose 3 to 4 inches of 3M double sided tape. Beginning at one end of the Belt Support, carefully position the tape. The edge of the tape must be placed along the outside edge as shown. The tape will be placed from one end to the other and cover the length of the Belt Support.

NOTE: You will have to roll the gantry past the tape you have applied to finish the entire Belt Support Surface.

Repeat the process to
install the tape on the
Gantry Belt Support.

After applying the tape,
press it firmly onto the
wood surface, being
careful not to remove
the paper cover from
the tape.

Step 3 Measure a length of belt approx. 1/8” shorter than the Belt Support. Using snips, cut the belt to length.


Step 4 Clean any oil, dust and dirt from the back of the belt with denatured alcohol and a lint-free rag.


Step 5 Peel back a few inches of the paper protective layer and carefully position the belt so its edge is flush to the edge of the Belt Support as shown.


Working from one end to
the other, carefully
position the Belt along
the edge of the Belt
Support.


After the belt is set firmly, press it into the tape for maximum adhesion. Repeat
for the remaining 2 belts.

# Installing the X1 and X2 Servo Motors


Step 1 Thread the Servo Motor and Encoder Wires through

the Left side of the Gantry as shown

Step 2 Secure the Bell Everman assembly in place with four

1 1/4 Machine Screws and Lock Nuts as shown.

Step 3 Remember Wire Management. Bundle the Servo Motor and Encoder wires together. Secure with Zip Ties as shown. Repeat procedure to install the X2 Servo Motor on the right side.


## Step 1


The bolt and nut
must be positioned
on the top of the
support.

Thread a 5/16 Nut onto the 5/16-18 x 1 Hex Head Bolt as shown and insert it in the Rail Support as shown.
NOTE: In this step thread the nut until it touches the head of the bold. This bolt will be used to tighten the Y axis belt in a later step.

# Installing the Y Servo Motor to the Y Carriage


Step 2 Route the Servo Motor and Controller cable through the back of the Y Carriage Assembly as shown.

Step 3 After carefully pulling all the cables through the Y Carriage, loop the excess wire and secure it with two zip ties. Hang it over the back of the Carriage Mount Top.

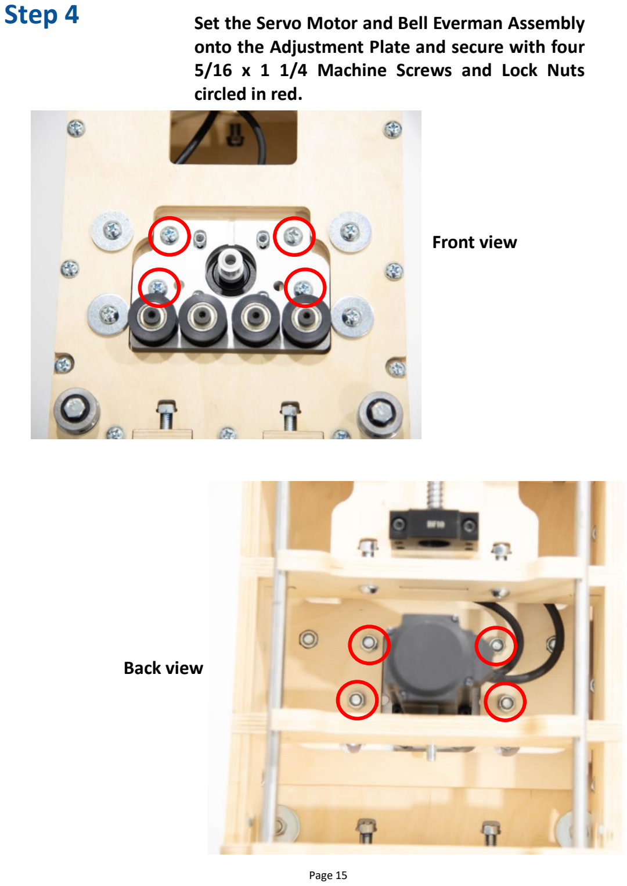
[picture p322: page 15]

Step 4 Set the Servo Motor and Bell Everman Assembly

onto the Adjustment Plate and secure with four 5/16 x 1 1/4 Machine Screws and Lock Nuts circled in red.

Back view

Front view

Step 1 Align the Servo Motor shaft with the opening in the Spider Coupler as shown. Secure the Servo Motor with four 10-24 x 3/4 Socket Head Bolts, tighten with a 4 mm Allen Wrench.

# Installing the Z Servo Motor to the Ball Screw Assembly

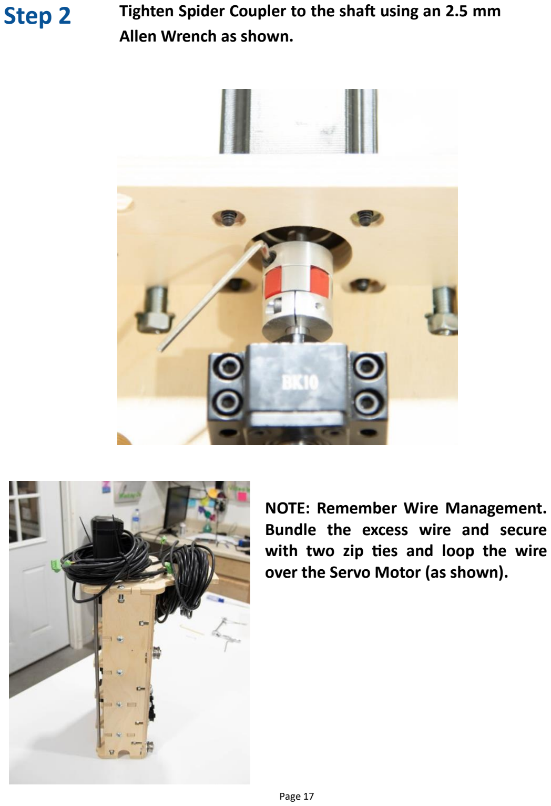
[picture p323: page 17]

Step 2 Tighten Spider Coupler to the shaft using an 2.5 mm Allen Wrench as shown.

NOTE: Remember Wire Management. Bundle the excess wire and secure with two zip ties and loop the wire over the Servo Motor (as shown).

Step 1 At the back left of the X1 axis, align and mesh the ends of the belts together. Secure with the a X9 Belt Holder and one 5/16 x 1 1/4 Machine Screw and Lock Nut as shown.

# Installing the X1 and X2 Dynamic Bell Everman Belts


Step 2 Pull the Bell Everman Assembly up so that there is a gap between the Idler Pulleys and the Static belt.
Step 3 Slip the Dynamic Belt beneath the two back Idler Pulleys.


Step 4 Loop the Dynamic Belt over the Timing Pulley and then route it beneath the two front Idler Pulleys.

Remove excess slack from the Belt Pully and Push the Bell Everman Assembly down so that the belt is meshed as shown.

The belt will not be
tight at this step in the
process. The belts will
be tightened in a later
step.


Repeat above steps to install the X2 Dynamic Belt.

Step 5 Trim the belt to length and secure with a X9 Belt Holder and one 5/16 x 1 1/4 Machine Screw and Nut.
Step 6 Tighten the four screws holding the Bell Everman Assembly in place, making certain the belts are meshed.

## Step 7

# Installing the Y Carriage on the Gantry

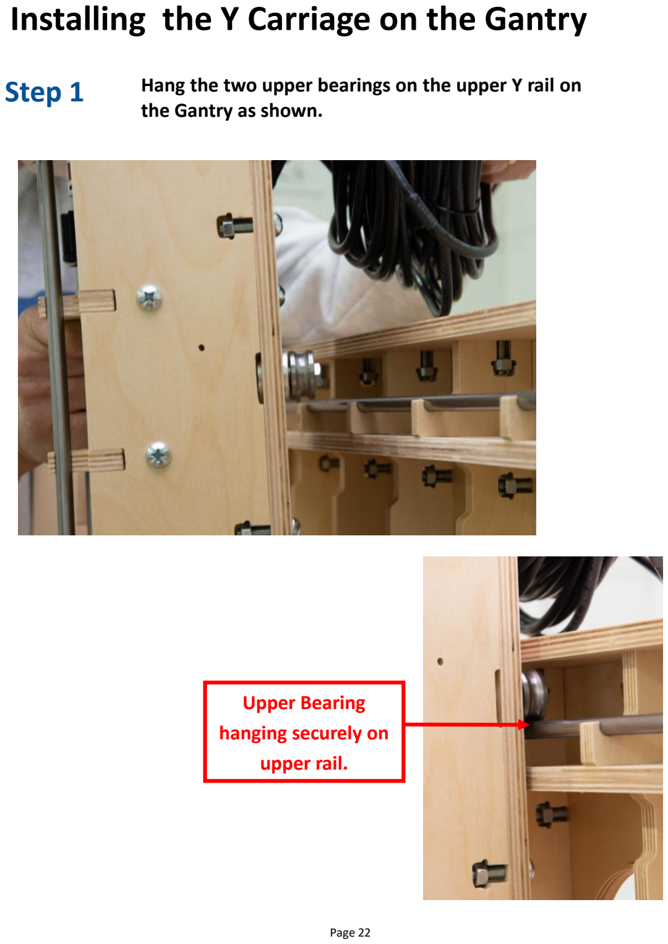
[picture p324: page 22]

Step 1 Hang the two upper bearings on the upper Y rail on the Gantry as shown.

Upper Bearing
hanging securely on
upper rail.

Step 2 Raise the lower Bearings against the lower Rail by adjusting the Set Screw in the bottom of the Y Carriage. Tighten in place with the 2mm Allen Wrench. The Bearings should only roll as the Carriage Assembly moves.


Step 3 Tighten the four 5/16 Nuts to secure the SG25U Bearings.

Step 1 At the back left side of the Gantry, align and mesh the ends of the Belts together. Secure with a G15 Belt Holder and one 5/16 x 1 1/4 Machine Screw and Lock Nut as shown.

# Installing the Y Bell Everman Dynamic Belt


Step 2 Route the Dynamic Belt beneath the two back Idler Pulleys with the Bell Everman Assembly in the upward position.


Viewed from behind through the Gantry

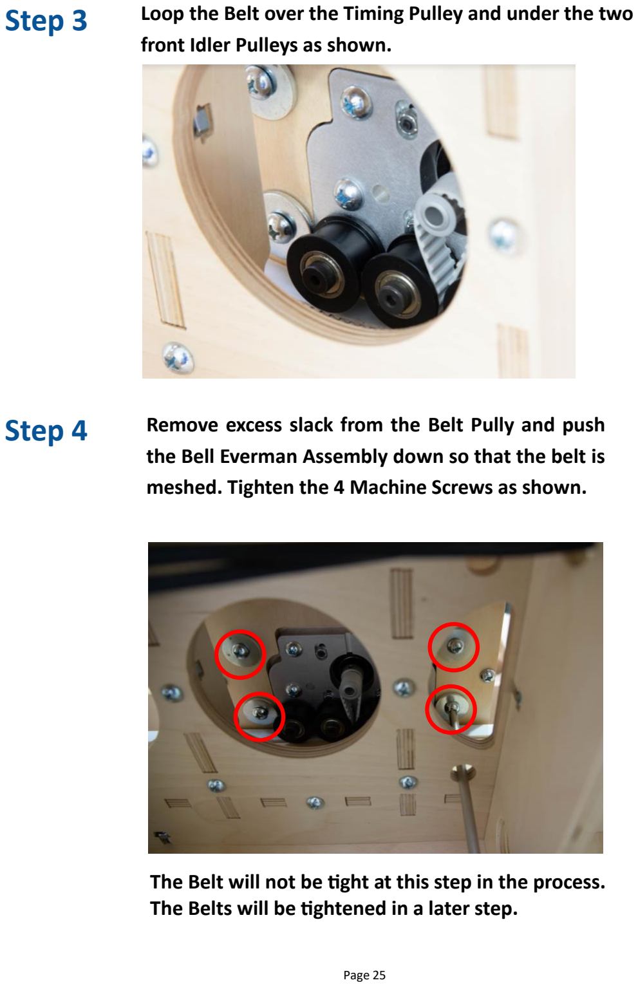
[picture p325: page 25]

Step 3 Loop the Belt over the Timing Pulley and under the two front Idler Pulleys as shown.
Step 4 Remove excess slack from the Belt Pully and push the Bell Everman Assembly down so that the belt is meshed. Tighten the 4 Machine Screws as shown.

The Belt will not be tight at this step in the process. The Belts will be tightened in a later step.

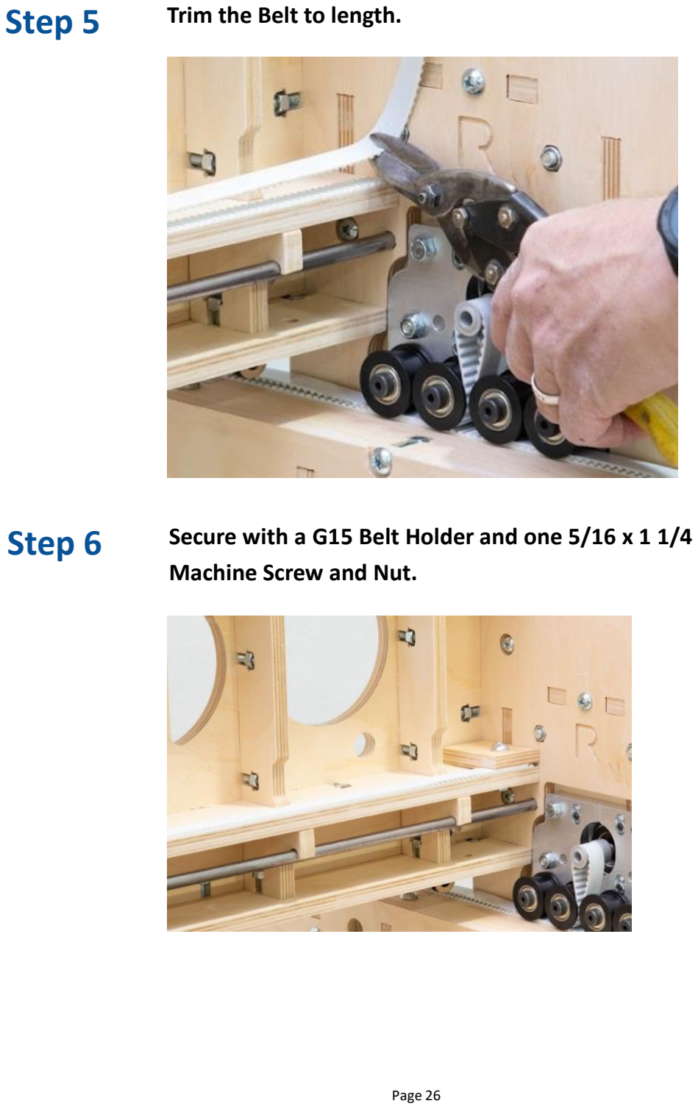
[picture p326: page 26]

Step 5 Trim the Belt to length.
Step 6 Secure with a G15 Belt Holder and one 5/16 x 1 1/4 Machine Screw and Nut.

Lay out the Drag Chain on its side. Notice the end cap of the end links. One end cap fits within the adjoining link. The other end cap fits around the outside of the adjoining link.


This end cap snaps within
the adjoining link.


This end cap snaps around
the adjoining link.

## Step 1

Preparing the Drag Chain.

Turn this end cap on its back and gently remove the connecting tab as shown.

This end cap snaps around
the adjoining link.


Turn the end cap on its back and remove the connecting
tab as shown.

Disconnect and remove the
end link. Turn it over and reconnect to the adjoining link as shown.

NOTE: Proper orientation of the Drag Chain ends.


## Attaching the Cable Drag Chains


Step 1 Attach the Left Side Drag Chain to the G8 Drag Chain Mount on the Left Side of the Gantry Assembly using two 10-24 x 3/4 “ Socket Head Bolts and M5 Washers as shown.

Step 2 Attach the other end of the Drag Chain to the X4 Drag Chain Support using two 10-24 x 3/4 Socket Head Bolts and M5 Washers as shown.

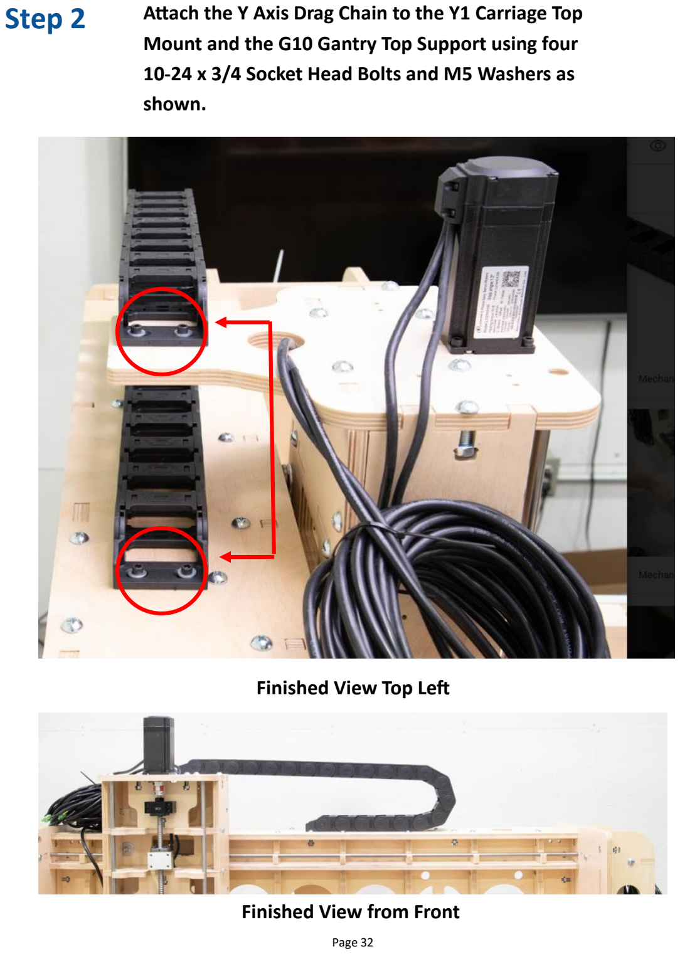
[picture p327: page 32]

Step 2 Attach the Y Axis Drag Chain to the Y1 Carriage Top Mount and the G10 Gantry Top Support using four 10-24 x 3/4 Socket Head Bolts and M5 Washers as shown.

Finished View from Front

Finished View Top Left

## Cable Routing of the Servo Motor Cables

## Preparing the Drag Chain for Wire Routing

Step 1 Slide the Gantry half way along the X axis as shown.


Step 2 Use a crescent wrench for leverage and GENTLY remove the upper connecting tabs on the Drag Chain as shown to the point where the chain loops back. Only remove the upper tabs.

Keep the tabs in a safe place for reinstallation later.

When removing the connecting tabs DO NOT remove the upper and lower tabs of a single link or the drag link will separate.

Hint


Step 3 Remove the upper tabs until you reach the bend


Leave one tab on the front of the bend.


Leave three tabs on the
back of the bend.

Step 4 Carefully label the Servo Motor and Encoder Cables for each of the axes (X1, X2, Y, and Z). The Encoder Connector has five pins, the Servo Motor Connector has six.
Tape the Cables of each axis pair together and label as shown.


Each set of Cables will need to be routed neatly through the structure and appropriate Drag Chain. Make sure the Cables are not kinked or rubbing against any sharp corners.

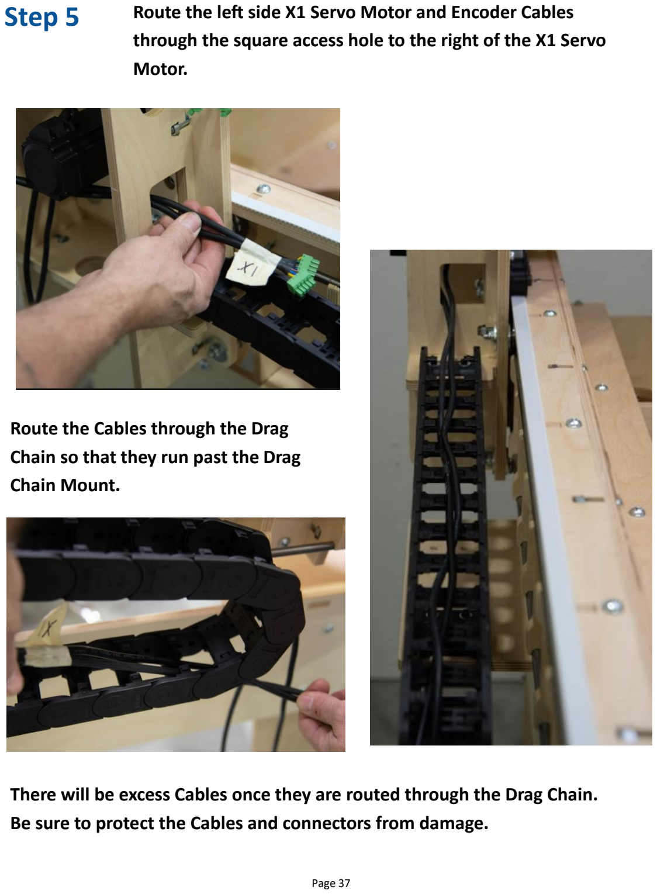
[picture p328: page 37]

Step 5 Route the left side X1 Servo Motor and Encoder Cables through the square access hole to the right of the X1 Servo Motor.

Route the Cables through the Drag Chain so that they run past the Drag Chain Mount.

There will be excess Cables once they are routed through the Drag Chain. Be sure to protect the Cables and connectors from damage.


Step 4 Route the Y Servo Motor and Encoder Cables across the Y1 Carriage Mount Top and into the Y/Z Drag Chain as shown.

Continue routing the Cables through the Left Gantry Side and Drag Chain as shown.

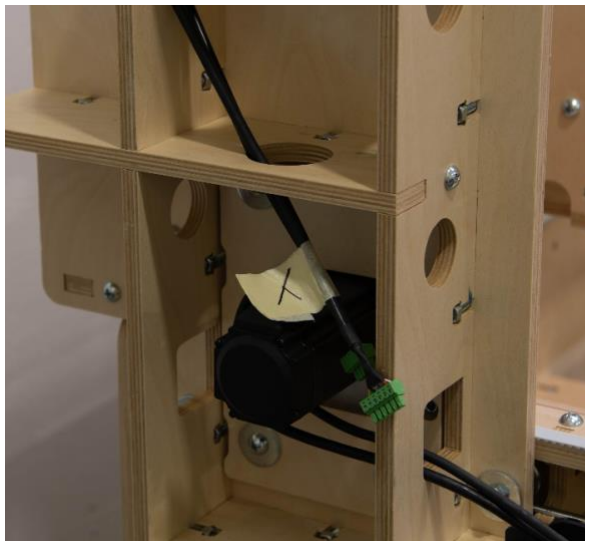
[picture p329: figure]
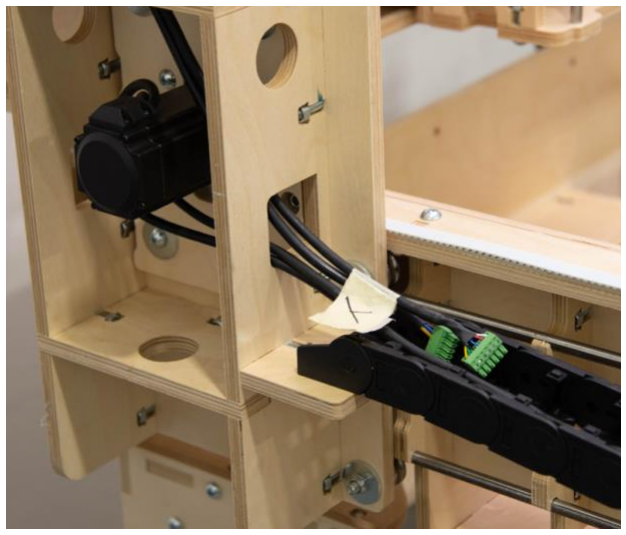
[picture p330: figure]

Bundle the excess Cables once they are routed and to protect the Cables and connectors from damage.


Step 6 Route the X2 Servo Motor and Encoder Cables up and through the Right Gantry Side and across the back of the Gantry Assembly, through the Left Side Gantry Assembly and into the Drag Chain as shown.
Step 5 Repeat to route the Z Servo Motor and Encoder Cables following the same path used for the Y Servo Motor and Encoder Cable.

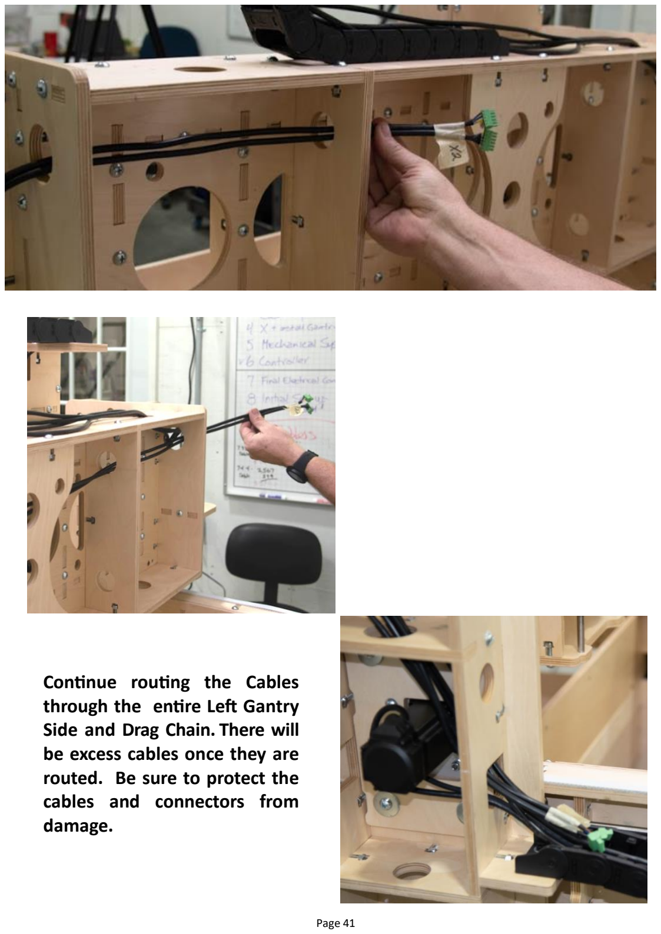
[picture p331: page 41]

Continue routing the Cables through the entire Left Gantry Side and Drag Chain. There will be excess cables once they are routed. Be sure to protect the cables and connectors from damage.

## Step 7


Gather all the Servo Motor and Encoder Cables. Starting from the connectors measure back 24 inches and bundle the Cables together with a Zip Tie. Then every 4 to 6 inches add a Zip Tie until the Cables enter the Drag Chain.

24”

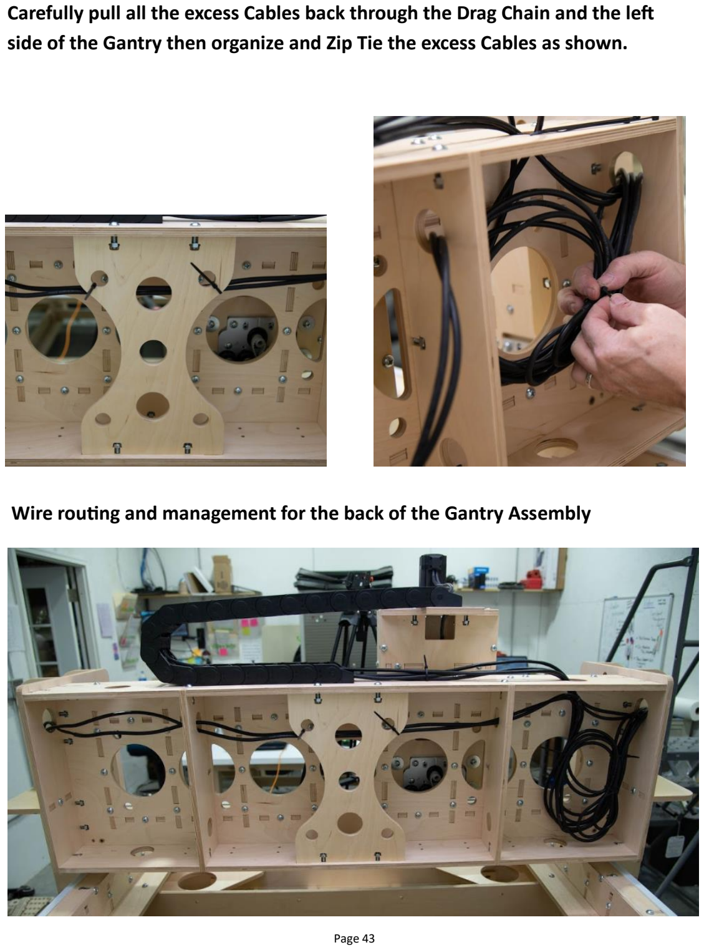
[picture p332: page 43]

Carefully pull all the excess Cables back through the Drag Chain and the left side of the Gantry then organize and Zip Tie the excess Cables as shown.

Wire routing and management for the back of the Gantry Assembly

Keep the Home Switch cables separate from the Servo Motor and Encoder Cables as much as possible to minimize electronic interference (noise) which can adversely affect machine performance.

# WARNING

# Preparing for the Home Switch Installation


Step 1 Separate and label the Home Switch cables, X1, X2, Y, and Z


Step 2 Remove the Nut and one of the Lock Washers from the all 4 of the Home Switches.


Step 1 Slip the Z Home Switch threaded body through Home Switch mount as shown. The hardware should be arranged: Upper Nut, Lock Washer, Plywood, Lock Washer, Lower Nut. Snug in

# Installing the Z Home Switch

Place the home switch so that the end of the barrel measures at least 1/2 inch from the Home Switch Mount surface.

NOTE: The mounting distance can be adjusted once the CNC is ready for operation. This will be done to maximize the amount of travel on the Z axis.

Hint

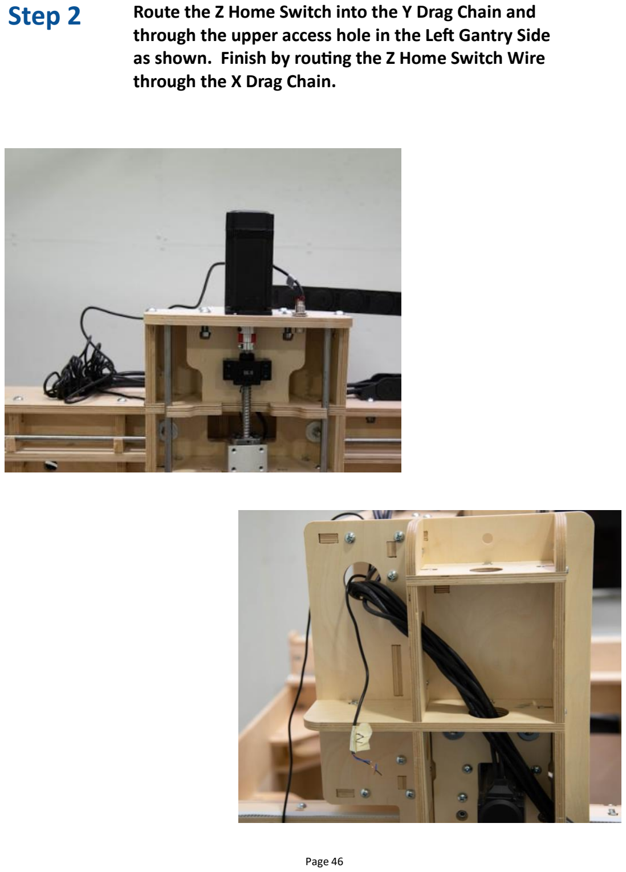
[picture p333: page 46]

Step 2 Route the Z Home Switch into the Y Drag Chain and through the upper access hole in the Left Gantry Side as shown. Finish by routing the Z Home Switch Wire through the X Drag Chain.

# Installing the Y Home Switch

Step 1 Place the threaded body through the Y Home Switch Mounting hole. Secure with the Nut and Lock Washer.


Place the home switch so that the end of the barrel measures at least 1/4 inch from the Home Switch Mount surface.

NOTE: The mounting distance can be adjusted once the CNC is ready for operation. This will be done to maximize the amount of travel on the Y axis.

Hint

Step 2 Finish by routing the Y Home Switch wire down and through the Drag Chain.


# Installing the X Home Switches

Step 1 Install the threaded body of the X2 Home Switch into X2 Home Switch Mount as shown.


Place the home switch so that the end of the barrel measures at least 1/2 inch from the Home Switch Mount surface.

NOTE: The mounting distance can be adjusted once the CNC is ready for operation. This will be done to maximize the amount of travel and the gantry is square with the X axis.

Hint


Step 2 Route the X2 Switch Wire up through the Gantry Bottom Support and out the back as shown.


Step 3 Route the X2 Switch Wire through the Gantry Frame and along the bottom of the Gantry Assembly as shown.

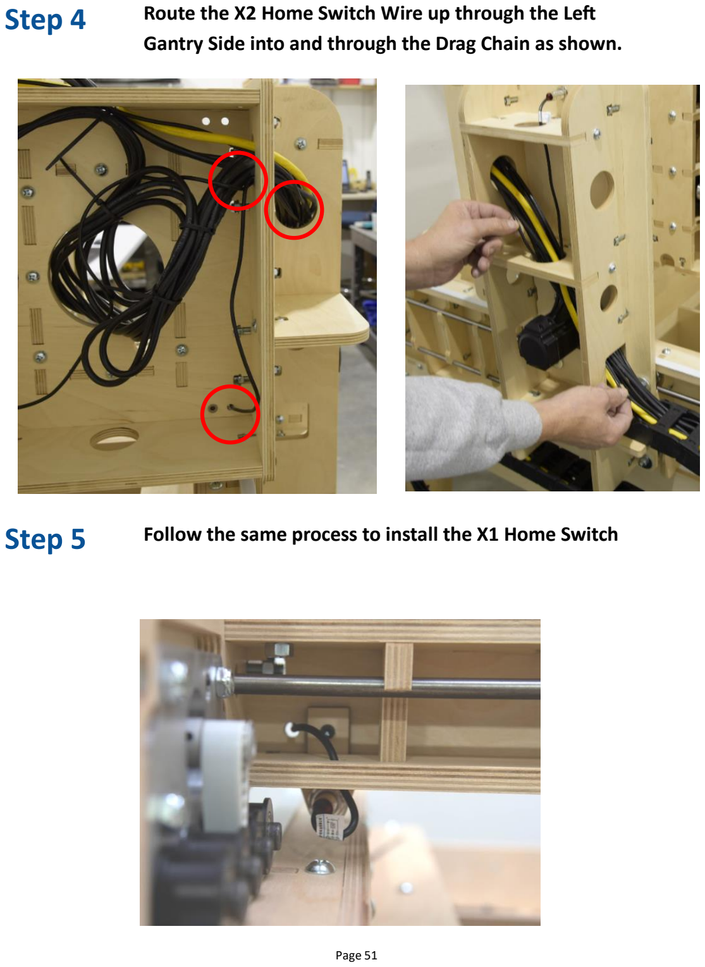
[picture p334: page 51]

Step 4 Route the X2 Home Switch Wire up through the Left Gantry Side into and through the Drag Chain as shown.

Follow the same process to install the X1 Home Switch Step 5

Trim Home Switch Wires to the same length as the Servo Motor and Encoder Cables. Once trimmed, bundle the X1, X2, Y and Z Home Switch Wires together with Zip Ties placed 6 inches apart.

## Step 1

# Securing, Trimming, and Managing the Excess Wires


Be careful to protect the connectors from damage. The connections to the Controller will be completed in a later step.

# Tightening the Bell Everman Dynamic Belts

# WARNING

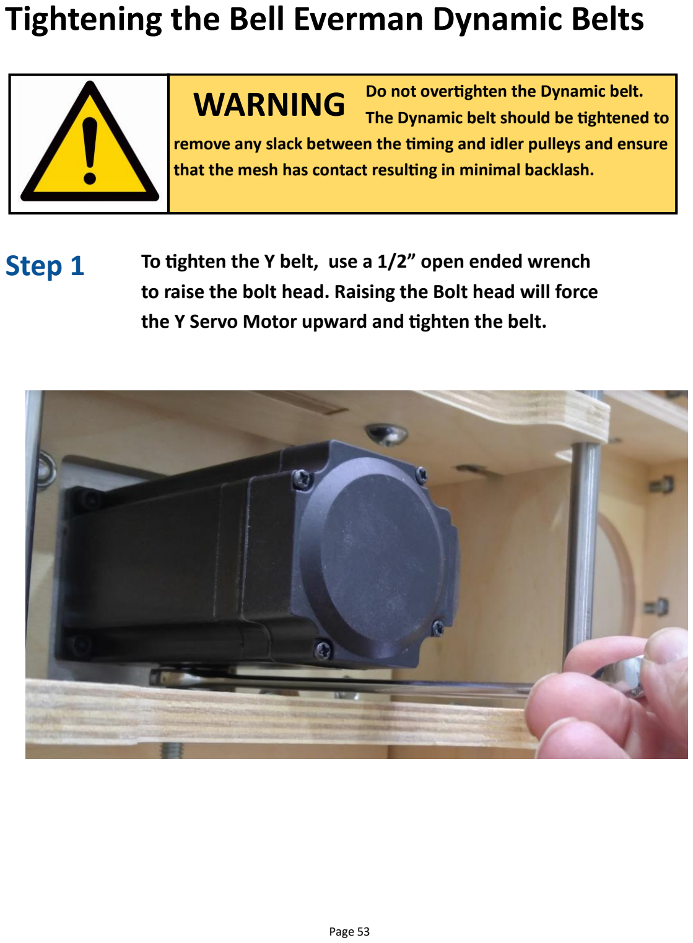
[picture p335: page 53]

To tighten the Y belt, use a 1/2” open ended wrench to raise the bolt head. Raising the Bolt head will force the Y Servo Motor upward and tighten the belt.

## Step 1

Do not overtighten the Dynamic belt. The Dynamic belt should be tightened to remove any slack between the timing and idler pulleys and ensure that the mesh has contact resulting in minimal backlash.

Once the Belt has been tightened, then tighten the four Y Servo Motor mounting Screws as shown.

## Step 2


Loosen the 5/16” Hex Bolt so that it no longer touches the Y Servo Motor.

## Step 3


Step 4 Assemble the X Servo Belt Tension Tool.

Insert a 5/16 Nut and the 5/16 x 1 Hex Head Bolt as shown.

Position the tool parts and secure with 5/16 x 1 1/4 Machine Screw and Nut as shown.

Step 5 Insert the Belt Tensioning Tool beneath the X1 Stepper

Motor and raise the head of the Bolt until it touches the Motor Assembly.

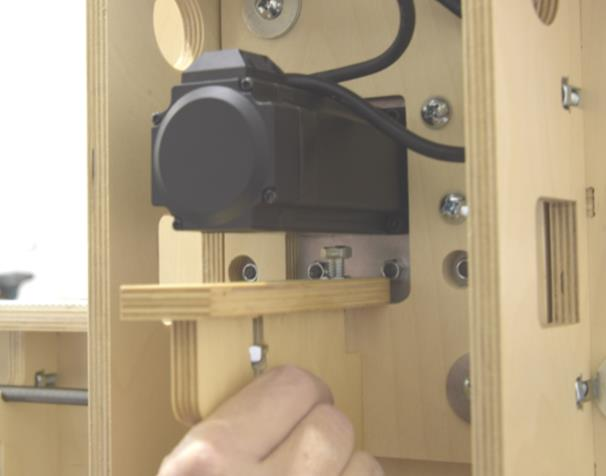
[picture p336: figure]

Using a 1/2” open end wrench, gently adjust the Bolt up against the motor housing until the Belt is properly tightened. Remove the slack between the Timing and Idler Pulleys. Repeat process for the X2 Stepper Motor.

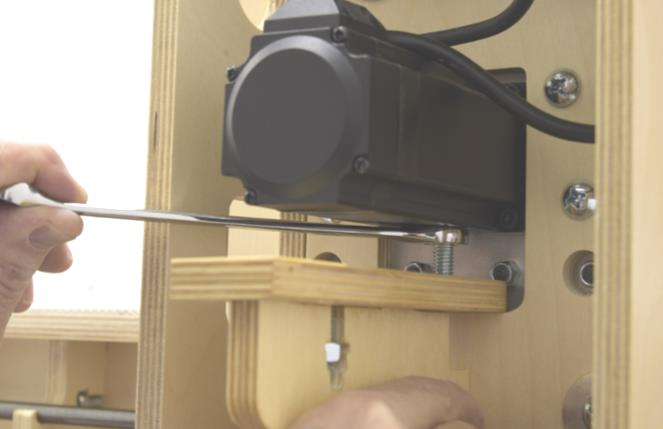
[picture p337: figure]


Properly tightened belt with teeth fully engaged beneath the Idler Pulleys.

## Step 1

# Attaching the Z Assembly

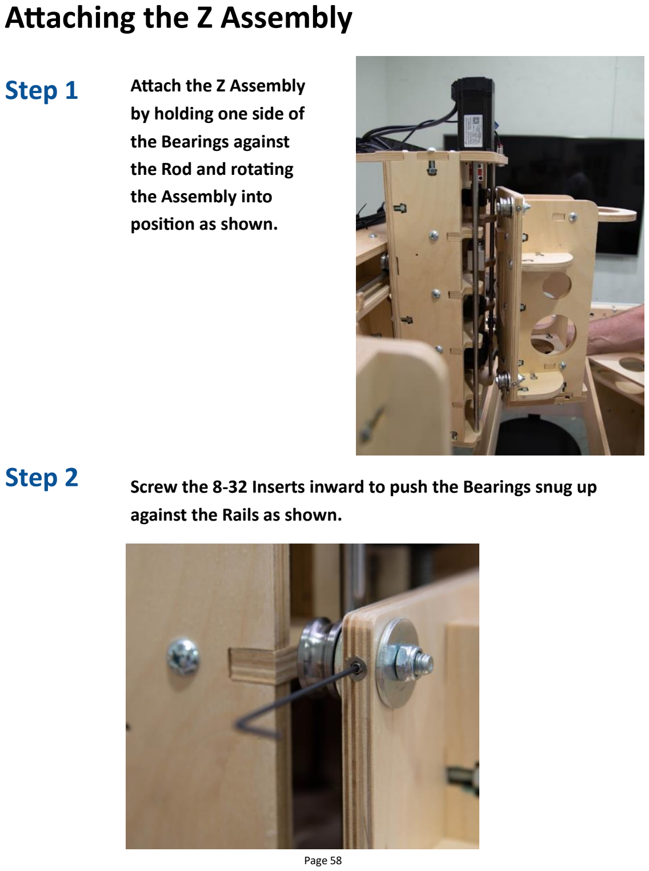
[picture p338: page 58]

Attach the Z Assembly
by holding one side of
the Bearings against
the Rod and rotating
the Assembly into
position as shown.

Screw the 8-32 Inserts inward to push the Bearings snug up against the Rails as shown.

## Step 2

Slide the Z Assembly and align the four mounting holes with the Ball Screw Nut Housing.

## Step 3

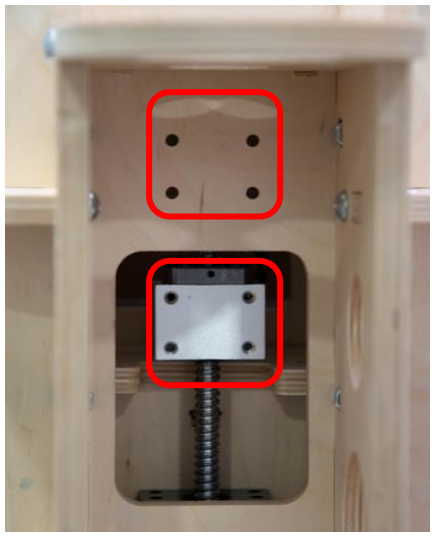
[picture p339: figure]

Tighten the Z Assembly to the Ball Screw Nut Housing using four M5 X 30 Socket Head Screws with the M5 washers as shown.

## Step 4


## Step 1

# Routing the Extension Cord and Attaching

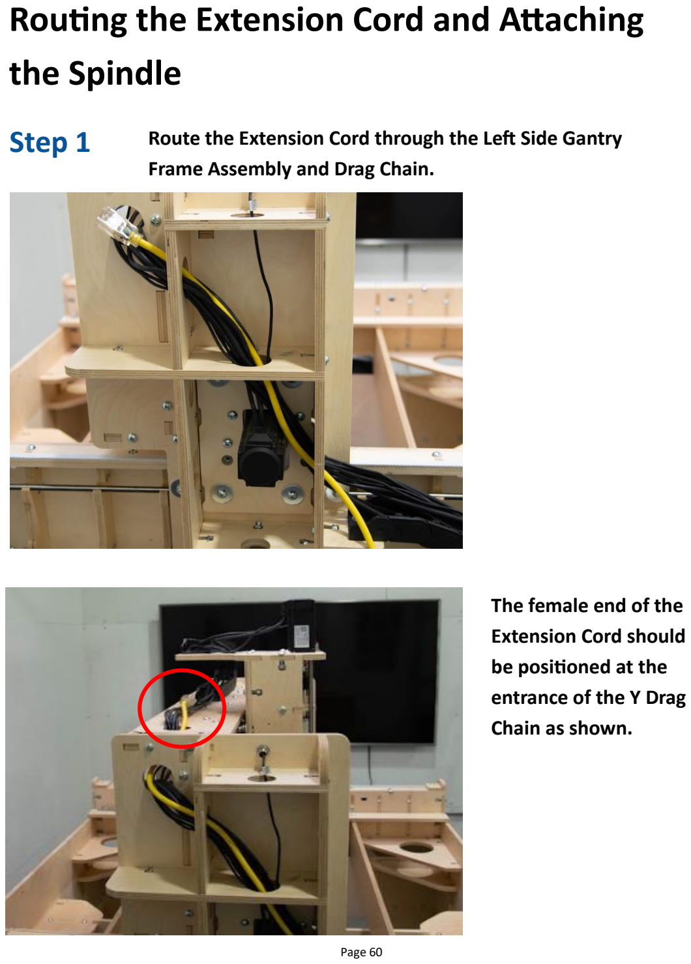
[picture p340: page 60]

Route the Extension Cord through the Left Side Gantry Frame Assembly and Drag Chain.

# the Spindle

The female end of the
Extension Cord should
be positioned at the
entrance of the Y Drag
Chain as shown.

## Step 2

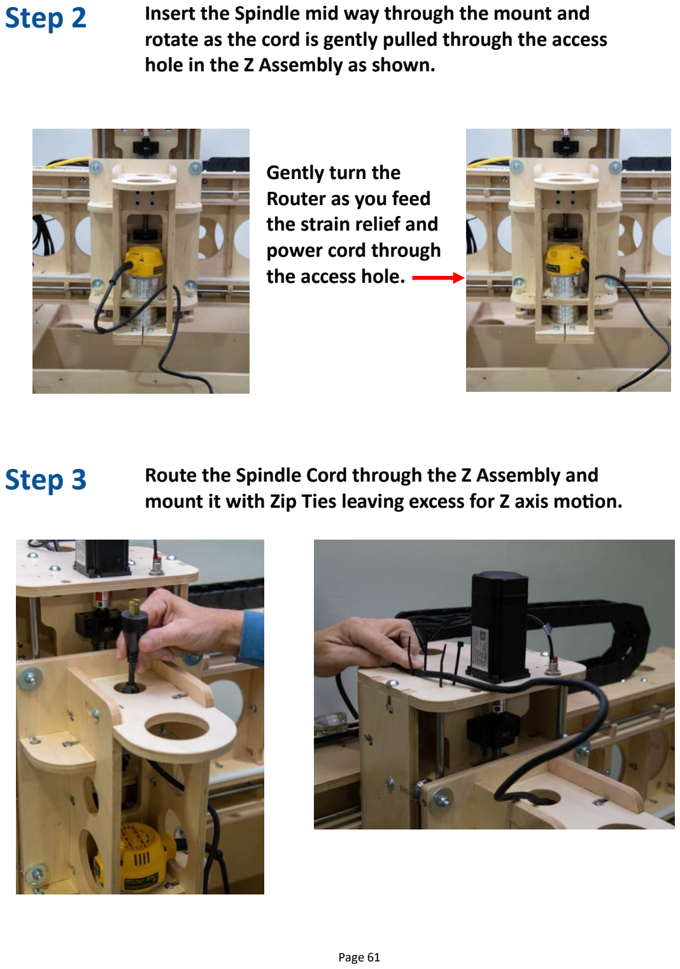
[picture p341: page 61]

Insert the Spindle mid way through the mount and rotate as the cord is gently pulled through the access hole in the Z Assembly as shown.

Route the Spindle Cord through the Z Assembly and mount it with Zip Ties leaving excess for Z axis motion.

## Step 3

Gently turn the
Router as you feed
the strain relief and
power cord through
the access hole.

Plug the Router into the Extension Cord as shown. Step 4

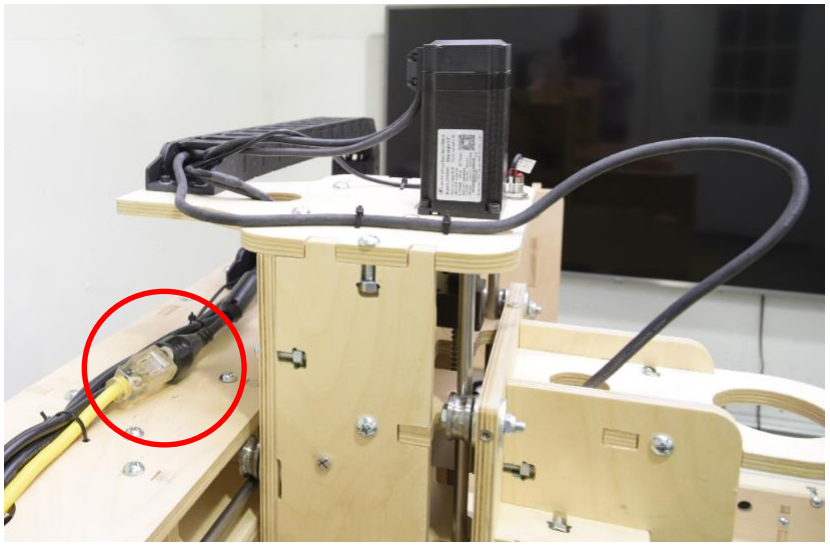
[picture p342: figure]

Re-install the Drag Chain Clips for Both Drag Chains. Be careful not to damage any of the Cables.

## Step 1

# Wire Management

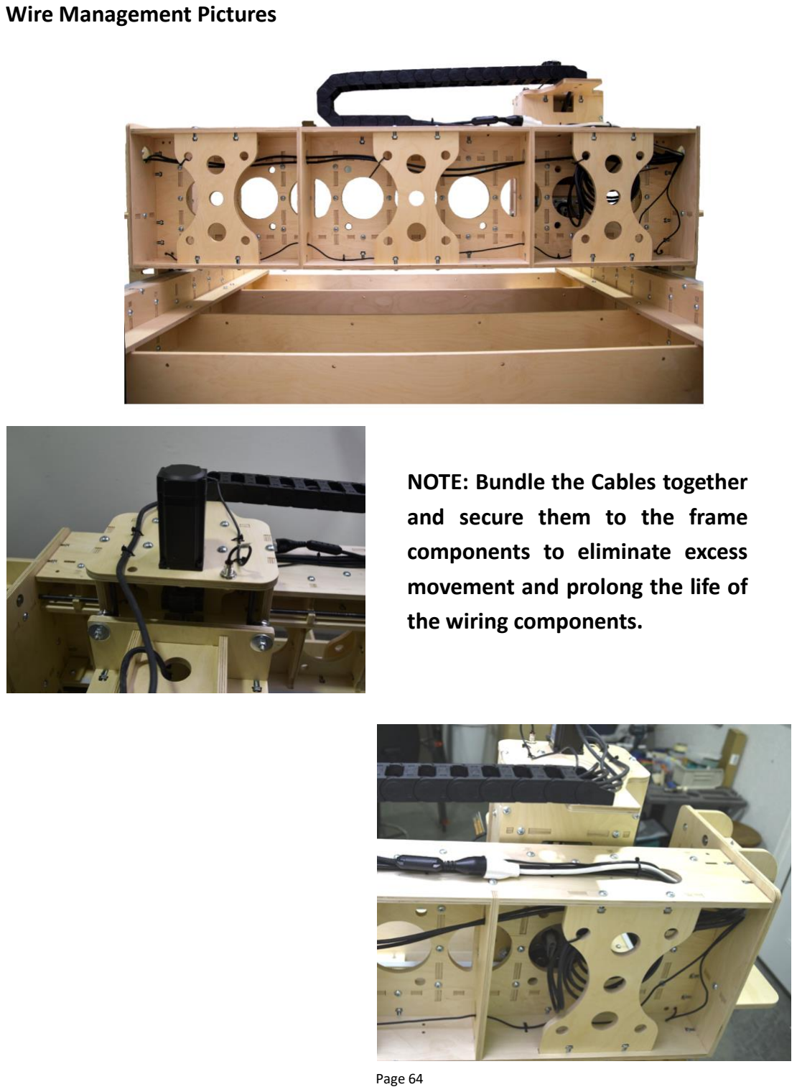
[picture p343: page 64]

Wire Management Pictures

NOTE: Bundle the Cables together and secure them to the frame components to eliminate excess movement and prolong the life of the wiring components.

Install two 1/4-20 Inserts into the Shoe Plate as shown. Step 1

# Assembling and Mounting the Vacuum Brush Shoe


Using a slotted screw driver, insert the 2” Brush material securely into the groove of the Shoe Plate until the brush completely surrounds the plate and trim to length. NOTE: You may have to sand the inside channel to widen.

## Step 2


## Step 2

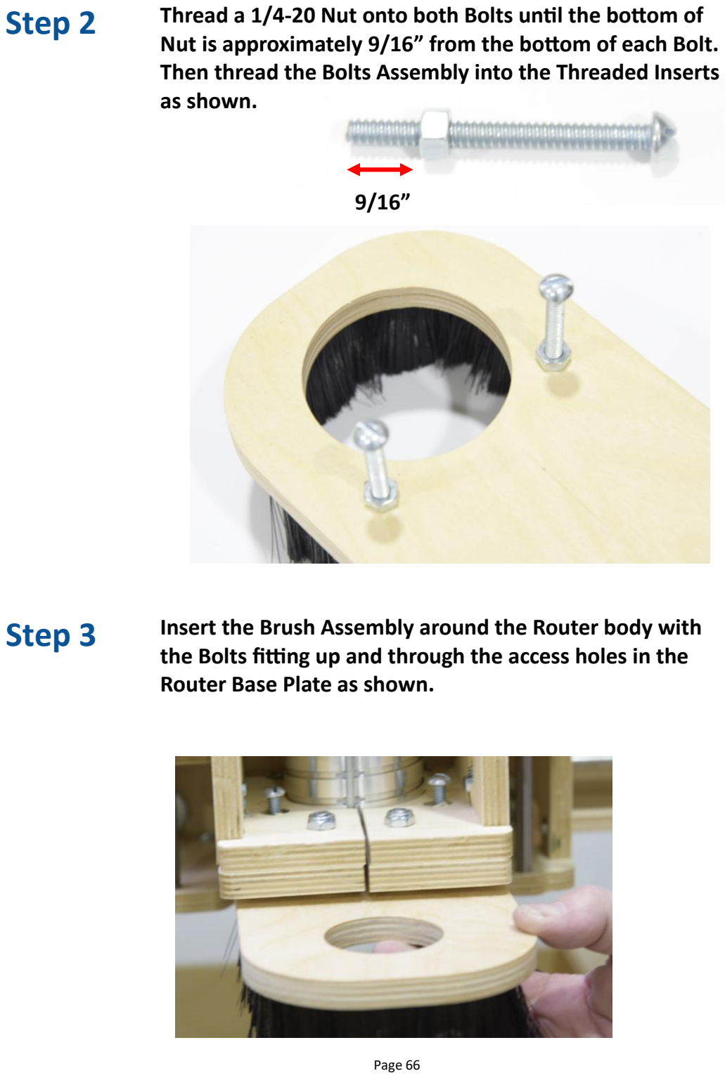
[picture p344: page 66]

9/16”

Thread a 1/4-20 Nut onto both Bolts until the bottom of Nut is approximately 9/16” from the bottom of each Bolt. Then thread the Bolts Assembly into the Threaded Inserts as shown.

Insert the Brush Assembly around the Router body with the Bolts fitting up and through the access holes in the Router Base Plate as shown.

## Step 3

## Step 4

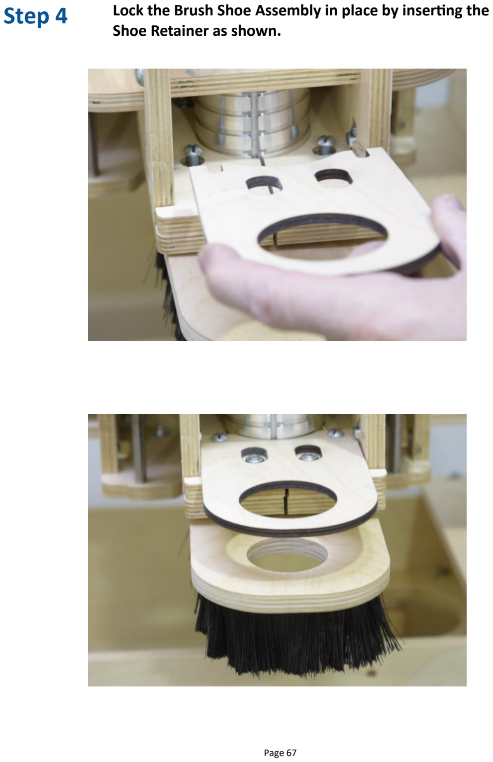
[picture p345: page 67]

Lock the Brush Shoe Assembly in place by inserting the Shoe Retainer as shown.
