rlwoodjr/Router-Files/Evolution/Manuals/finished assembly poster evolution 3.pdf

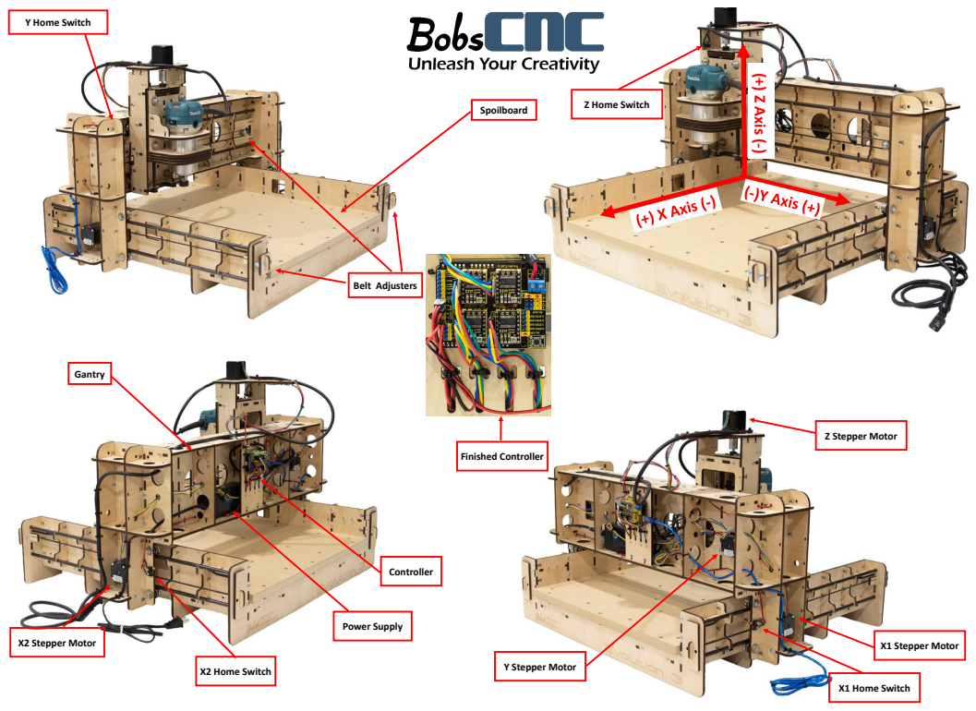
[picture p370: page 1]
X2 Home Switch; X1 Home Switch; Z Stepper Motor; Y Stepper Motor; X1 Stepper Motor; Controller; Power Supply; Gantry; (+) Z Axis (; Belt Adjusters; Spoilboard; X2 Stepper Motor; Finished Controller; Y Home Switch; Z Home Switch
