rlwoodjr/Router-Files/DRO/DRO Schematic.pdf

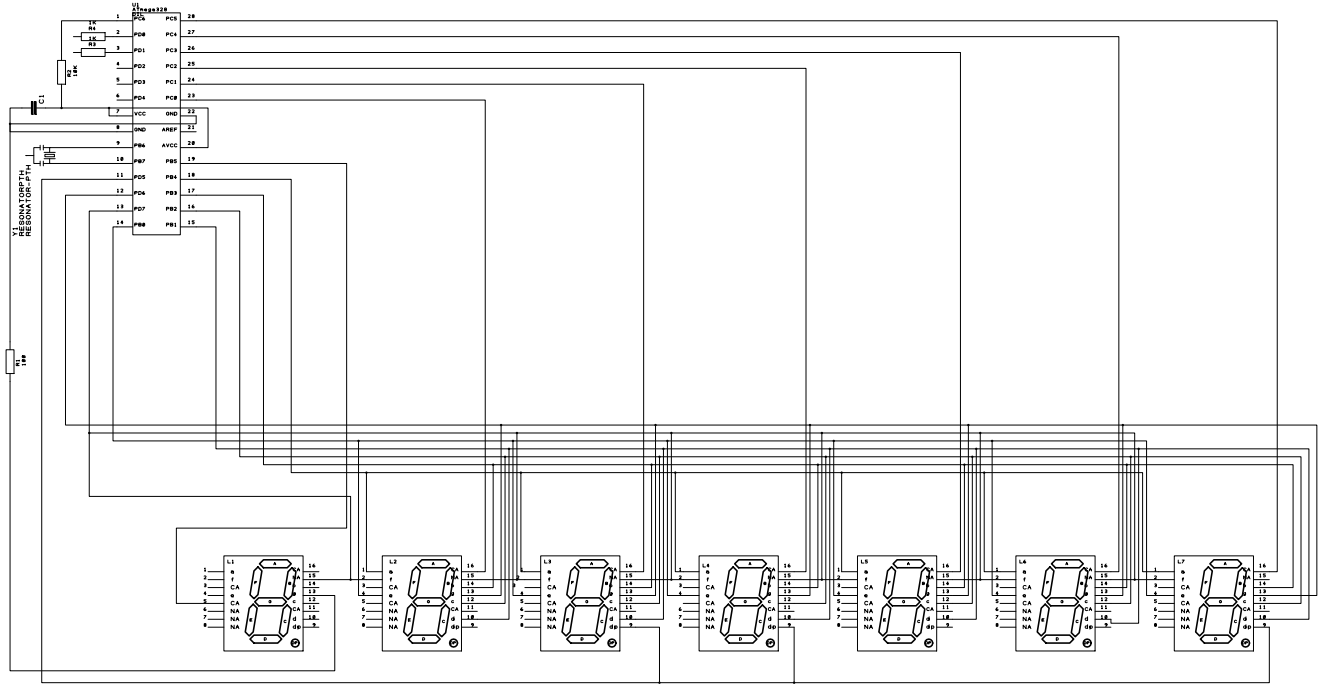
[picture p372: page 1]
