rlwoodjr/Router-Files/Quantum/Sourced Parts/T-track.pdf

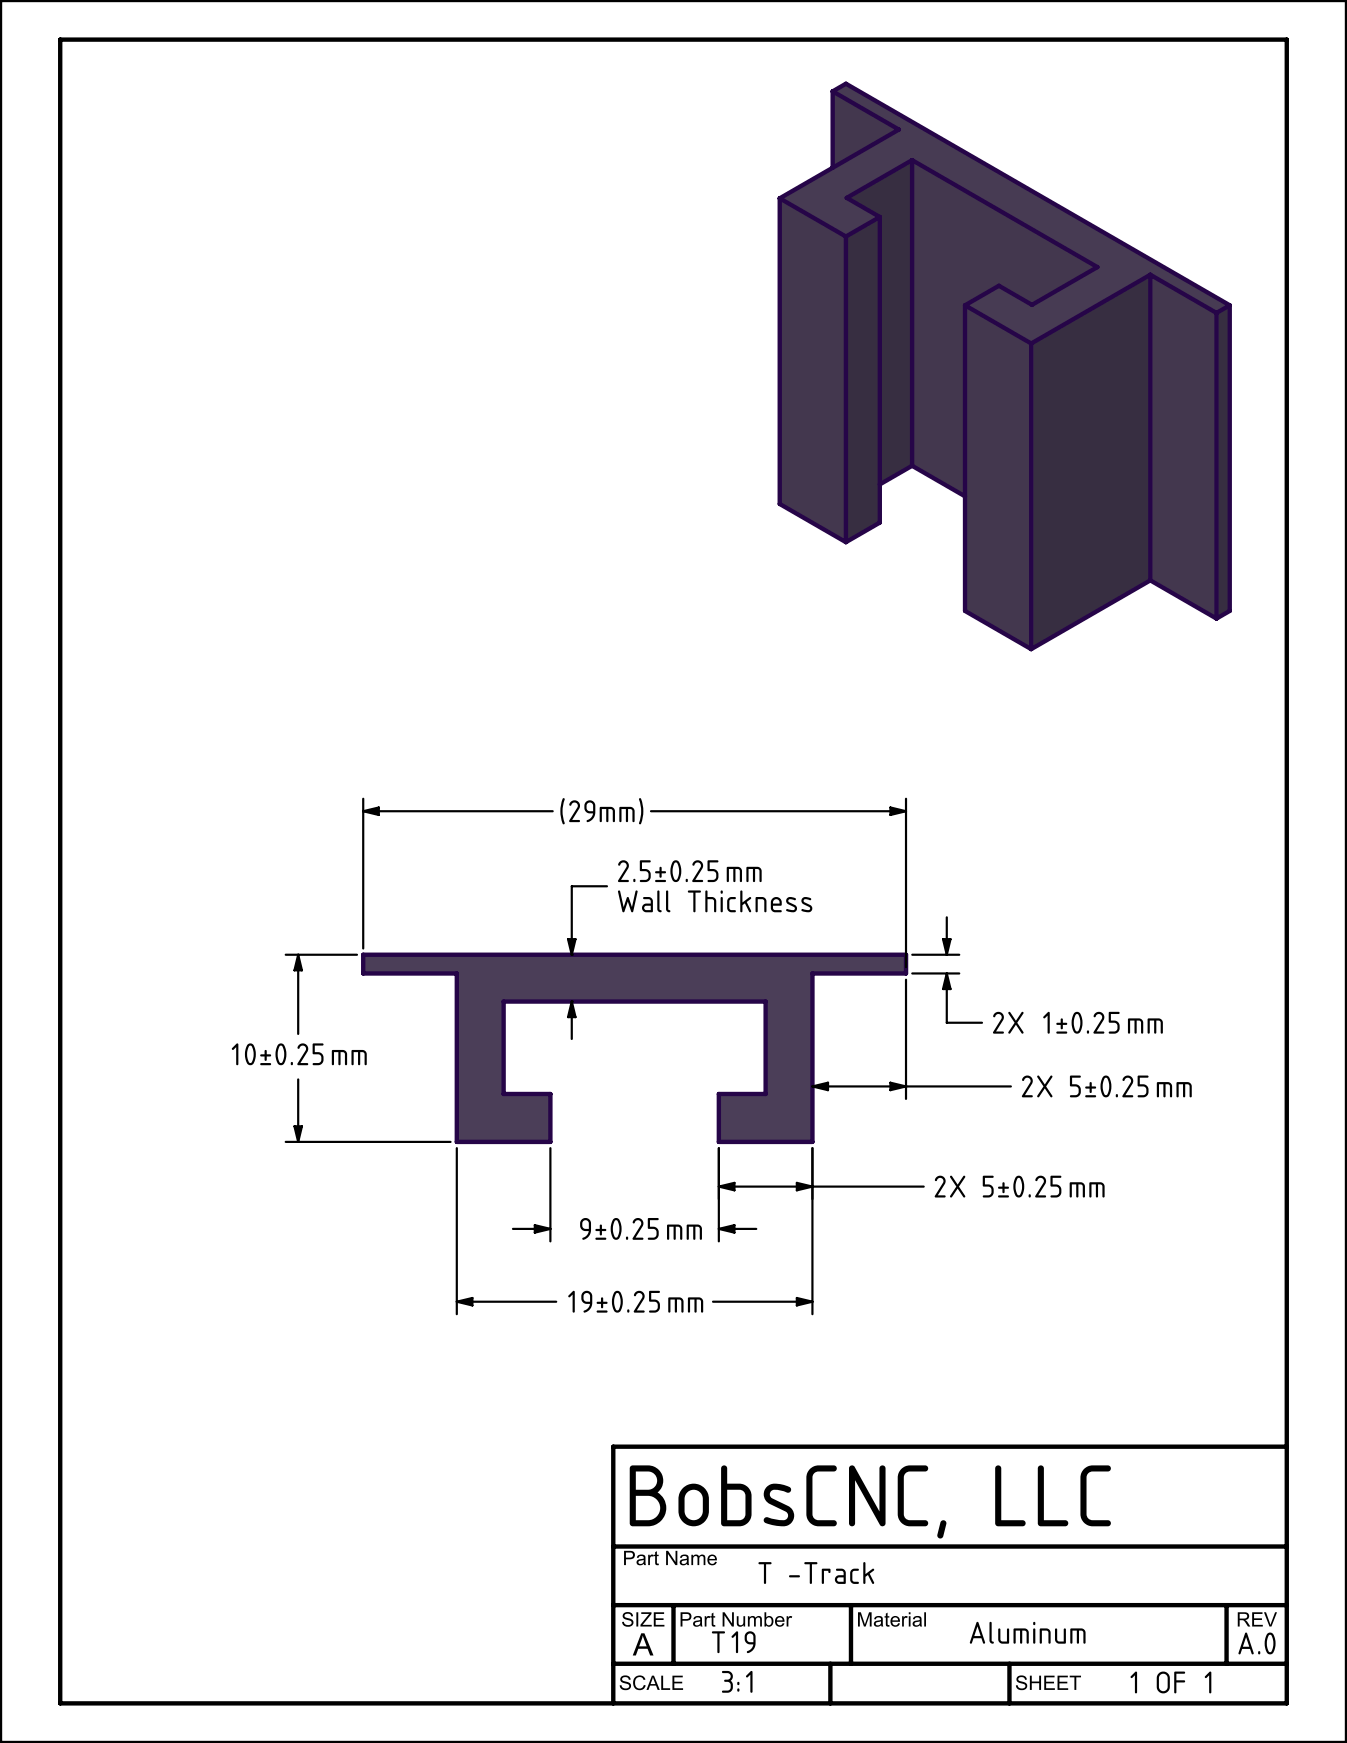
[picture p373: page 1]
