rlwoodjr/Router-Files/Evolution/Sourced Parts/EccentricNut.pdf

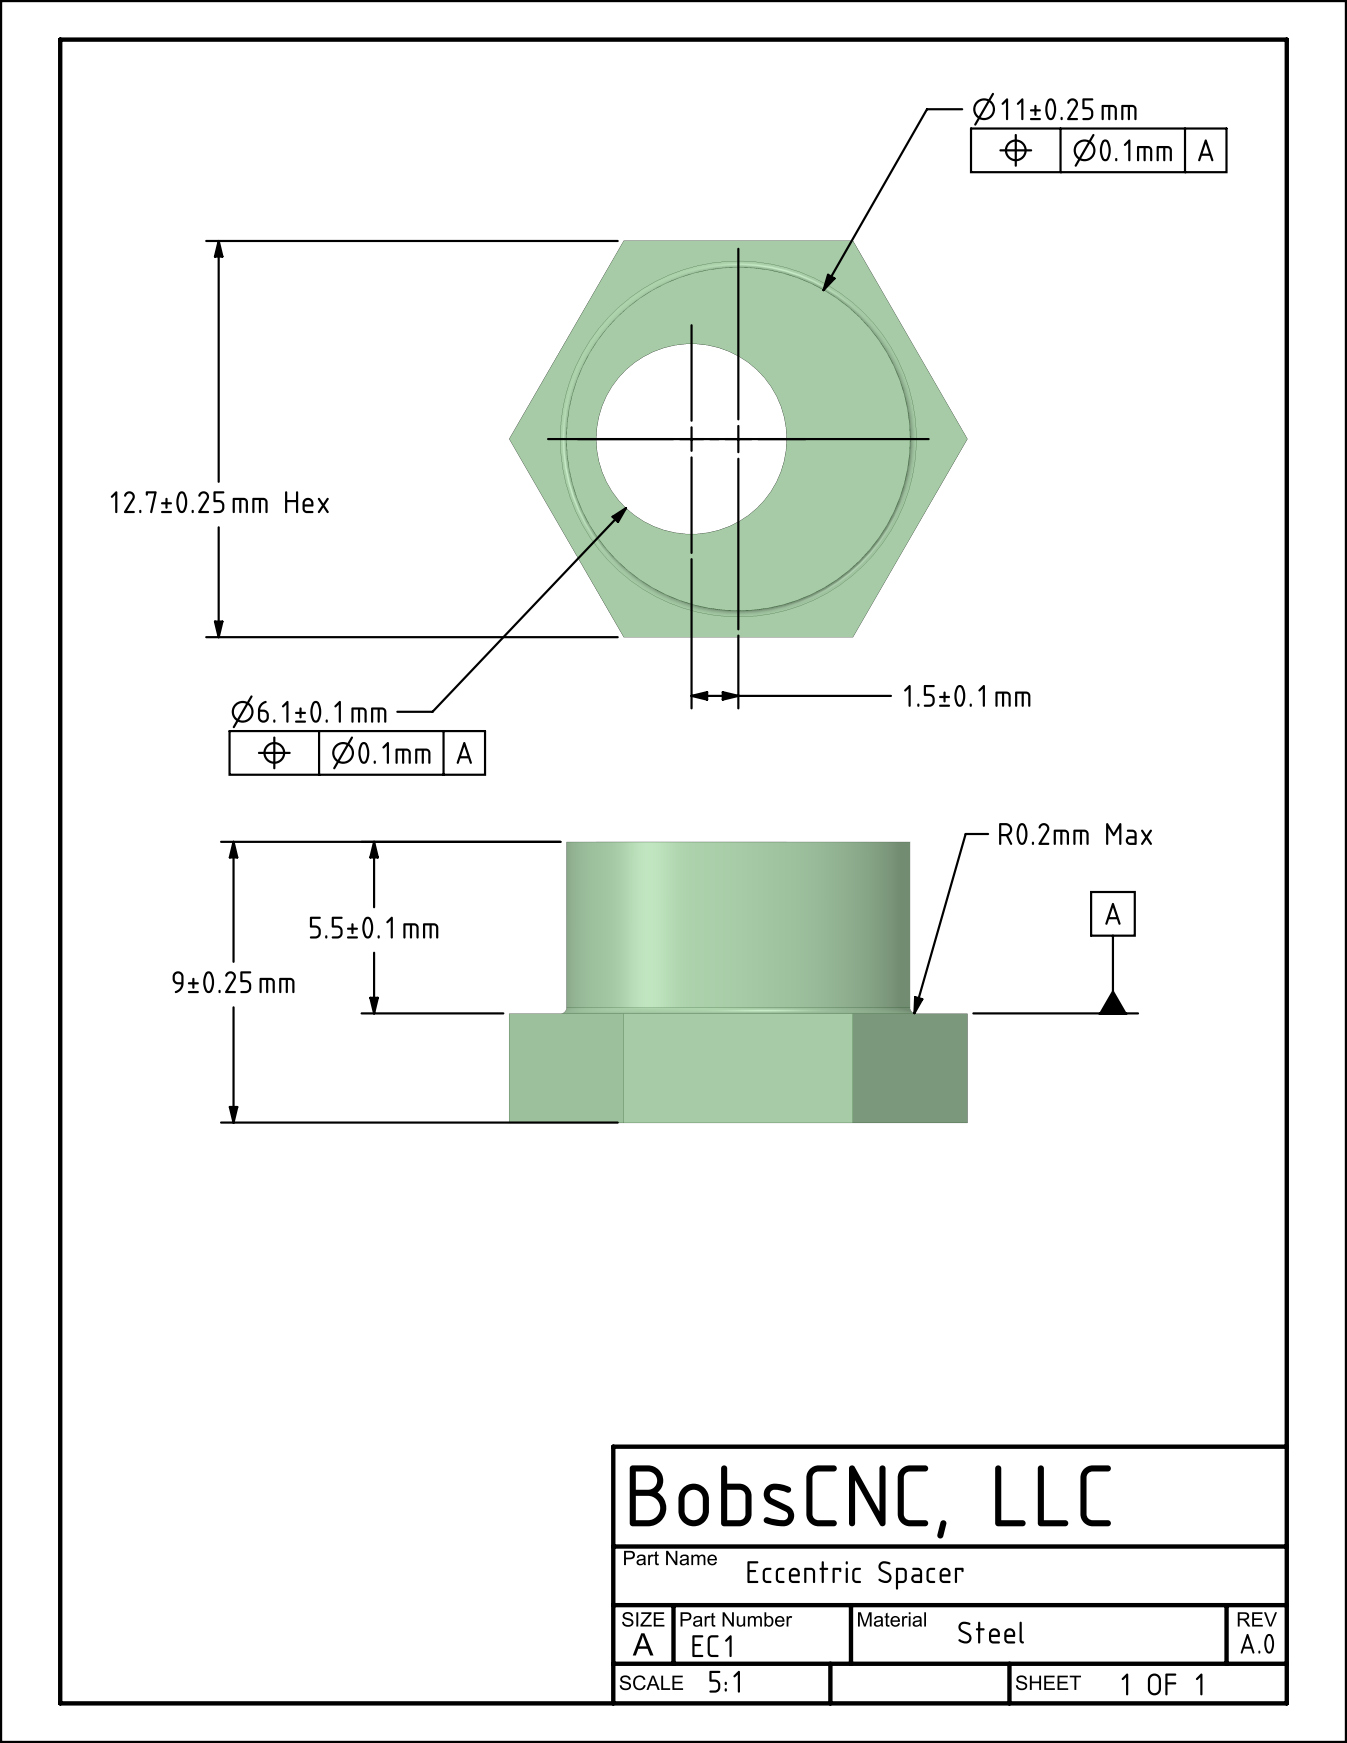
[picture p374: page 1]
