rlwoodjr/Router-Files/KL7/Sourced parts/Large Eccentric spacer.pdf

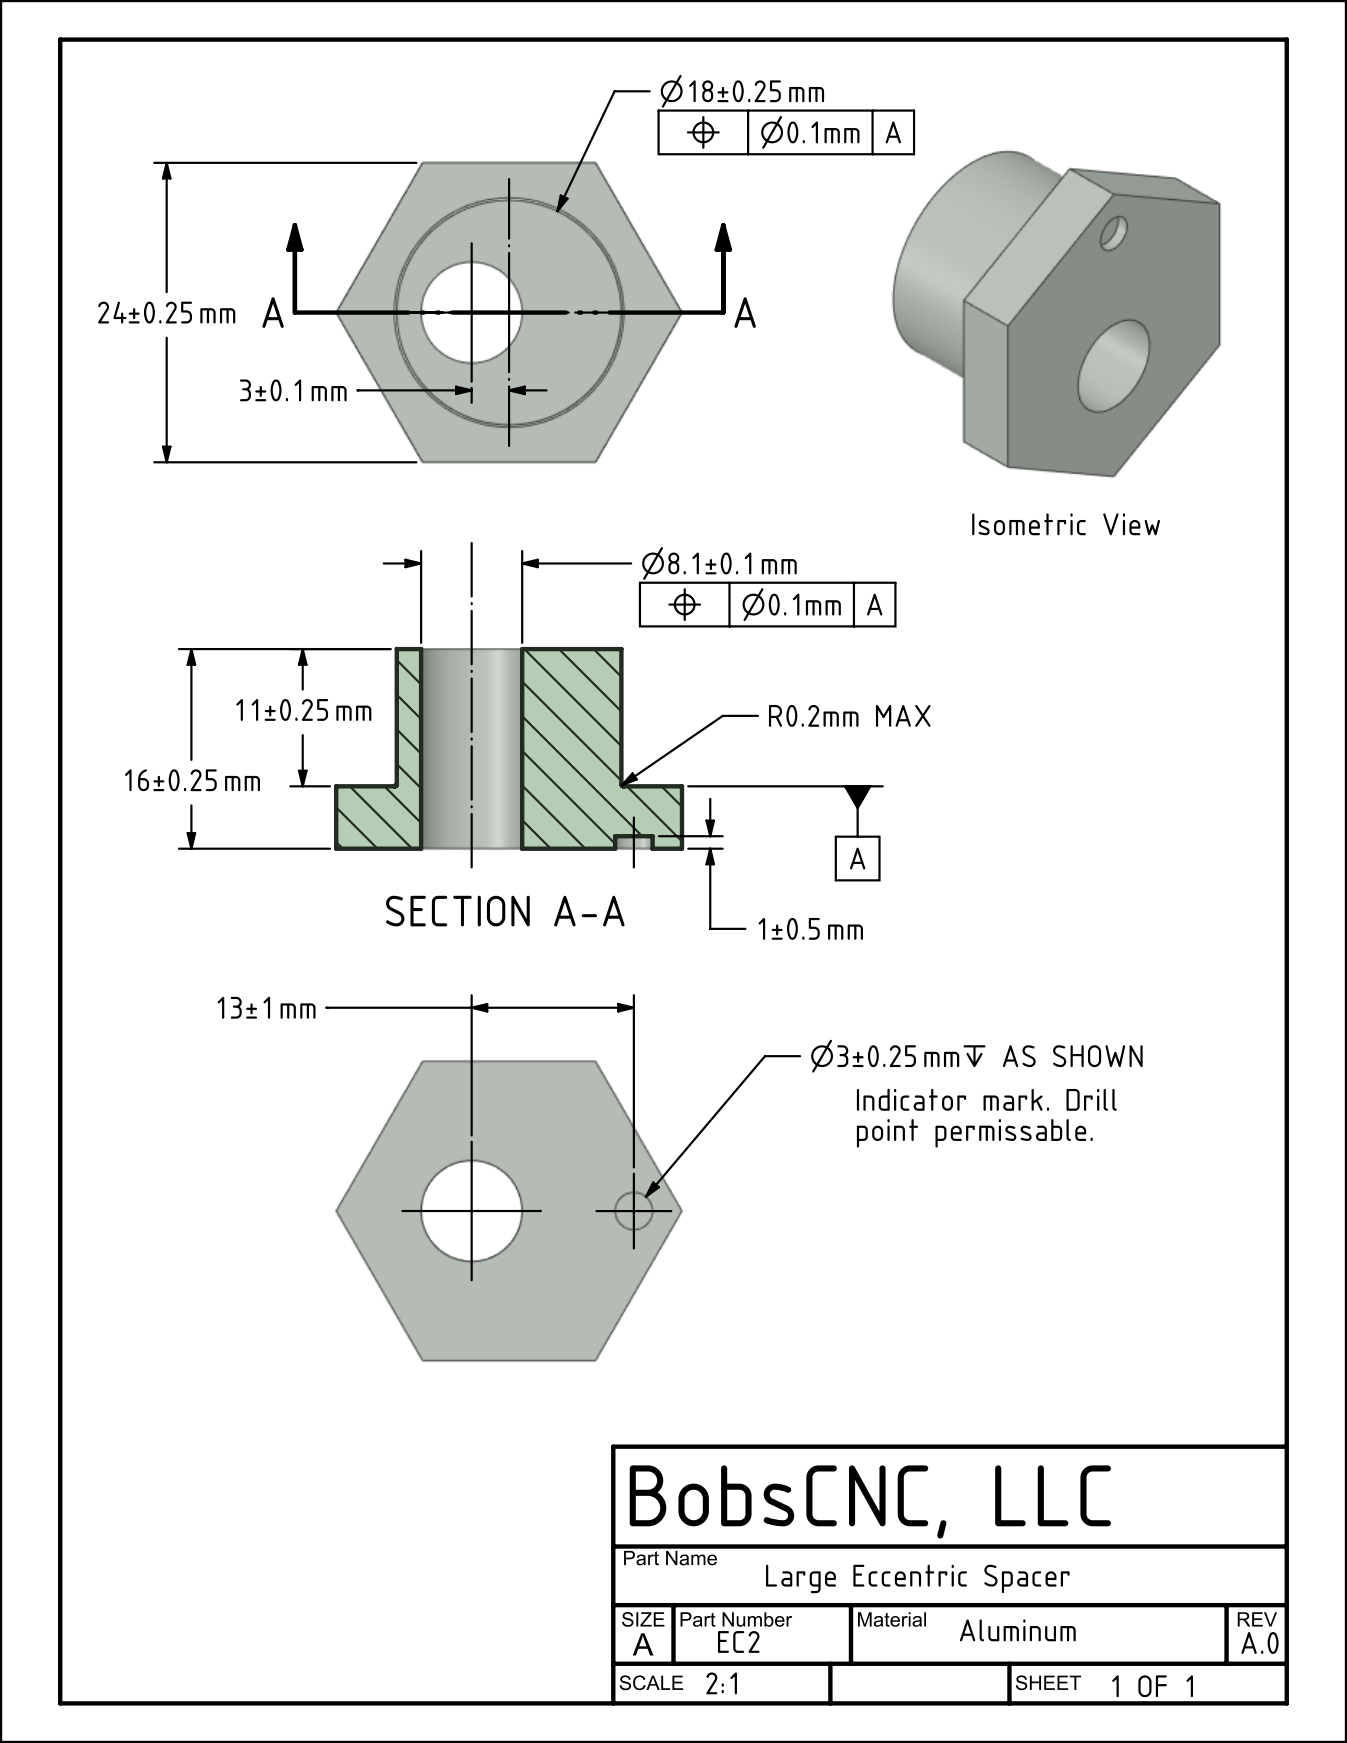
[picture p375: page 1]
