rlwoodjr/Router-Files/Revolution/Sourced parts/TailStock rod.pdf

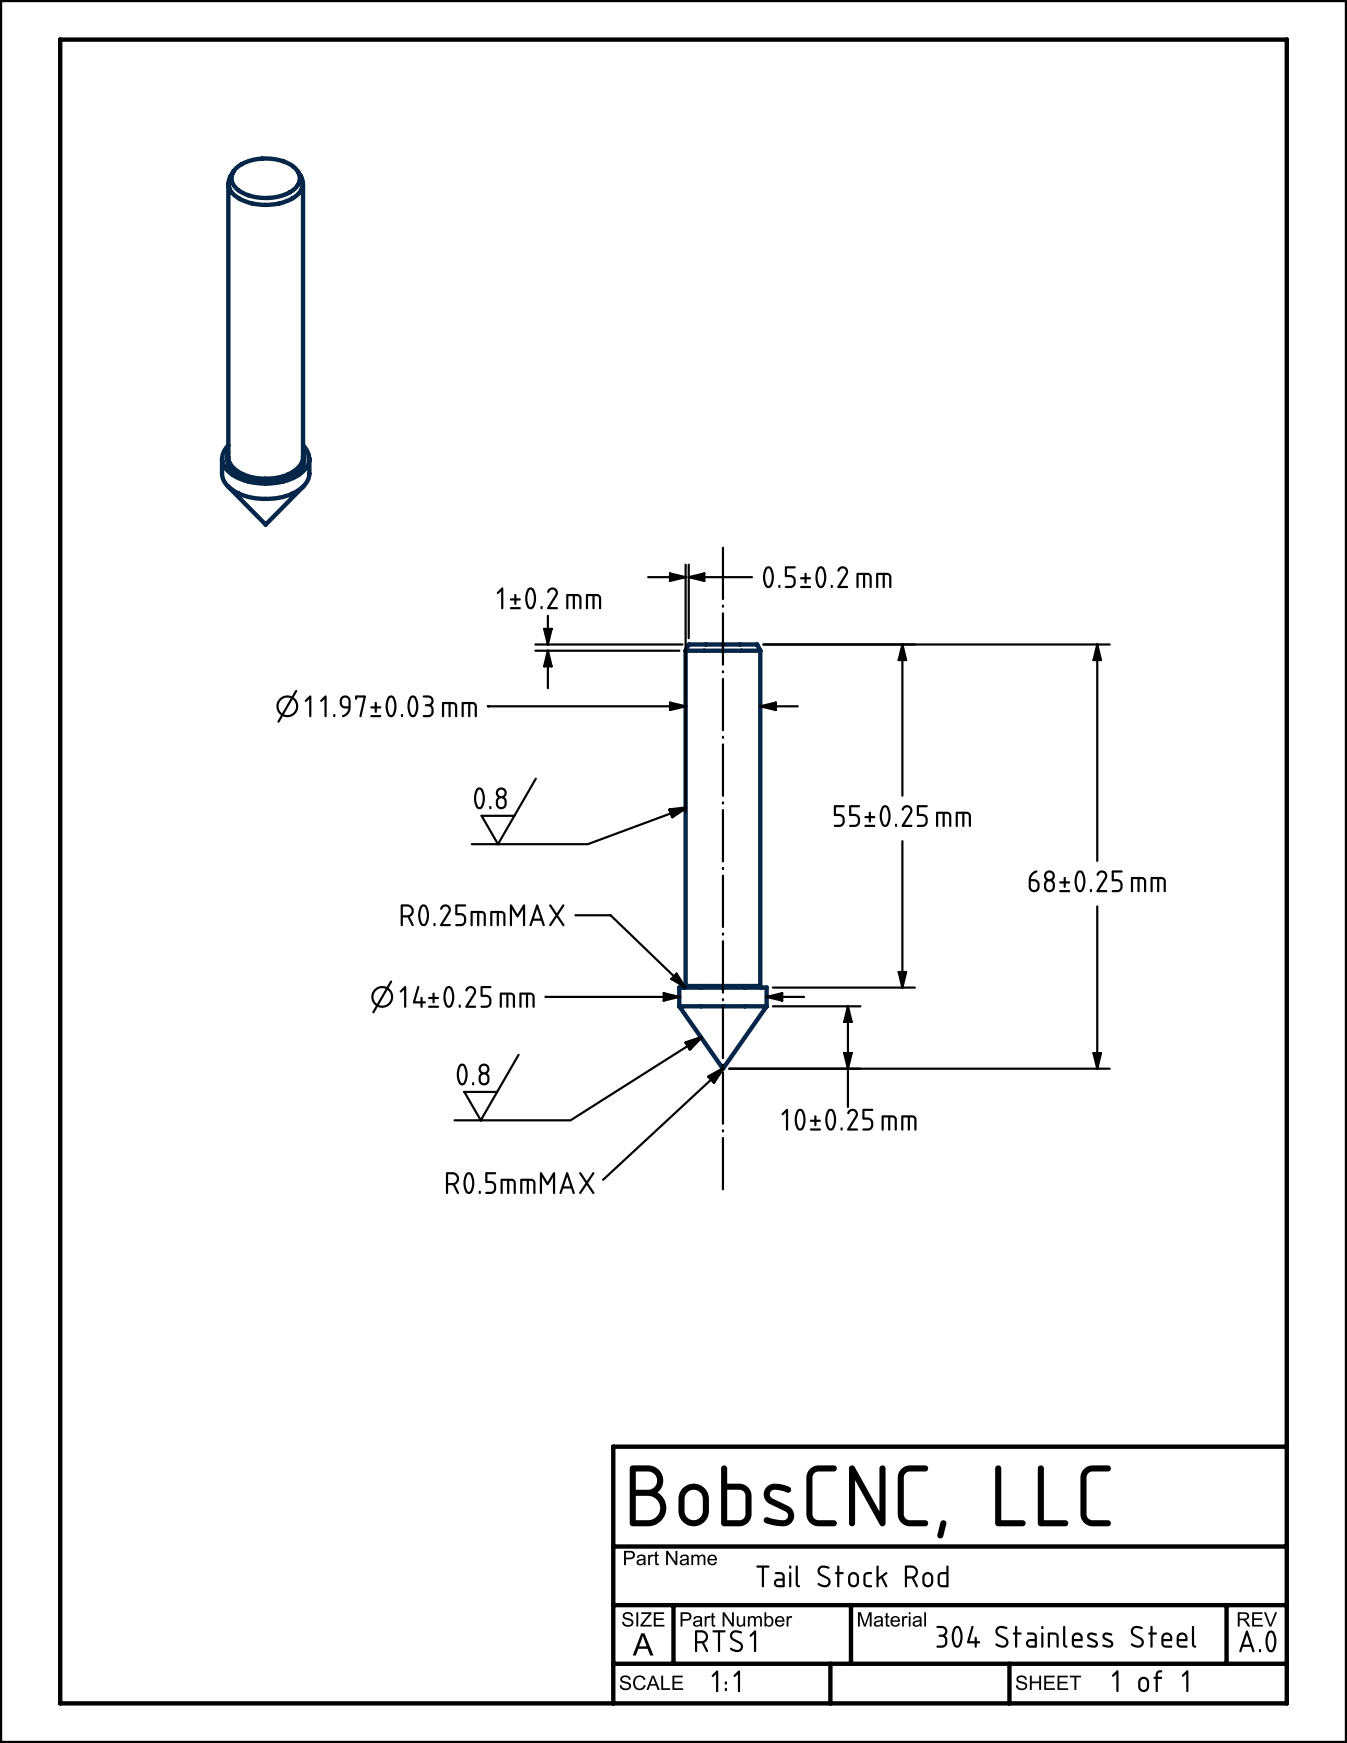
[picture p376: page 1]
