rlwoodjr/Router-Files/KL7/Sourced parts/BobsCNCidler B.1.pdf

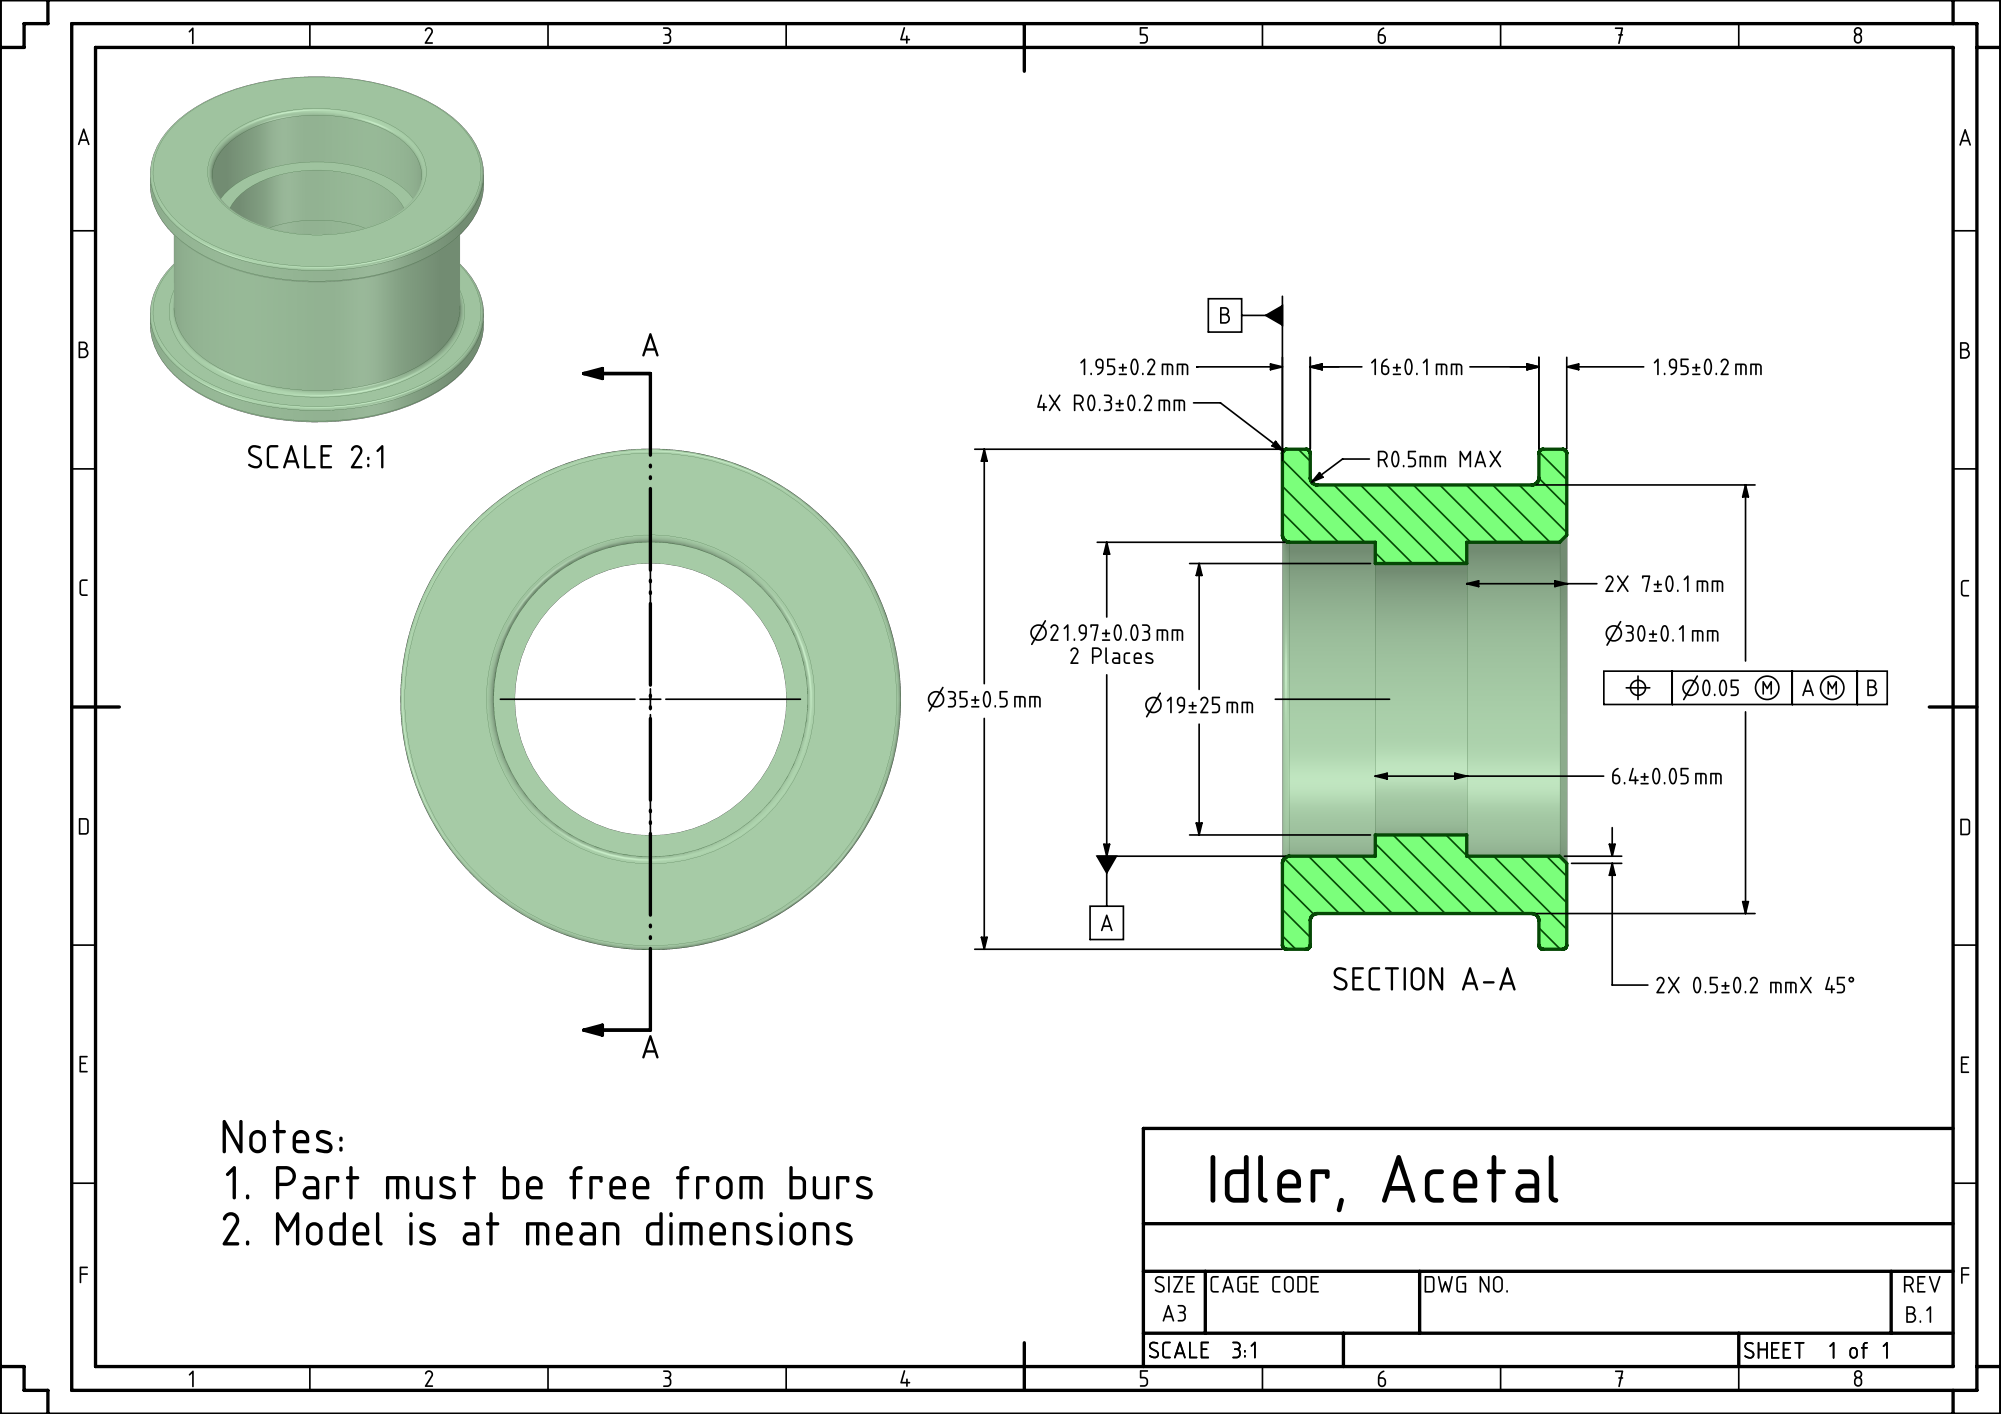
[picture p377: page 1]
