rlwoodjr/Router-Files/KL7/Sourced parts/Stepper motor belt mount.pdf

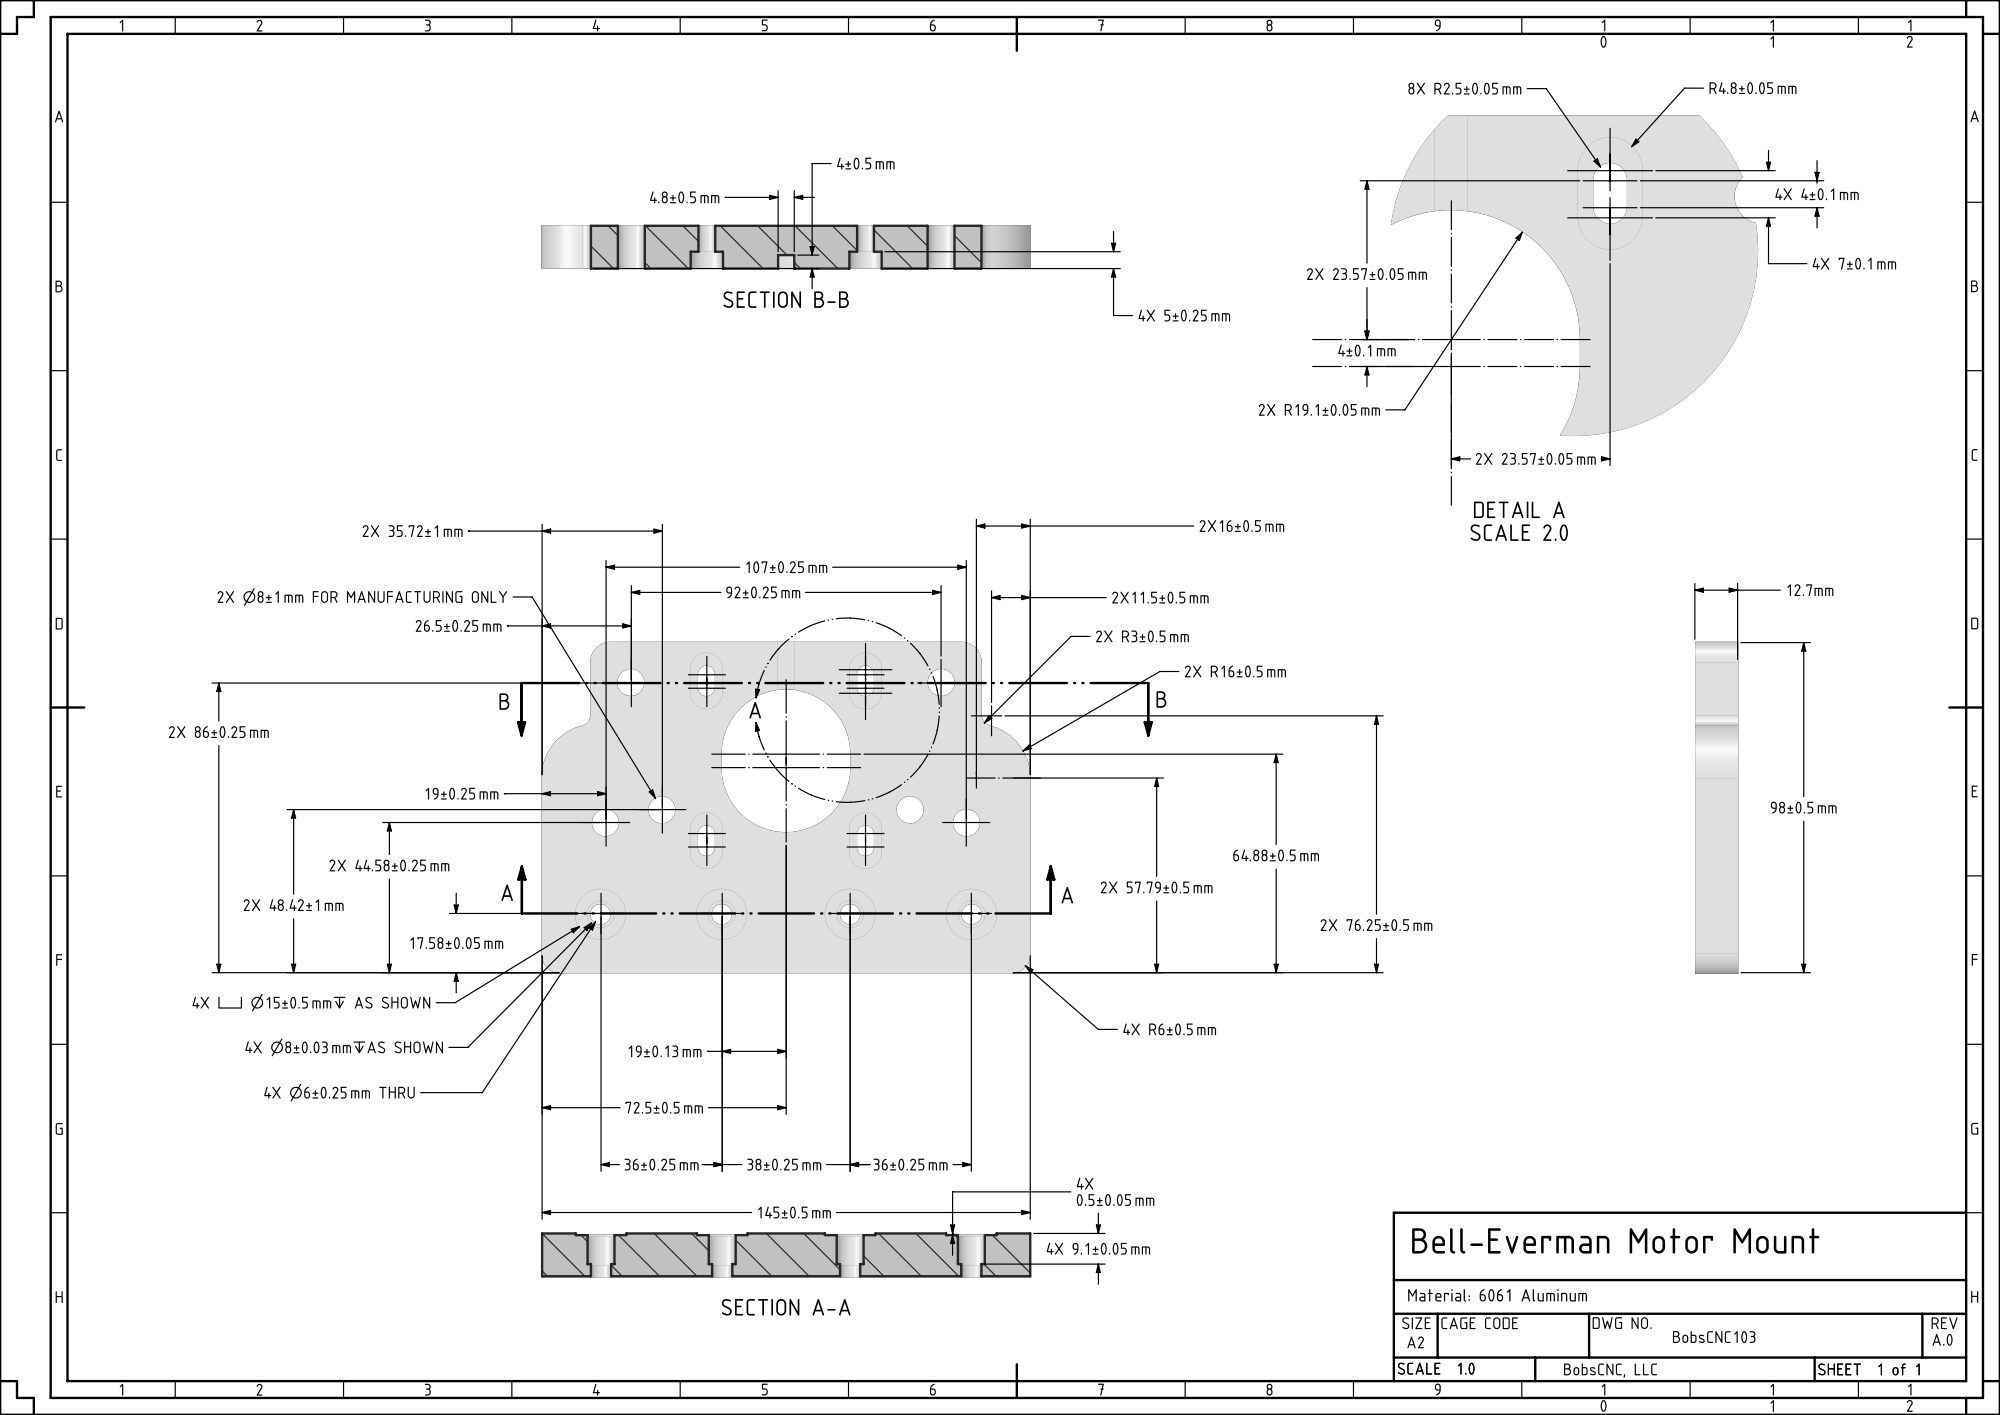
[picture p378: page 1]
