rlwoodjr/Router-Files/DRO/PCB.pdf

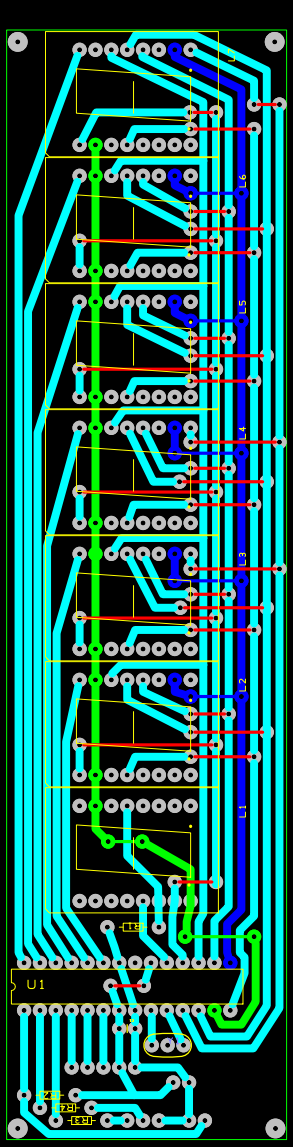
[picture p379: page 1]
