rlwoodjr/Router-Files/Other stuff/BT61revD.pdf

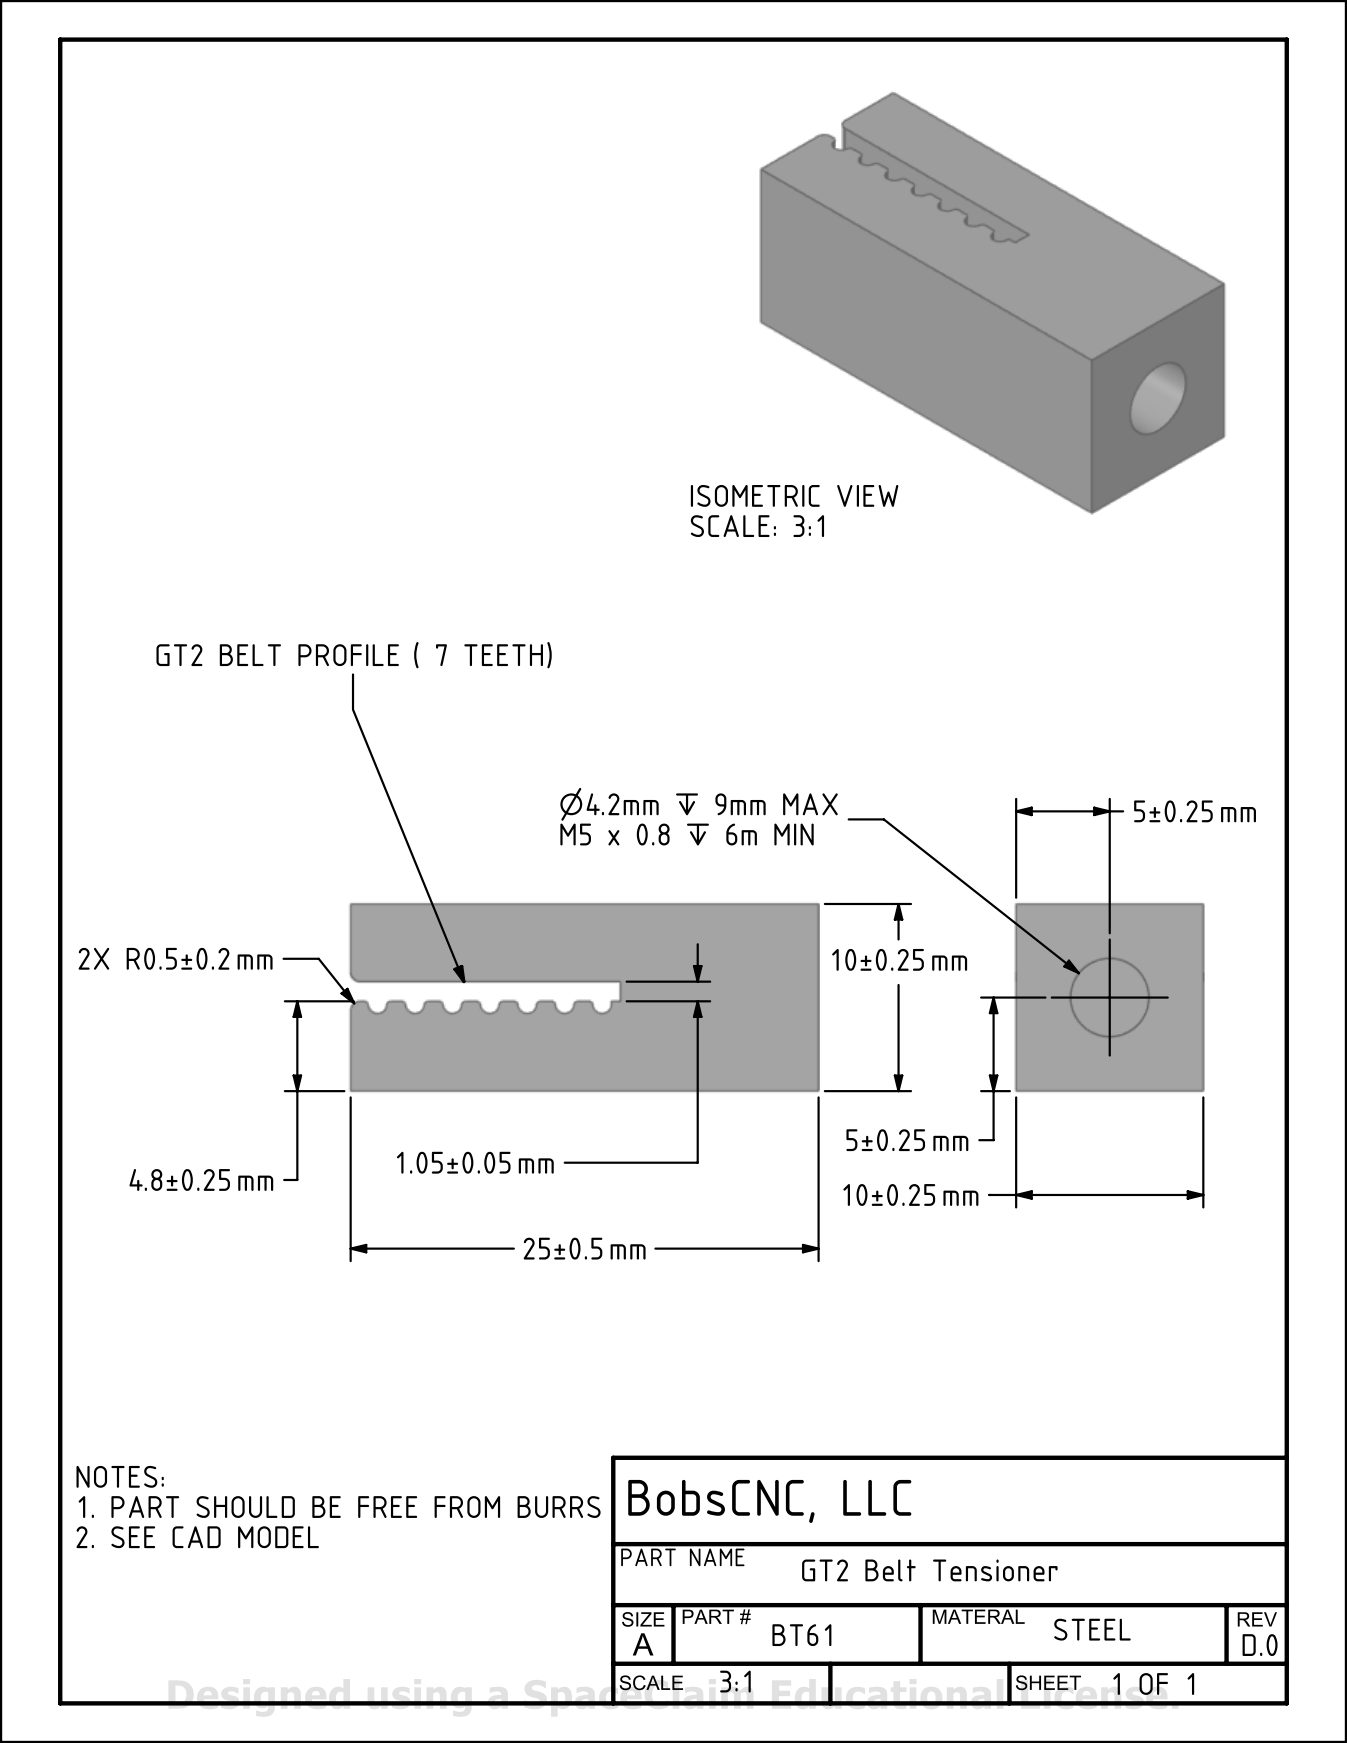
[picture p380: page 1]
