rlwoodjr/Router-Files/E Series/Spoilboard.pdf

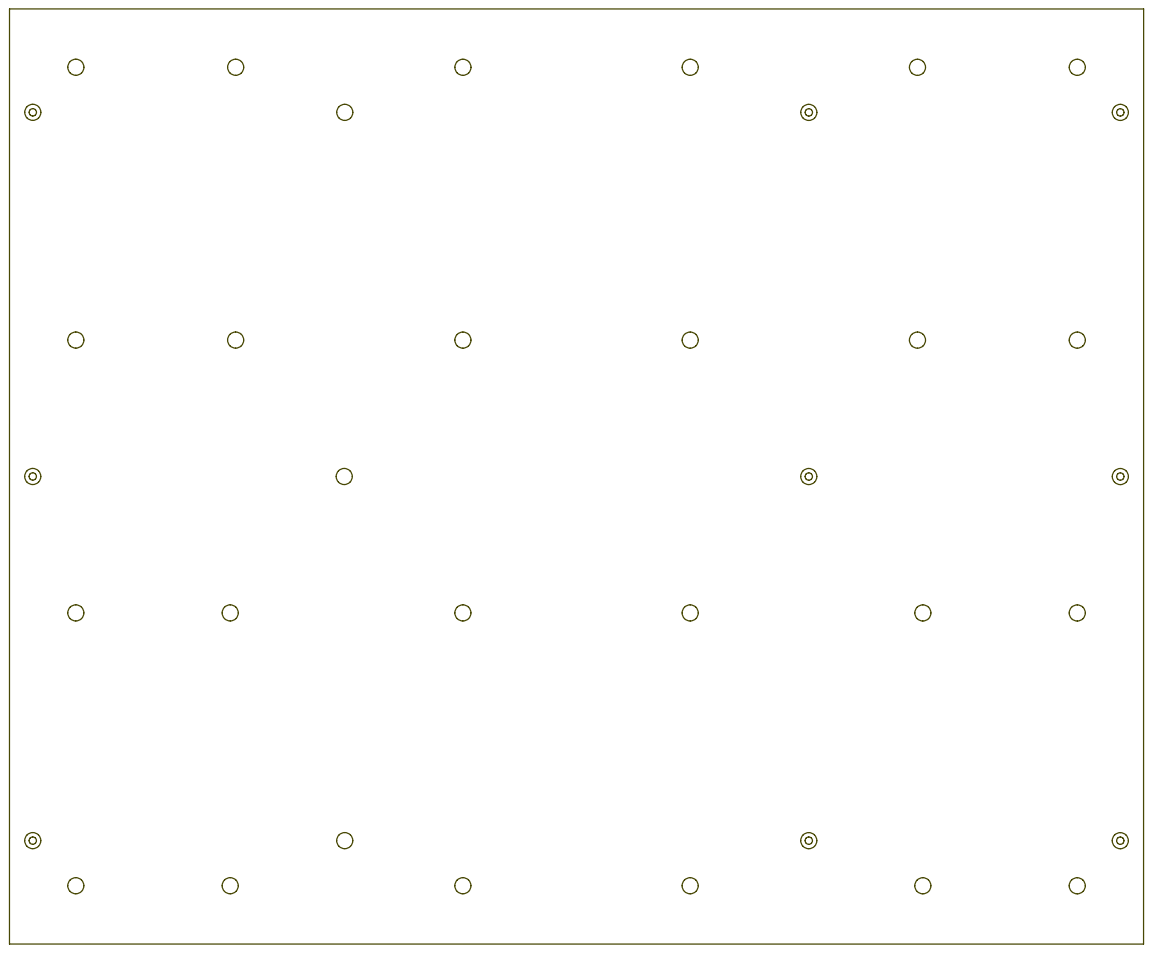
[picture p381: page 1]
