rlwoodjr/Router-Files/(commit log)

2025-02-15 More KL
    More KL
    [#KL744E1.dxf, #KL744E2.dxf, #kl744 EXT KIT table.dxf, 44TA.dxf, 44TB.dxf, Belt Pulley gage.dxf, DeWalt Spindle Mount.dxf, KL7 test.dxf]
2025-02-18 Add more files
    [E3D1.dxf, E3D2.dxf, E3M1.dxf, E3M2.dxf, E3V3L1.dxf, E4D1.dxf, E4D2.dxf, E4M1.dxf]
2025-02-18 More files
    [52mm layout Evolution.dxf, RT1101F Z Assembly.dxf, TramTool.stl]
2025-02-19 Evo Ext
    [Extension Layout.dxf, Extension Layout.stp]
2025-02-19 Evo 4 to 5
    [Extension Layout.dxf, Extension Layout.stp]
