rlwoodjr/Router-Files/KL7/KL RF1101/20231009_105413.jpg

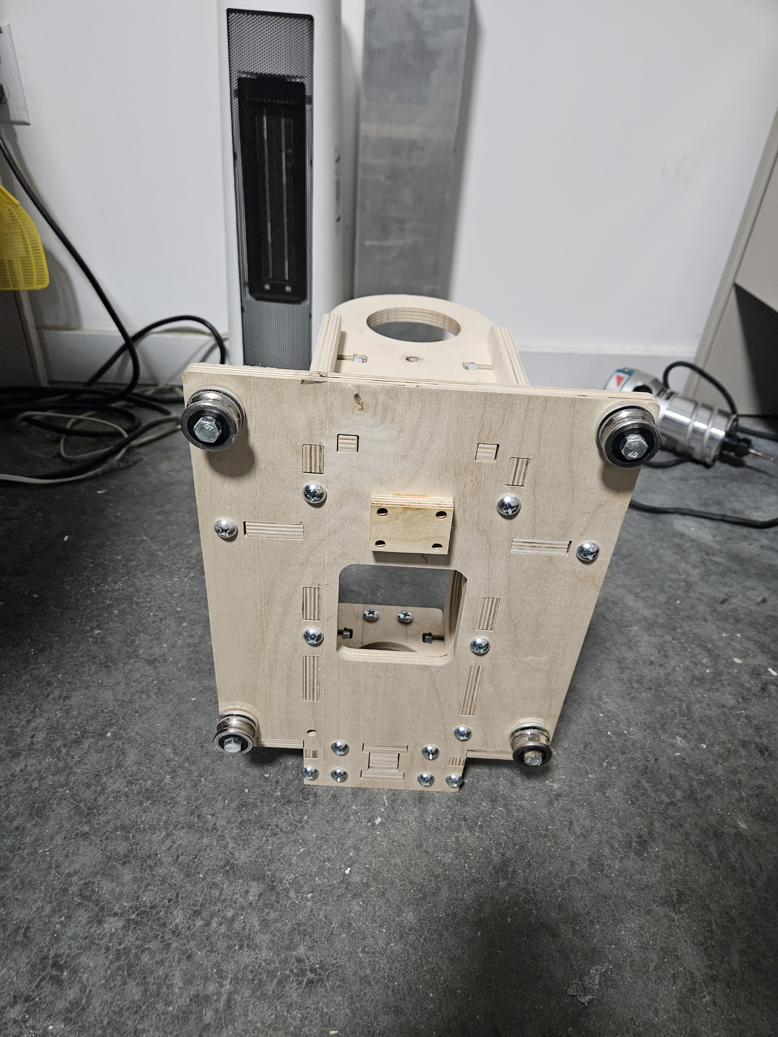
KL7/KL RF1101/20231009_105413.jpg
