rlwoodjr/Router-Files/KL7/KL RF1101/20231009_105421.jpg

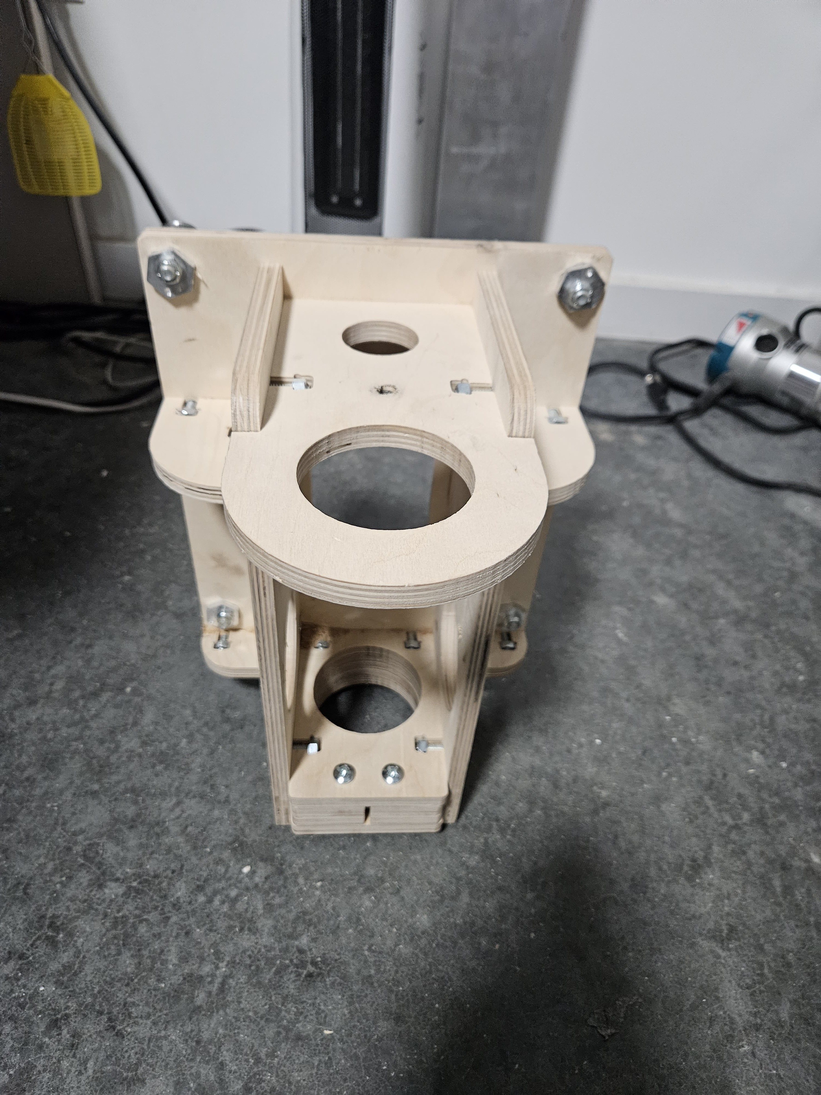
KL7/KL RF1101/20231009_105421.jpg
